elhep/CMOS_Camera/HL_SIM/results/thermal/sensor_brd.PNG

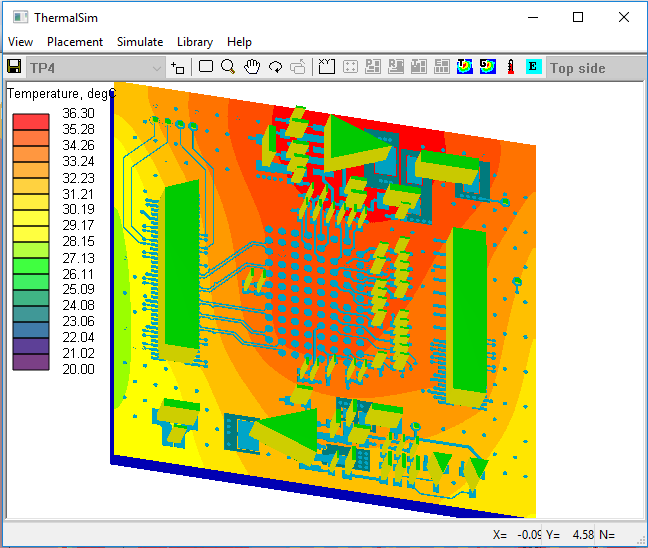
HL_SIM/results/thermal/sensor_brd.PNG
