elhep/CMOS_Camera/Spektrop2_Processor_Board_V1/docs/capacitors_gtp_placement.PNG

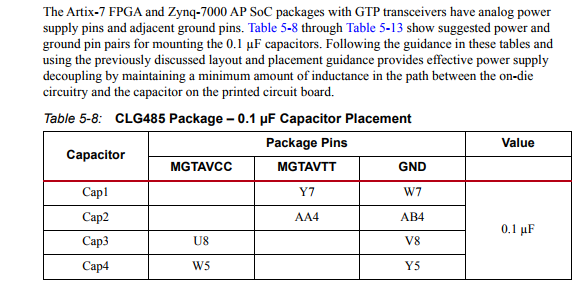
Spektrop2_Processor_Board_V1/docs/capacitors_gtp_placement.PNG
