elhep/CMOS_Camera/thesis/src/thesis.tex

\documentclass[a4paper,11pt,twoside]{report}
\usepackage[left=3cm,right=2cm,top=2.5cm,bottom=2.5cm]{geometry}
\include{thesis.preamble}

%Additional packages
\usepackage{pdfpages}
\usepackage{lipsum}
\usepackage{fontspec}
\setmainfont[Ligatures=TeX]{Arial}
\usepackage{acronym}
\usepackage[nonumberlist,nopostdot,toc]{glossaries}
%\usepackage{glossaries}
%\renewcommand{\glossarypreamble}{\scriptsize}
%\newcommand{\dictentry}[2]{%
%    \newglossaryentry{#1}{name=#1,description={#2}}%
%    \glslink{#1}{}%
%    \glsgroupskip
%}
\makeglossaries
\usepackage[toc,page]{appendix}

\begin{document}

%\title{\LARGE {\bf Compact embedded camera design and evaluation of high speed interfaces for hyper-spectral imaging applications}\\
% \vspace*{6mm}
%}

\author{Piotr Zdunek}
\submitdate{Warsaw, 2018}

%\normallinespacing
\linespread{1.15}
\pagenumbering{arabic}
\setlength{\parskip}{2ex plus 0.5ex minus 0.2ex}
\setlength{\parindent}{0.5cm}
%\maketitle

%TODO list of figures and tables needs to go at the end
%TODO put the numbers of pages on the sides  
%TODO change the font to times new roman
%\preface

\input{titlepage/titlepage}
\cleardoublepage
\input{abstract/abstract} %summary
\cleardoublepage
\includepdf[pages=-]{./titlepage/osw.pdf}
\pagestyle{empty}
\cleardoublepage
\tableofcontents
\newpage

\newglossaryentry{formula}
{
        name=formula,
        description={A mathematical expression}
}
 
\newacronym{gcd}{GCD}{Greatest Common Divisor}

%\body
\input{introduction/introduction}
%Here the whole genesis and the requirements of the projects are stated and defined. 
%After reading this chapter, the reader must understand what is going to be designed. 
%\input{genesis/genesis}
\input{concept/concept}
%How are we going to design it and what do we want to test
%\input{requirements/requirements}
\input{realisation/realisation}
%The development of the camera. 
\input{evaluation/evaluation}
%The tests of high speed interfaces.
\input{summary/summary}
%What is the outcome?
\gls{formula}

\addcontentsline{toc}{chapter}{Bibliography}
\bibliographystyle{unsrt}
\bibliography{bibliography/bibliography}

%glossary
\printglossary
%table of pictures 
\listoffigures
%list of appendices
\begin{appendices}
\chapter{Electrical characteristics}
The contents...
\chapter{Test }
The contents...
\end{appendices}
% appendices come here

\end{document}
