elhep/CMOS_Camera/thesis/src/abstract/abstract.tex

\begin{abstract}

Text of the Abstract.
%\lipsum[3-56]

Keywords: Camera, High-speed, Hyper-Spectral, Zynq, SDI, CoaXPress, PCIe, Aurora

\end{abstract}
