elhep/CMOS_Camera/Vivado/Spektrop2_CMV4000_V3/Spektrop2_CMV4000_V2.runs/design_1_v_vid_in_axi4s_0_0_synth_1/.vivado.begin.rst

<?xml version="1.0"?>
<ProcessHandle Version="1" Minor="0">
    <Process Command="vivado.bat" Owner="ZdunekPC" Host="DESKTOP-C5LKN8N" Pid="11436">
    </Process>
</ProcessHandle>
