elhep/CMOS_Camera/Vivado/Spektrop2_CMV4000_V3/Spektrop2_CMV4000_V2.ip_user_files/sim_scripts/sensor_readout/activehdl/file_info.txt

xpm_cdc.sv,systemverilog,xil_defaultlib,E:/Xilinx/Vivado/2017.4/data/ip/xpm/xpm_cdc/hdl/xpm_cdc.sv,incdir="../../../../Spektrop2_CMV4000_V2.srcs/sources_1/bd/sensor_readout/ipshared/0ab1/hdl"incdir="../../../../Spektrop2_CMV4000_V2.srcs/sources_1/bd/sensor_readout/ipshared/0ab1/hdl"
xpm_fifo.sv,systemverilog,xil_defaultlib,E:/Xilinx/Vivado/2017.4/data/ip/xpm/xpm_fifo/hdl/xpm_fifo.sv,incdir="../../../../Spektrop2_CMV4000_V2.srcs/sources_1/bd/sensor_readout/ipshared/0ab1/hdl"incdir="../../../../Spektrop2_CMV4000_V2.srcs/sources_1/bd/sensor_readout/ipshared/0ab1/hdl"
xpm_memory.sv,systemverilog,xil_defaultlib,E:/Xilinx/Vivado/2017.4/data/ip/xpm/xpm_memory/hdl/xpm_memory.sv,incdir="../../../../Spektrop2_CMV4000_V2.srcs/sources_1/bd/sensor_readout/ipshared/0ab1/hdl"incdir="../../../../Spektrop2_CMV4000_V2.srcs/sources_1/bd/sensor_readout/ipshared/0ab1/hdl"
xpm_VCOMP.vhd,vhdl,xpm,E:/Xilinx/Vivado/2017.4/data/ip/xpm/xpm_VCOMP.vhd,incdir="../../../../Spektrop2_CMV4000_V2.srcs/sources_1/bd/sensor_readout/ipshared/0ab1/hdl"incdir="../../../../Spektrop2_CMV4000_V2.srcs/sources_1/bd/sensor_readout/ipshared/0ab1/hdl"
v_vid_in_axi4s_v4_0_vl_rfs.v,verilog,v_vid_in_axi4s_v4_0_7,../../../../Spektrop2_CMV4000_V2.srcs/sources_1/bd/sensor_readout/ipshared/f931/hdl/v_vid_in_axi4s_v4_0_vl_rfs.v,incdir="../../../../Spektrop2_CMV4000_V2.srcs/sources_1/bd/sensor_readout/ipshared/0ab1/hdl"incdir="../../../../Spektrop2_CMV4000_V2.srcs/sources_1/bd/sensor_readout/ipshared/0ab1/hdl"
sensor_readout_v_vid_in_axi4s_0_0.v,verilog,xil_defaultlib,../../../bd/sensor_readout/ip/sensor_readout_v_vid_in_axi4s_0_0/sim/sensor_readout_v_vid_in_axi4s_0_0.v,incdir="../../../../Spektrop2_CMV4000_V2.srcs/sources_1/bd/sensor_readout/ipshared/0ab1/hdl"incdir="../../../../Spektrop2_CMV4000_V2.srcs/sources_1/bd/sensor_readout/ipshared/0ab1/hdl"
sensor_readout_v_vid_in_axi4s_0_1.v,verilog,xil_defaultlib,../../../bd/sensor_readout/ip/sensor_readout_v_vid_in_axi4s_0_1/sim/sensor_readout_v_vid_in_axi4s_0_1.v,incdir="../../../../Spektrop2_CMV4000_V2.srcs/sources_1/bd/sensor_readout/ipshared/0ab1/hdl"incdir="../../../../Spektrop2_CMV4000_V2.srcs/sources_1/bd/sensor_readout/ipshared/0ab1/hdl"
axis_infrastructure_v1_1_vl_rfs.v,verilog,axis_infrastructure_v1_1_0,../../../../Spektrop2_CMV4000_V2.srcs/sources_1/bd/sensor_readout/ipshared/0ab1/hdl/axis_infrastructure_v1_1_vl_rfs.v,incdir="../../../../Spektrop2_CMV4000_V2.srcs/sources_1/bd/sensor_readout/ipshared/0ab1/hdl"incdir="../../../../Spektrop2_CMV4000_V2.srcs/sources_1/bd/sensor_readout/ipshared/0ab1/hdl"
axis_combiner_v1_1_vl_rfs.v,verilog,axis_combiner_v1_1_14,../../../../Spektrop2_CMV4000_V2.srcs/sources_1/bd/sensor_readout/ipshared/cf24/hdl/axis_combiner_v1_1_vl_rfs.v,incdir="../../../../Spektrop2_CMV4000_V2.srcs/sources_1/bd/sensor_readout/ipshared/0ab1/hdl"incdir="../../../../Spektrop2_CMV4000_V2.srcs/sources_1/bd/sensor_readout/ipshared/0ab1/hdl"
sensor_readout_axis_combiner_0_0.v,verilog,xil_defaultlib,../../../bd/sensor_readout/ip/sensor_readout_axis_combiner_0_0/sim/sensor_readout_axis_combiner_0_0.v,incdir="../../../../Spektrop2_CMV4000_V2.srcs/sources_1/bd/sensor_readout/ipshared/0ab1/hdl"incdir="../../../../Spektrop2_CMV4000_V2.srcs/sources_1/bd/sensor_readout/ipshared/0ab1/hdl"
axis_register_slice_v1_1_vl_rfs.v,verilog,axis_register_slice_v1_1_15,../../../../Spektrop2_CMV4000_V2.srcs/sources_1/bd/sensor_readout/ipshared/cd45/hdl/axis_register_slice_v1_1_vl_rfs.v,incdir="../../../../Spektrop2_CMV4000_V2.srcs/sources_1/bd/sensor_readout/ipshared/0ab1/hdl"incdir="../../../../Spektrop2_CMV4000_V2.srcs/sources_1/bd/sensor_readout/ipshared/0ab1/hdl"
axis_dwidth_converter_v1_1_vl_rfs.v,verilog,axis_dwidth_converter_v1_1_14,../../../../Spektrop2_CMV4000_V2.srcs/sources_1/bd/sensor_readout/ipshared/1019/hdl/axis_dwidth_converter_v1_1_vl_rfs.v,incdir="../../../../Spektrop2_CMV4000_V2.srcs/sources_1/bd/sensor_readout/ipshared/0ab1/hdl"incdir="../../../../Spektrop2_CMV4000_V2.srcs/sources_1/bd/sensor_readout/ipshared/0ab1/hdl"
sensor_readout_axis_dwidth_converter_0_0.v,verilog,xil_defaultlib,../../../bd/sensor_readout/ip/sensor_readout_axis_dwidth_converter_0_0/sim/sensor_readout_axis_dwidth_converter_0_0.v,incdir="../../../../Spektrop2_CMV4000_V2.srcs/sources_1/bd/sensor_readout/ipshared/0ab1/hdl"incdir="../../../../Spektrop2_CMV4000_V2.srcs/sources_1/bd/sensor_readout/ipshared/0ab1/hdl"
sensor_readout.vhd,vhdl,xil_defaultlib,../../../bd/sensor_readout/sim/sensor_readout.vhd,incdir="../../../../Spektrop2_CMV4000_V2.srcs/sources_1/bd/sensor_readout/ipshared/0ab1/hdl"incdir="../../../../Spektrop2_CMV4000_V2.srcs/sources_1/bd/sensor_readout/ipshared/0ab1/hdl"
glbl.v,Verilog,xil_defaultlib,glbl.v
