elhep/CMOS_Camera/thesis/src/thesis.pdf

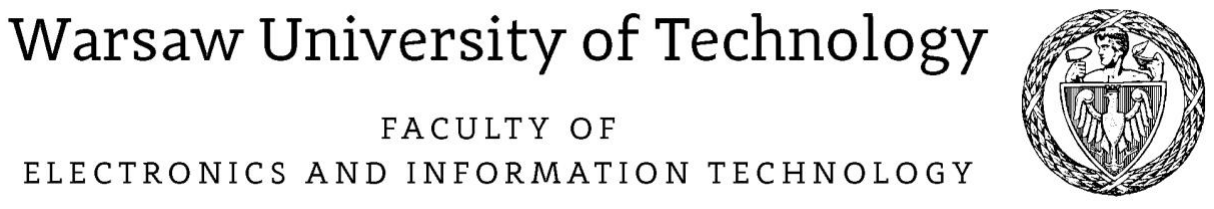
[picture p3: figure]

Institute of Electronic Systems

in the field of study Electronics and specialisation Microsystems and electronic systems

## Compact embedded camera and evaluation of high speed interfaces for hyper-spectral imaging applications

# Piotr Zdunek

student record book number 229417

Dr inż. Grzegorz Kasprowicz

Warsaw, 2018

Abstract

Text of the Abstract.

Keywords: Camera, High-speed, Hyper-Spectral, Zynq, SDI, CoaXPress, PCIe, Aurora

załącznik nr 10 do zarządzenia nr 46 /2016 Rektora PW

## Politechnika Warszawska

Warsaw University of Technology

### miejscowość i data

place and date

## Piotr Zdunek

### imię i nazwisko studenta

name and surname of the student

229417

### numer albumu

student record book number

## Elektronika

### kierunek studiów

field of study

## OŚWIADCZENIE

### DECLARATION

Świadomy/-a odpowiedzialności karnej za składanie fałszywych zeznań oświadczam,

## że niniejsza praca dyplomowa została napisana przeze mnie samodzielnie, pod opieką

kierującego pracą dyplomową.
Under the penalty of perjury, I hereby certify that I wrote my diploma thesis on my own, under the guidance of the thesis supervisor.

## Jednocześnie oświadczam, że:

### I also declare that:

## - niniejsza praca dyplomowa nie narusza praw autorskich w rozumieniu ustawy z dnia

4 lutego 1994 roku o prawie autorskim i prawach pokrewnych (Dz.U. z 2006 r. Nr 90, poz. 631 z późn. zm.) oraz dóbr osobistych chronionych prawem cywilnym,
- this diploma thesis does not constitute infringement of copyright following the act of 4 February 1994 on copyright and related rights (Journal of Acts of 2006 no. 90, item 631 with further amendments) or personal rights protected under the civil law,

## - niniejsza praca dyplomowa nie zawiera danych i informacji, które uzyskałem/-am

w sposób niedozwolony,
- the diploma thesis does not contain data or information acquired in an illegal way,

## - niniejsza praca dyplomowa nie była wcześniej podstawą żadnej innej urzędowej

procedury związanej z nadawaniem dyplomów lub tytułów zawodowych,
- the diploma thesis has never been the basis of any other official proceedings leading to the award of diplomas or professional degrees,

## - wszystkie informacje umieszczone w niniejszej pracy, uzyskane ze źródeł pisanych i elektronicznych, zostały udokumentowane w wykazie literatury odpowiednimi

odnośnikami,
- all information included in the diploma thesis, derived from printed and electronic sources, has been documented with relevant references in the literature section,

## - znam regulacje prawne Politechniki Warszawskiej w sprawie zarządzania prawami autorskimi i prawami pokrewnymi, prawami własności przemysłowej oraz zasadami

komercjalizacji.

1 / 2 załącznik nr 10 do zarządzenia
Politechnika Warszawska | nr 46/2016 Rektora
PW
Warsaw University of Technology

### - I am aware of the regulations at Warsaw University of Technology on management of

copyright and related rights, industrial property rights and commercialisation.

## Oświadczam, że treść pracy dyplomowej w wersji drukowanej, treść pracy dyplomowej zawartej na nośniku elektronicznym (płycie kompaktowej) oraz treść pracy dyplomowej

w module APD systemu USOS są identyczne.
I certify that the content of the printed version of the diploma thesis, the content of the electronic version of the diploma thesis (on a CD) and the content of the diploma thesis in the Archive of Diploma Theses (APD module) of the USOS system are identical.

### czytelny podpis studenta

legible signature of the student

# Contents

1 Introduction | 9
2 Concept of design | 11
3 Camera design | 12

4 Evaluation of high speed interfaces for aerial hyper-spectral camera | 14
5 Summary | 15
Bibliography | 15
Glossary | 17
Appendices | 19
A Electrical characteristics | 20
B Test | 21

# Chapter 1

# Introduction

In this Master Thesis a design of an embedded camera and an evaluation of high speed interfaces is presented. The project is a part of a research project carried out by Center of space research in Warsaw. In this chapter a genesis of the project is presented as well as camera’s main requirements. Additionally a literature review is shown together with market review. At the end of the chapter a thesis statement is presented.

## 1.1 Project genesis

In this master thesis a design of a compact embedded camera as well as an evaluation of high speed interfaces for aerial hyper-spectral imaging application is presented. The project was completed at Photonics and Web Engineering Group at the Institute of Electronics Systems which has a significant contribution in scientific camera development. [1]. Having a scientific cooperation with Institute of Space Research, there was a need to develop hardware, firmware and evaluate the use of different high-speed interfaces for novel hyperspectral camera.

Specifically, a camera is needed inside of hyperspectral imaging camera for high speed data sensor acquisition, filtering and transmission. Additionally the camera, needs to support different sensor types which have different parameters in order to evaluate their usefulness in the hyper-spectral application. On top of that, the system is planned to be used in aerial vehicles (such as planes or drones) it needs to exhibit optimal SWAP factor and have interfaces who are highly reliable in this conditions.

### 1.1.1 Motivation

## 1.2 Requirements

### 1.2.1 Literature review

### 1.2.2 Market review

## 1.3 Thesis statement

# Chapter 2

# Concept of design

In this chapter a concept of the design of the camera is presented. First of all, main camera requirements are shown and juxtaposed with possible solutions. Afterwards the specification of the design is described in detail.

## 2.1 Main requirements

- Framerate at 100 fps at 2048 x 2048 resolution
- High speed interface
- Processing capability
- Possible IMU integration

## 2.2 Specification

- Framerate at 180 fps at 2048 x 2048 resolution for CMV4000 and 100 fps for CIS1910F
- 6.25 Gbps interfaces: SDI, CoaXPress, Aurora, PCie
- FPGA fabric for processing ability
- RS485 for communication with IMU and master controller

# Chapter 3

# Camera design

In this chapter a design of the camera is presented . First of all, an electrical design is shown of the processor board as well as of the sensor board. Next, the hardware design is presented together with SI/PI simulation. At the end of the chapter, measurements of physical characteristics of the boards are presented.

## 3.1 Processor board

### 3.1.1 Architecture

### 3.1.2 Zynq 7Z015 - Main processing unit

### 3.1.3 High speed interfaces

SDI

CoaXPress

PCIe/Aurora

### 3.1.4 Sensor connection

CMV4000

CIS1910F

### 3.1.5 Control - RS485

### 3.1.6 PCB Layout

### 3.1.7 Power Supply

### 3.1.8 SI/PI simulations

## 3.2 Sensor board

### 3.2.1 CIS1910F

### 3.2.2 CMV4000

## 3.3 Software

## 3.4 Digital system design

# Chapter 4

# Evaluation of high speed interfaces for aerial hyper-spectral camera

In this chapter an evaluation of high speed interfaces for aerial hyper-spectral application is presented. Firstly, the hypothesis of the evaluation is stated, then two high speed interfaces are used for hypothesis testing. At the end the results of the study are presented.

# Chapter 5

# Summary

In this chapter the summary of the master thesis is presented. Firstly the thesis objectives are contrasted with the final results. Then the main aspects of the work are shown with the description of possible future work. At the end the final summary is shown.

## 5.1 Thesis objectives and results

## 5.2 Future work

## 5.3 Final summary

formula

# Bibliography

[1] Krzysztof Pozniak Ryszard Romaniuk Grzegorz Wrochna Maciej Kwiatkowski, Grzegorz Kasprowicz. Advanced camera image data acquisition system for pi-of-the-sky, 2008.

# Glossary

formula A mathematical expression

# List of Figures

# Appendices

# Appendix A

# Electrical characteristics

The contents...

# Appendix B

# Test

The contents...
