elhep/CMOS_Camera/thesis/doc/okładka EITI-mgr-16.pdf

WYDZIAŁ ELEKTRONIKI

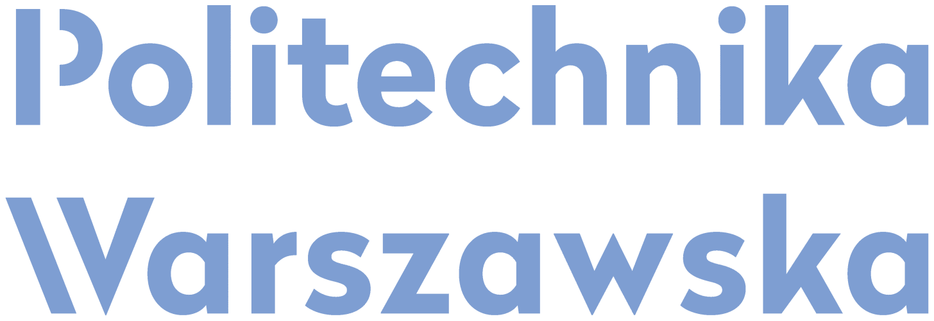
[picture p4: figure]
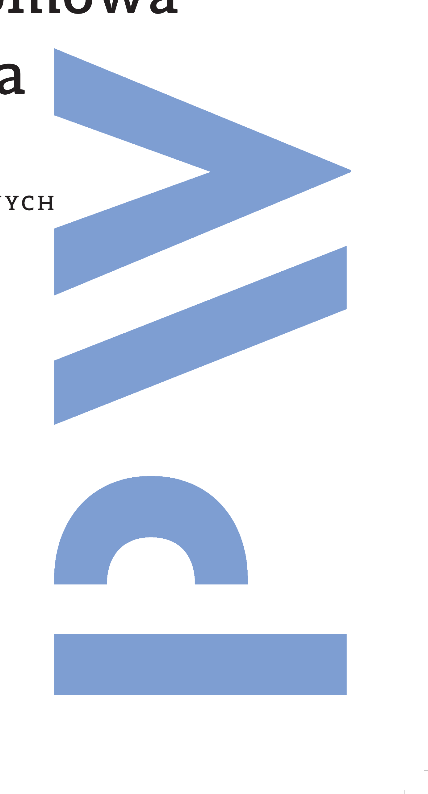
[picture p5: figure]

I TECHNIK INFORMACYJNYCH

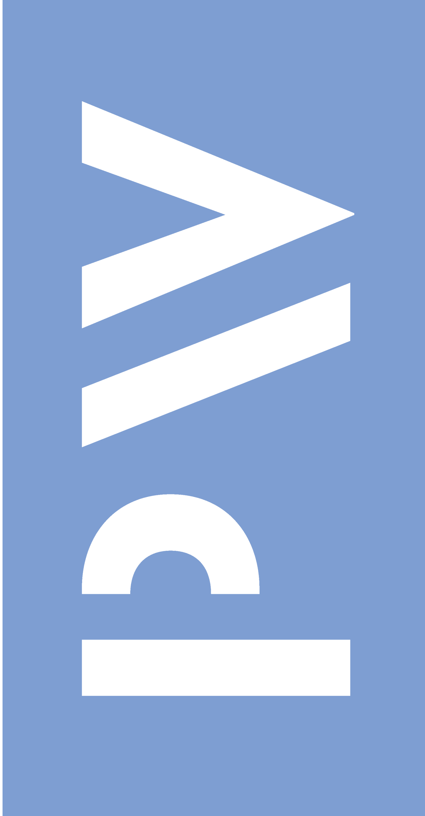
[picture p6: figure]

# Praca dyplomowa magisterska
