elhep/CMOS_Camera/thesis/doc/z_28_2016.pdf

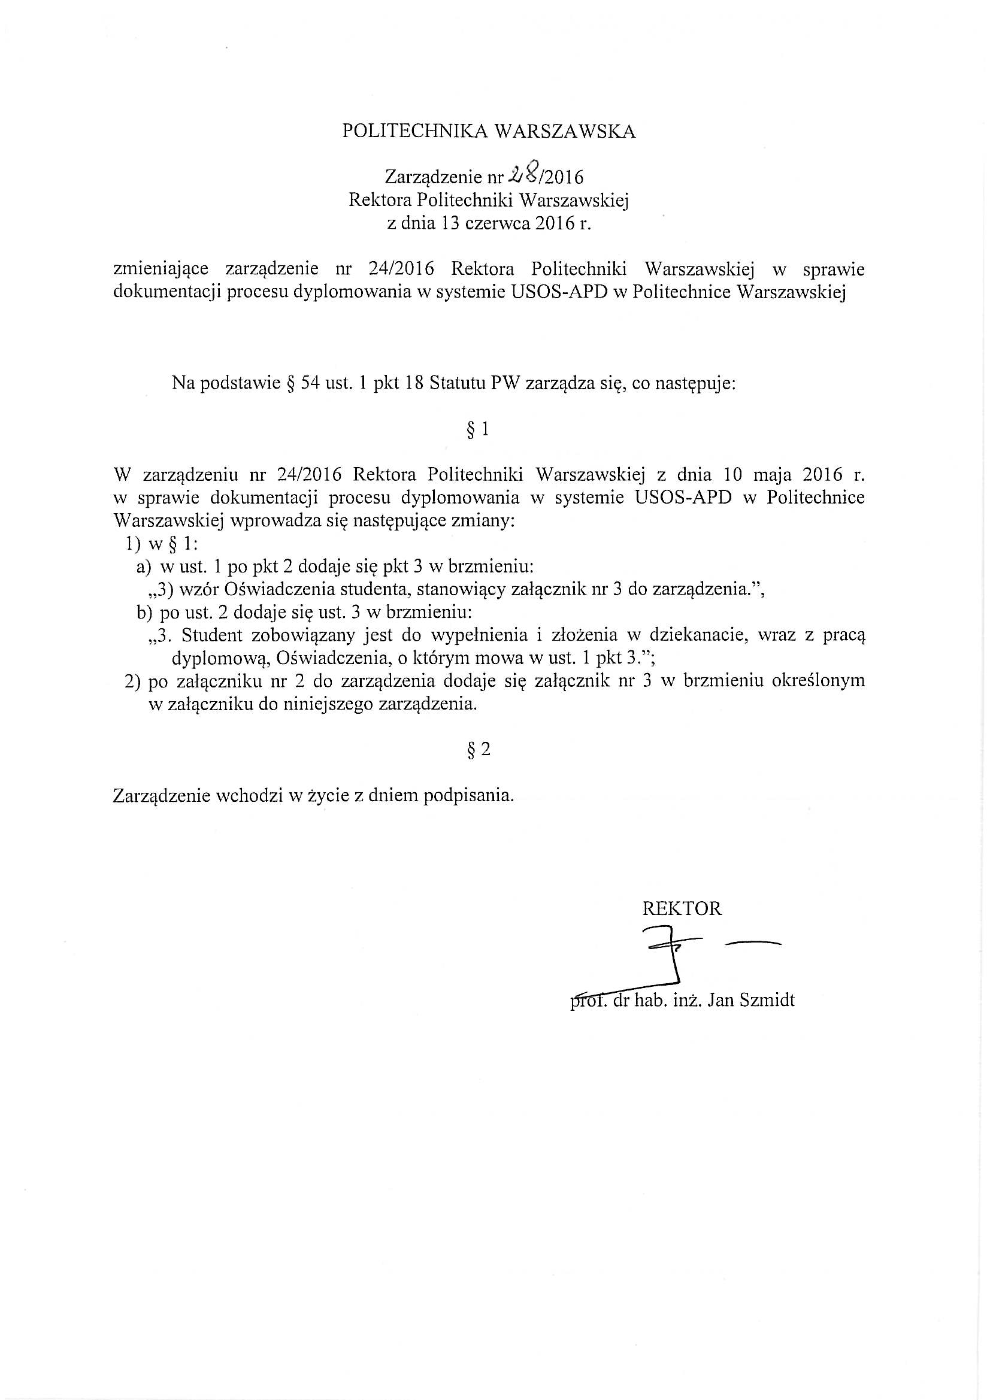
[picture p7: page 1]
