elhep/CMOS_Camera/Vivado/Spektrop2_CMV4000_V2/Spektrop2_CMV4000_V2.runs/impl_1/.init_design.begin.rst

<?xml version="1.0"?>
<ProcessHandle Version="1" Minor="0">
    <Process Command=".planAhead." Owner="ZdunekPC" Host="DESKTOP-C5LKN8N" Pid="5812">
    </Process>
</ProcessHandle>
