elhep/CMOS_Camera/Production/Version1/spektrop2_brandner_configuration.PNG

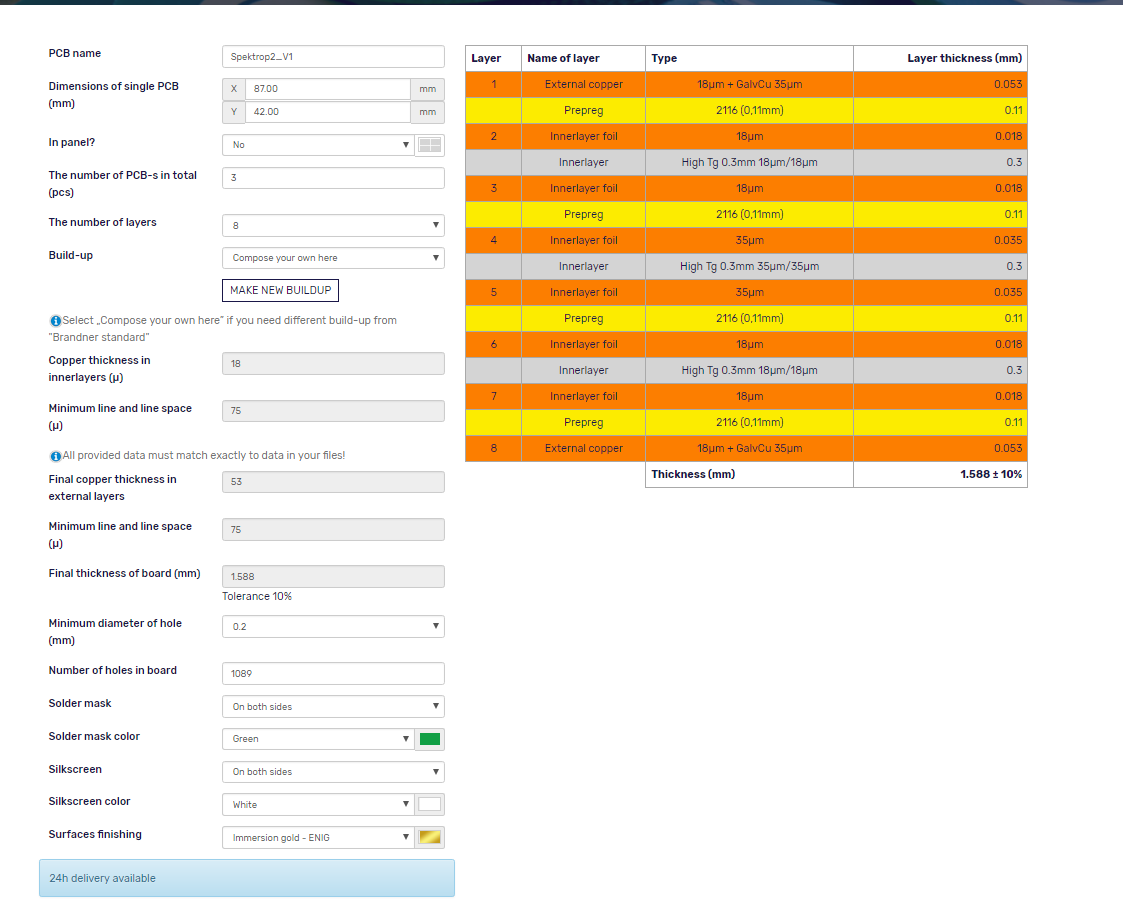
Production/Version1/spektrop2_brandner_configuration.PNG
