elhep/CMOS_Camera/Spektrop2_Processor_Board_V1/docs/50Ohm_internal.PNG

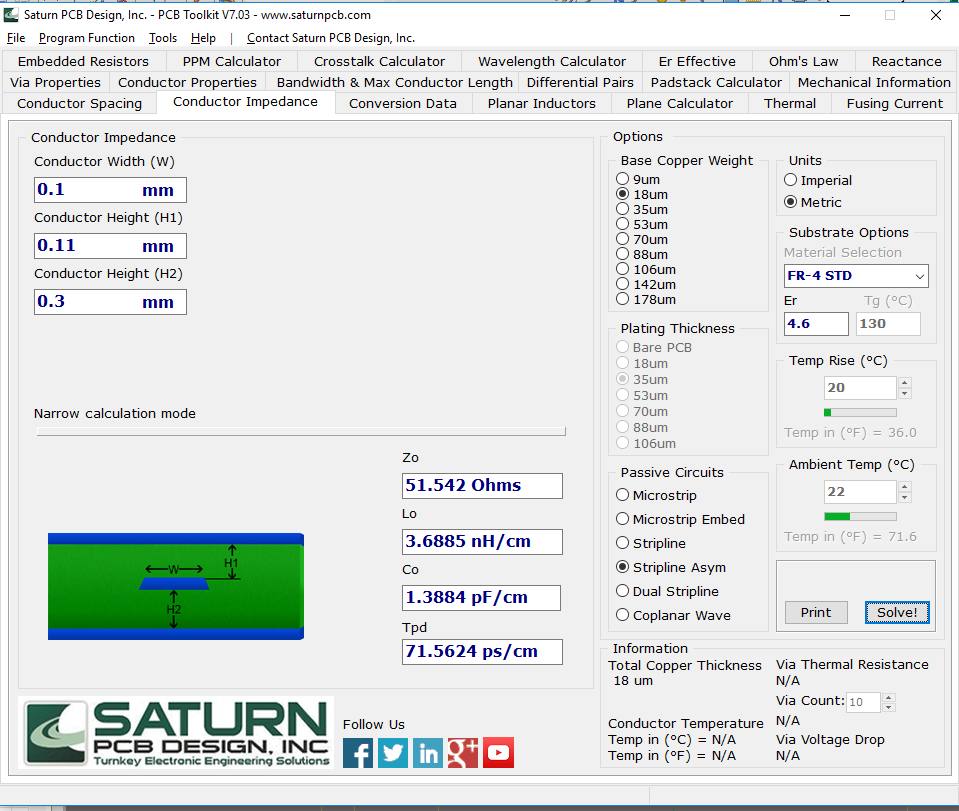
Spektrop2_Processor_Board_V1/docs/50Ohm_internal.PNG
