elhep/CMOS_Camera/Spektrop2_Processor_Board_V1/docs/75_ohm_coplanar_wave.PNG

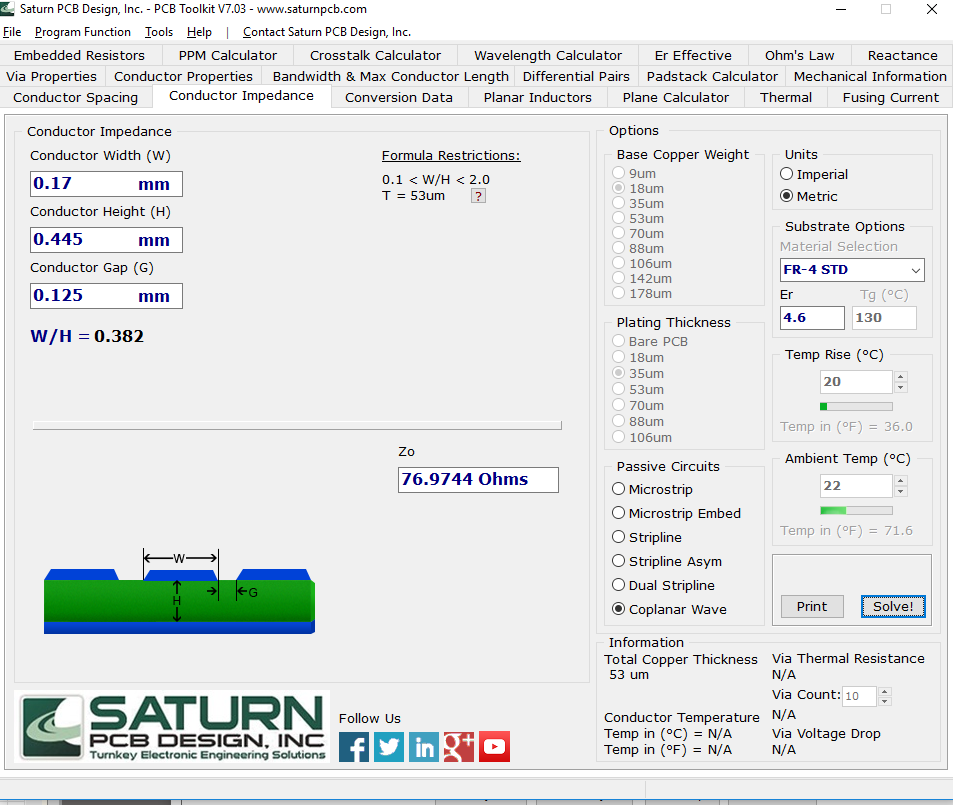
Spektrop2_Processor_Board_V1/docs/75_ohm_coplanar_wave.PNG
