elhep/CMOS_Camera/Spektrop2_Processor_Board_V1/docs/75_ohm_microstrip.PNG

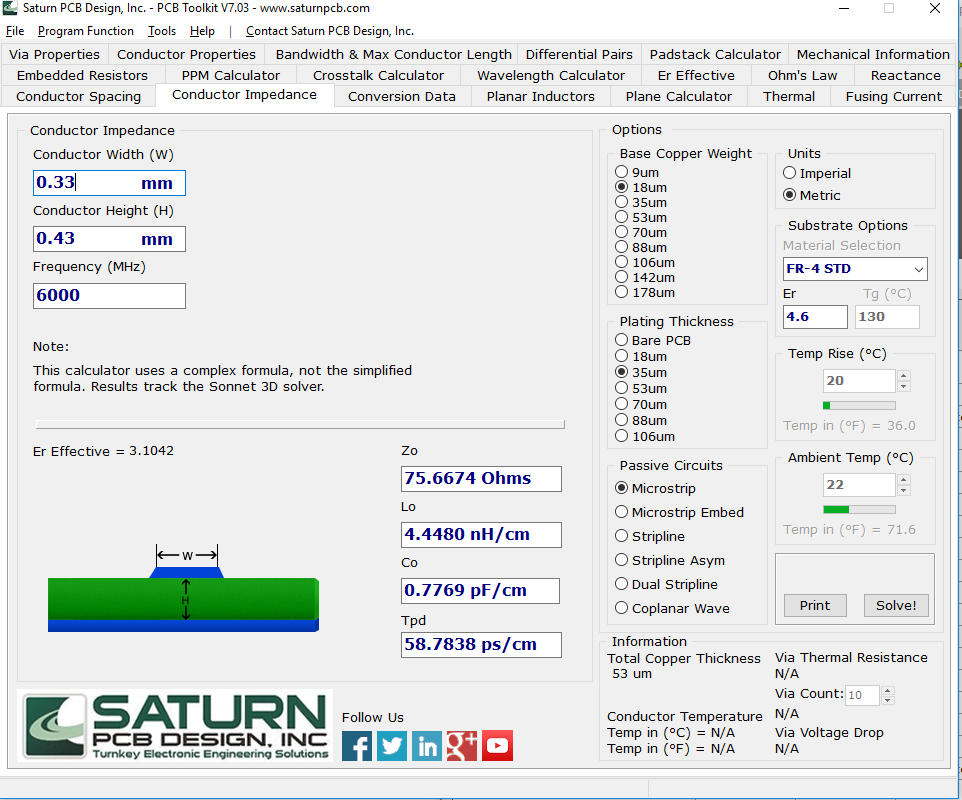
Spektrop2_Processor_Board_V1/docs/75_ohm_microstrip.PNG
