elhep/CMOS_Camera/Spektrop2_Processor_Board_V1/docs/block_diagram.PNG

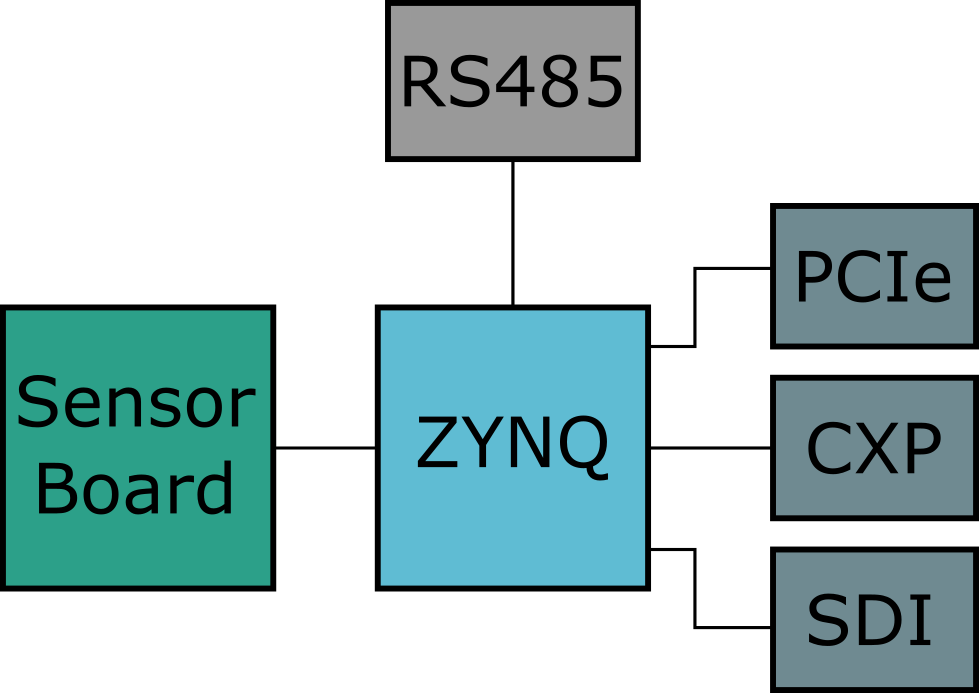
Spektrop2_Processor_Board_V1/docs/block_diagram.PNG
