elhep/CMOS_Camera/Spektrop2_Processor_Board_V1/docs/camera_3d_cis1910f.PNG

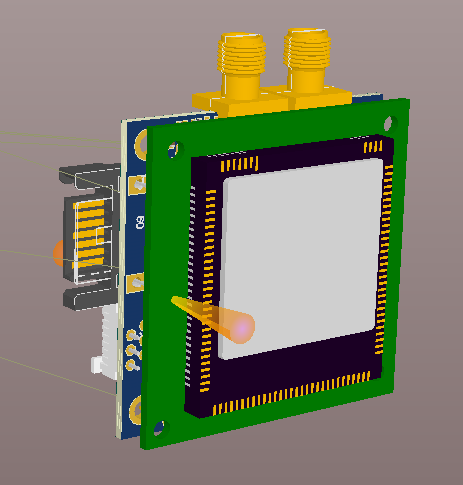
Spektrop2_Processor_Board_V1/docs/camera_3d_cis1910f.PNG
