elhep/CMOS_Camera/Spektrop2_Processor_Board_V1/docs/capacitors_gtp.PNG

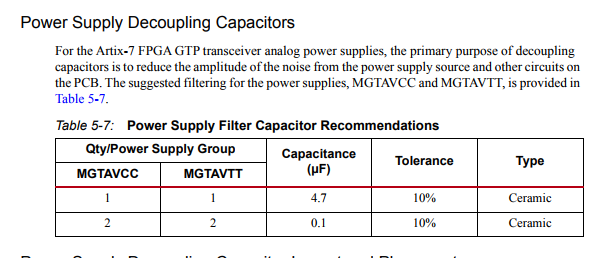
Spektrop2_Processor_Board_V1/docs/capacitors_gtp.PNG
