elhep/CMOS_Camera/Spektrop2_Processor_Board_V1/docs/capacitors_zynq.PNG

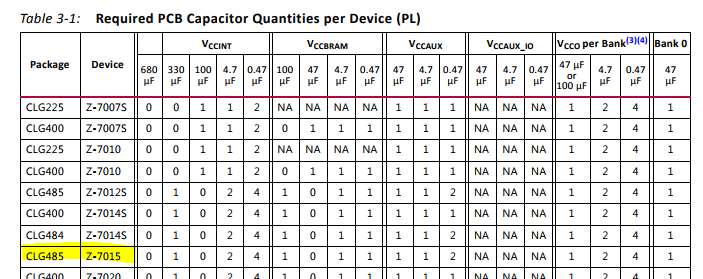
Spektrop2_Processor_Board_V1/docs/capacitors_zynq.PNG
