elhep/CMOS_Camera/Spektrop2_Processor_Board_V1/docs/cmv4000_optical_center.PNG

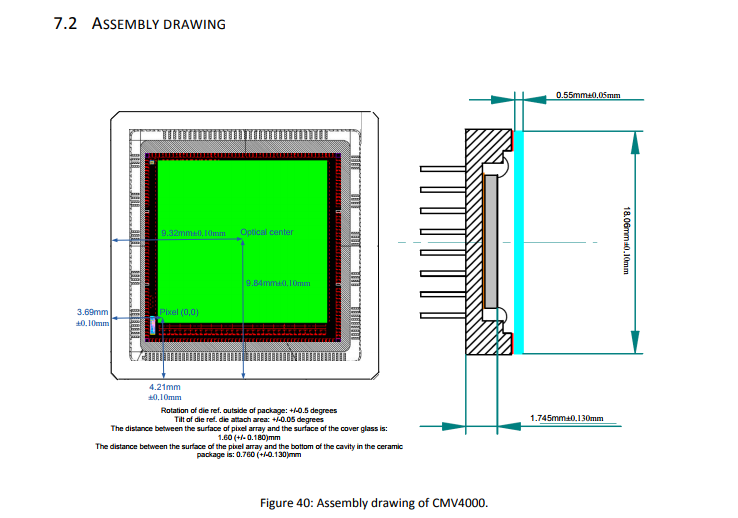
Spektrop2_Processor_Board_V1/docs/cmv4000_optical_center.PNG
