elhep/CMOS_Camera/Spektrop2_Processor_Board_V1/docs/coaxpress_layout_pz.PNG

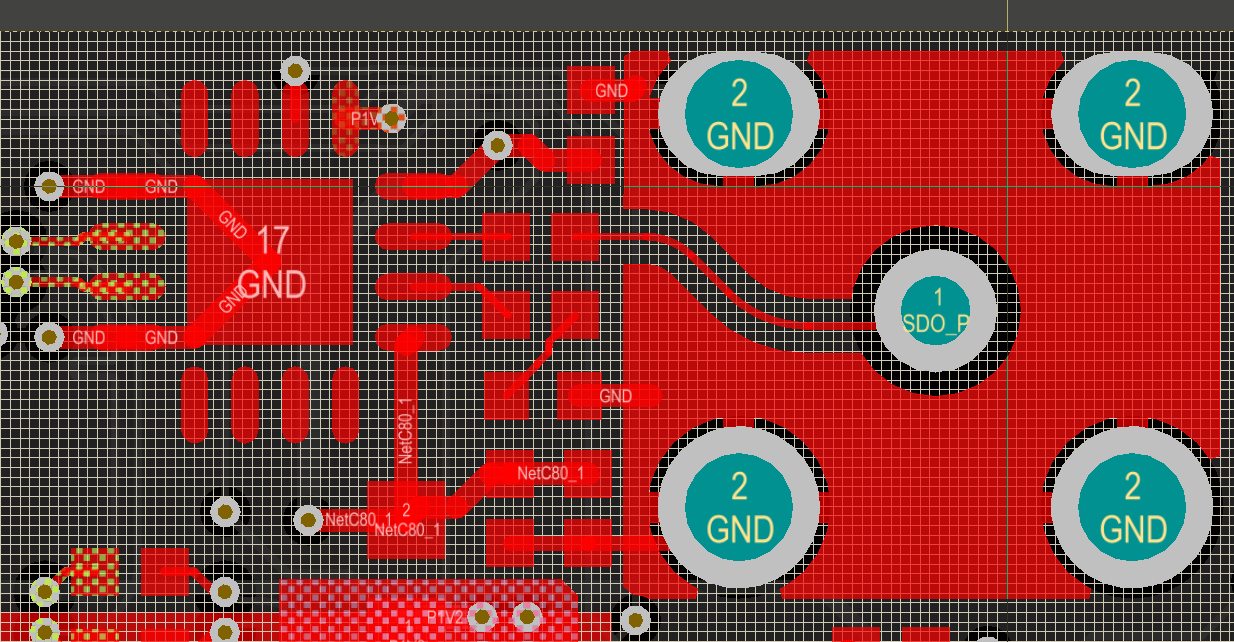
Spektrop2_Processor_Board_V1/docs/coaxpress_layout_pz.PNG
