elhep/CMOS_Camera/Spektrop2_Processor_Board_V1/docs/coaxpress_transmitter.PNG

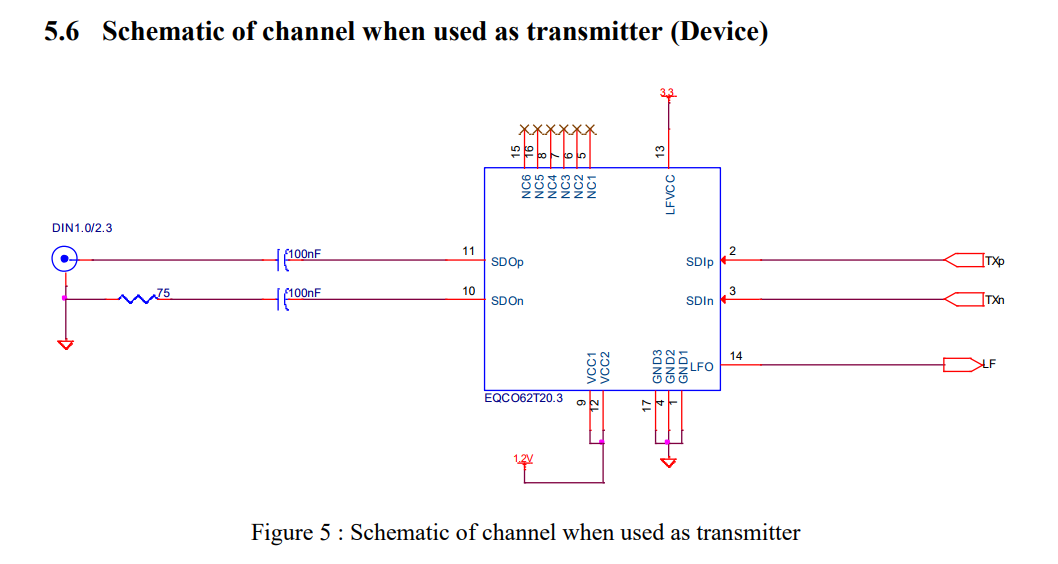
Spektrop2_Processor_Board_V1/docs/coaxpress_transmitter.PNG
