elhep/CMOS_Camera/Spektrop2_Processor_Board_V1/docs/dci_hstl_7series.PNG

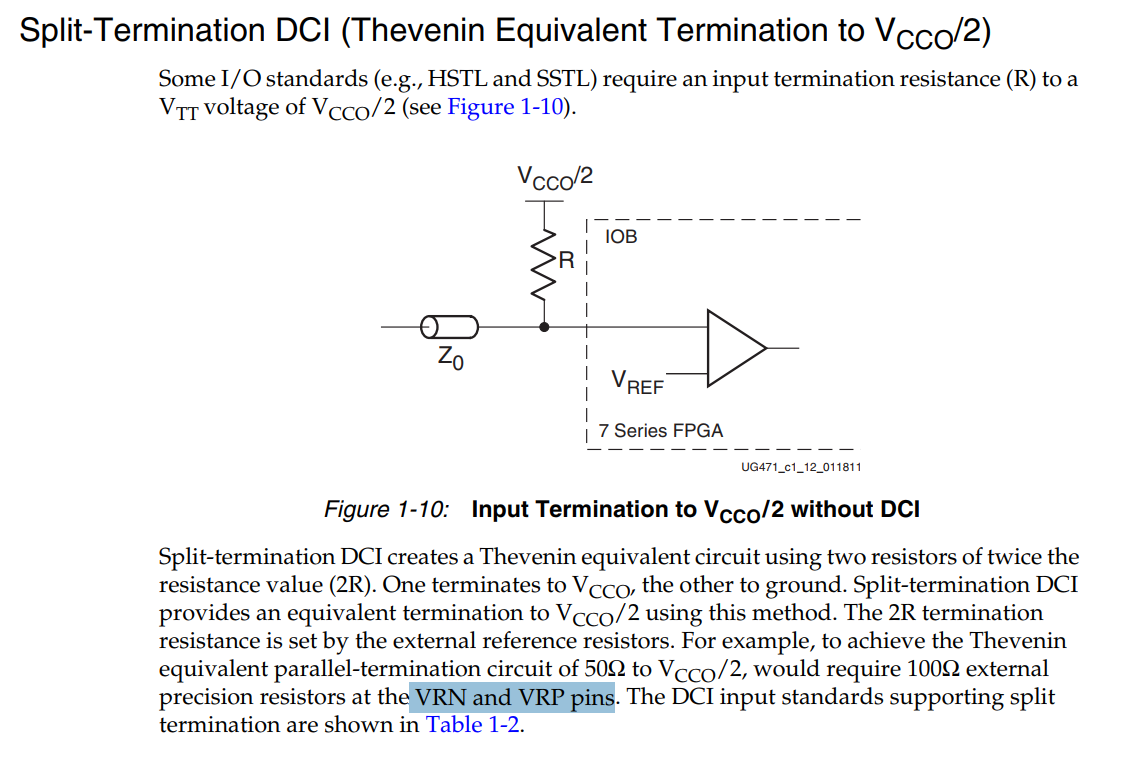
Spektrop2_Processor_Board_V1/docs/dci_hstl_7series.PNG
