elhep/CMOS_Camera/Spektrop2_Processor_Board_V1/docs/diff_inner_8layers.PNG

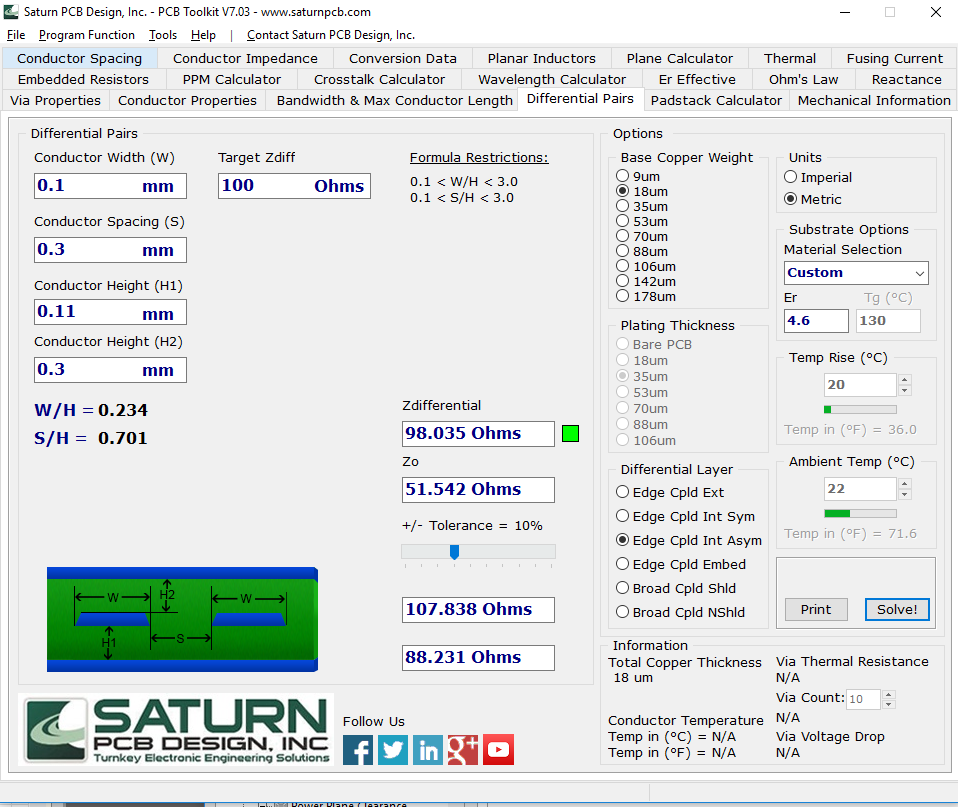
Spektrop2_Processor_Board_V1/docs/diff_inner_8layers.PNG
