elhep/CMOS_Camera/Spektrop2_Processor_Board_V1/docs/diff_pair_top_btm_8layers.PNG

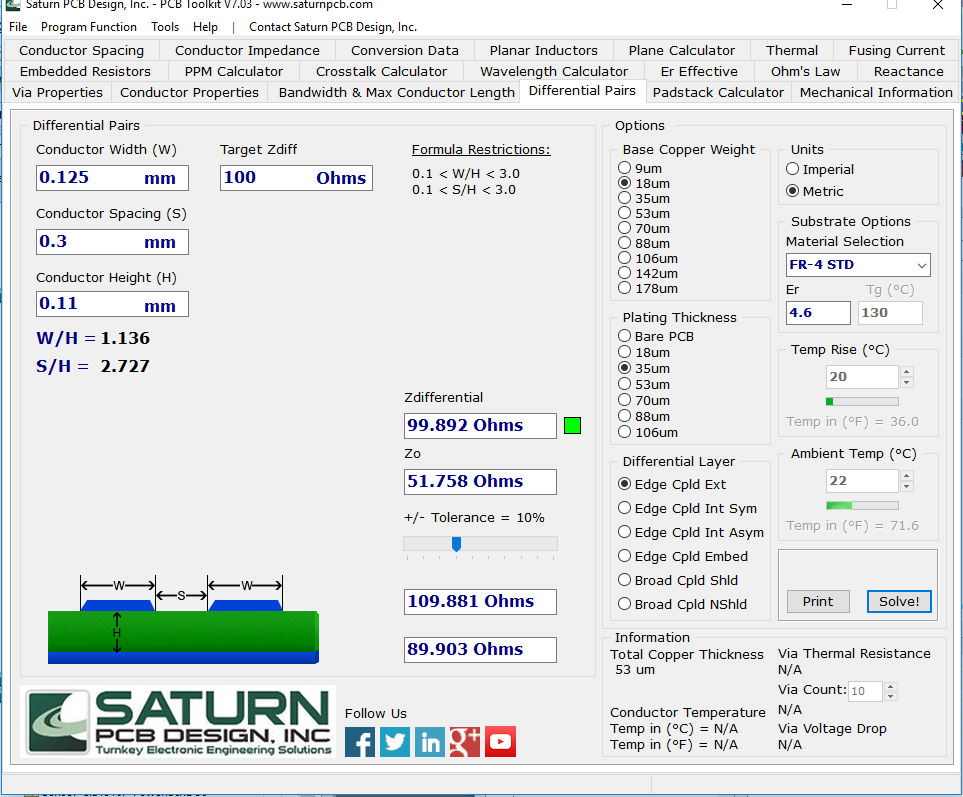
Spektrop2_Processor_Board_V1/docs/diff_pair_top_btm_8layers.PNG
