elhep/CMOS_Camera/Spektrop2_Processor_Board_V1/docs/erf5_connector_friction_lock.PNG

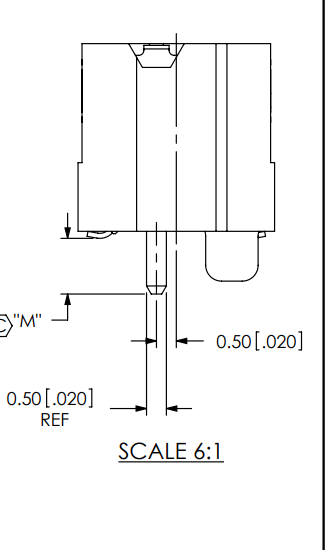
Spektrop2_Processor_Board_V1/docs/erf5_connector_friction_lock.PNG
