elhep/CMOS_Camera/Spektrop2_Processor_Board_V1/docs/GS6080.PNG

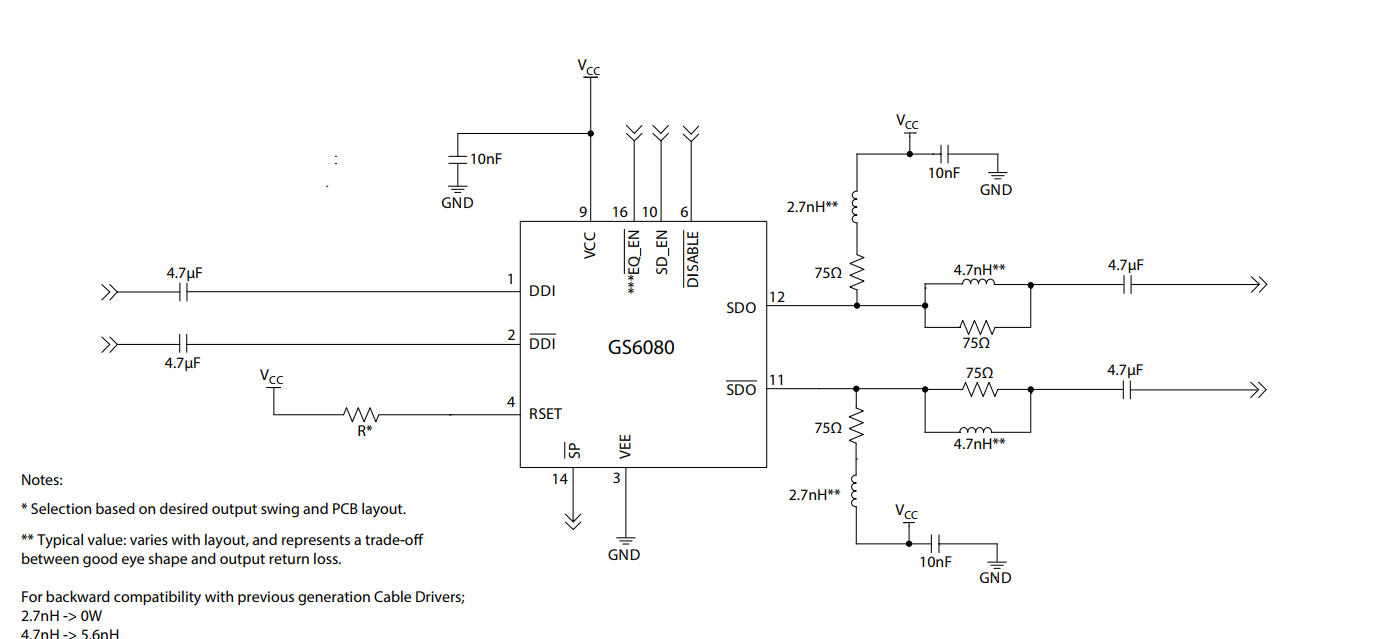
Spektrop2_Processor_Board_V1/docs/GS6080.PNG
