elhep/CMOS_Camera/Spektrop2_Processor_Board_V1/docs/HSTL_Typical_termination2.PNG

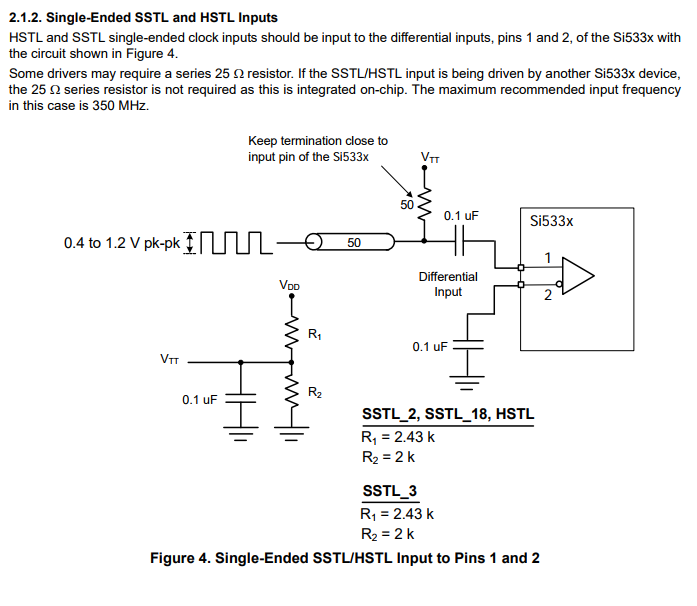
Spektrop2_Processor_Board_V1/docs/HSTL_Typical_termination2.PNG
