elhep/CMOS_Camera/Spektrop2_Processor_Board_V1/docs/LMZ21701_1V8.PNG

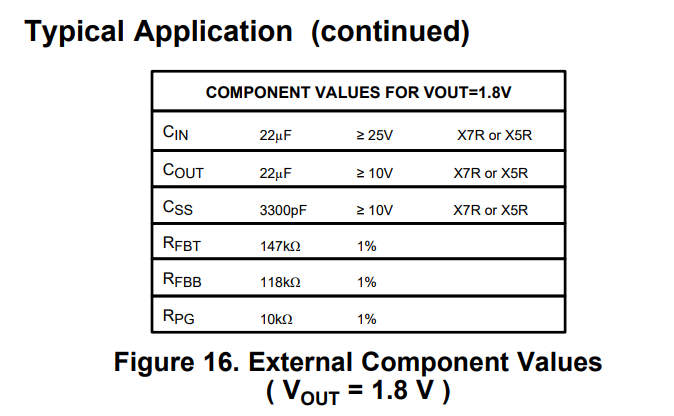
Spektrop2_Processor_Board_V1/docs/LMZ21701_1V8.PNG
