elhep/CMOS_Camera/Spektrop2_Processor_Board_V1/docs/LVPECLK_si5340.PNG

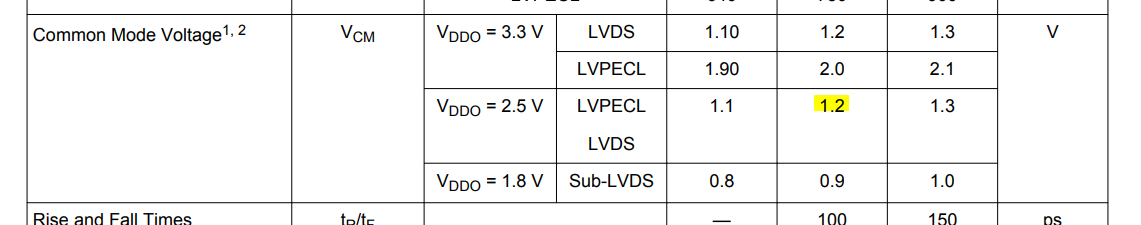
Spektrop2_Processor_Board_V1/docs/LVPECLK_si5340.PNG
