elhep/CMOS_Camera/Spektrop2_Processor_Board_V1/docs/mio_at_a_glance_zynq.PNG

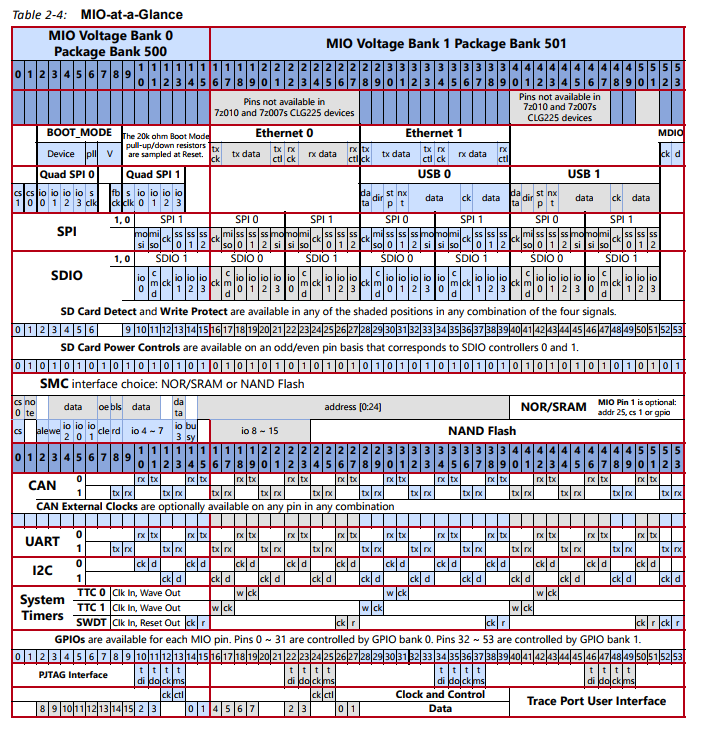
Spektrop2_Processor_Board_V1/docs/mio_at_a_glance_zynq.PNG
