elhep/CMOS_Camera/Spektrop2_Processor_Board_V1/docs/mio_boot_pins.PNG

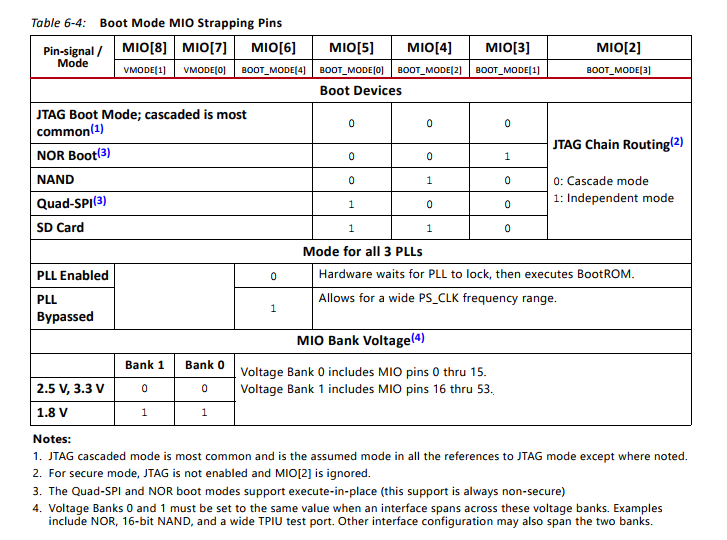
Spektrop2_Processor_Board_V1/docs/mio_boot_pins.PNG
