elhep/CMOS_Camera/Spektrop2_Processor_Board_V1/docs/power_consumption_estimation2.png

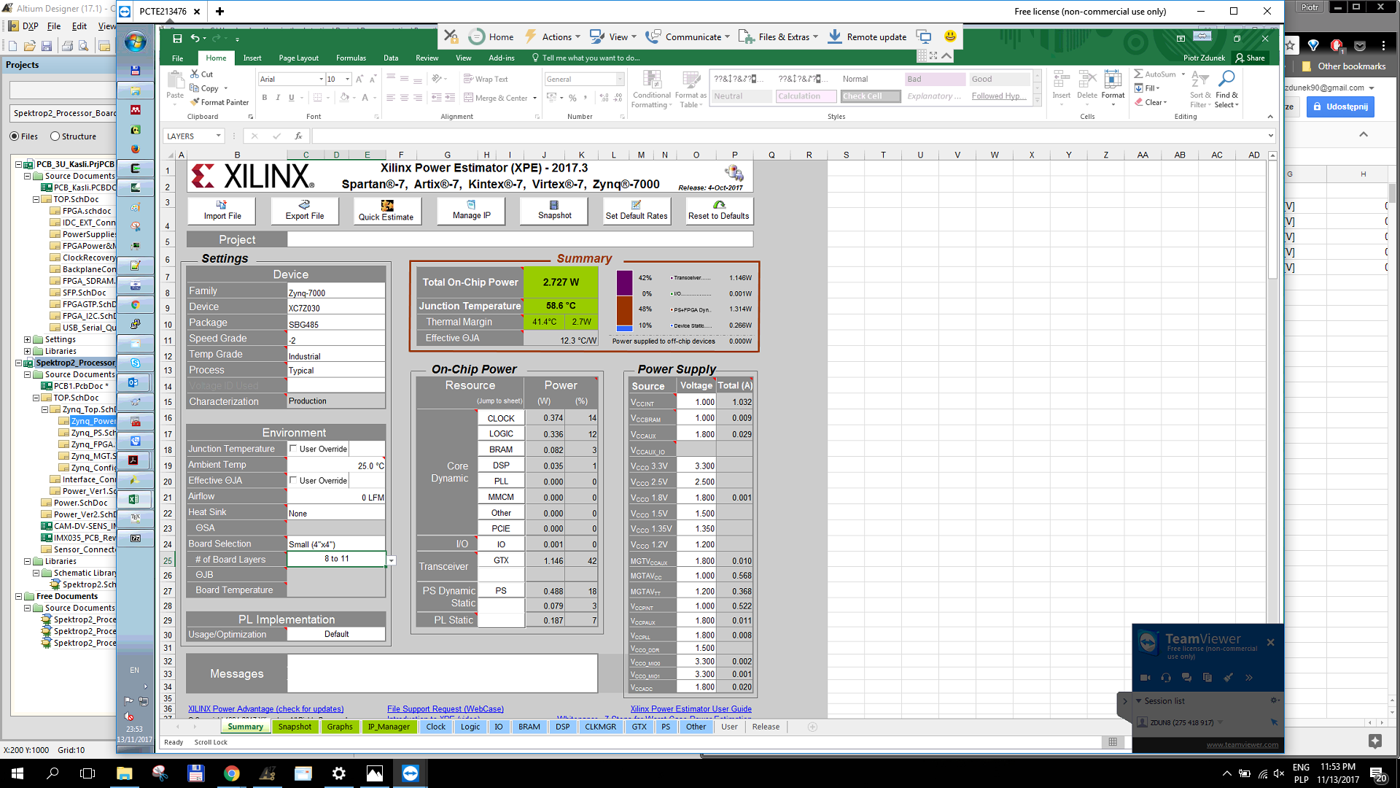
Spektrop2_Processor_Board_V1/docs/power_consumption_estimation2.png
