elhep/CMOS_Camera/Spektrop2_Processor_Board_V1/docs/ps_bank_voltage_sel.PNG

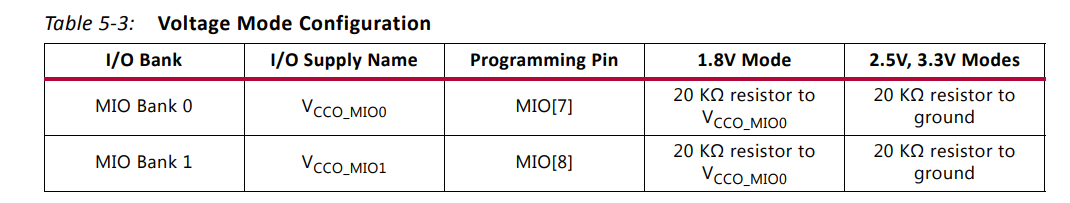
Spektrop2_Processor_Board_V1/docs/ps_bank_voltage_sel.PNG
