elhep/CMOS_Camera/Spektrop2_Processor_Board_V1/docs/pudc_b.PNG

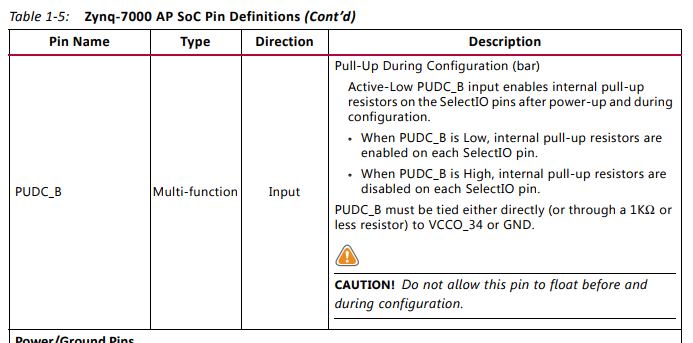
Spektrop2_Processor_Board_V1/docs/pudc_b.PNG
