elhep/CMOS_Camera/Spektrop2_Processor_Board_V1/docs/rs485_configuration.PNG

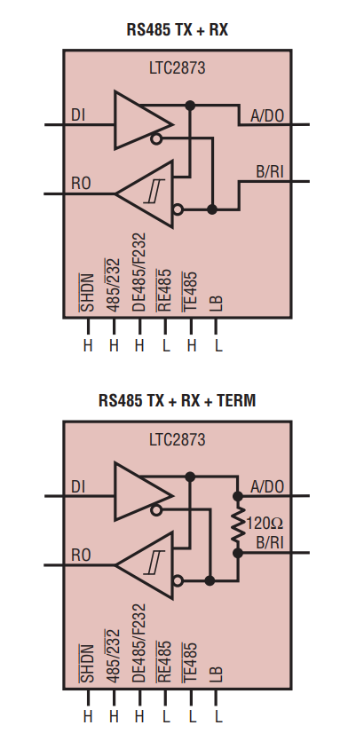
Spektrop2_Processor_Board_V1/docs/rs485_configuration.PNG
