elhep/CMOS_Camera/Spektrop2_Processor_Board_V1/docs/SATA.PNG

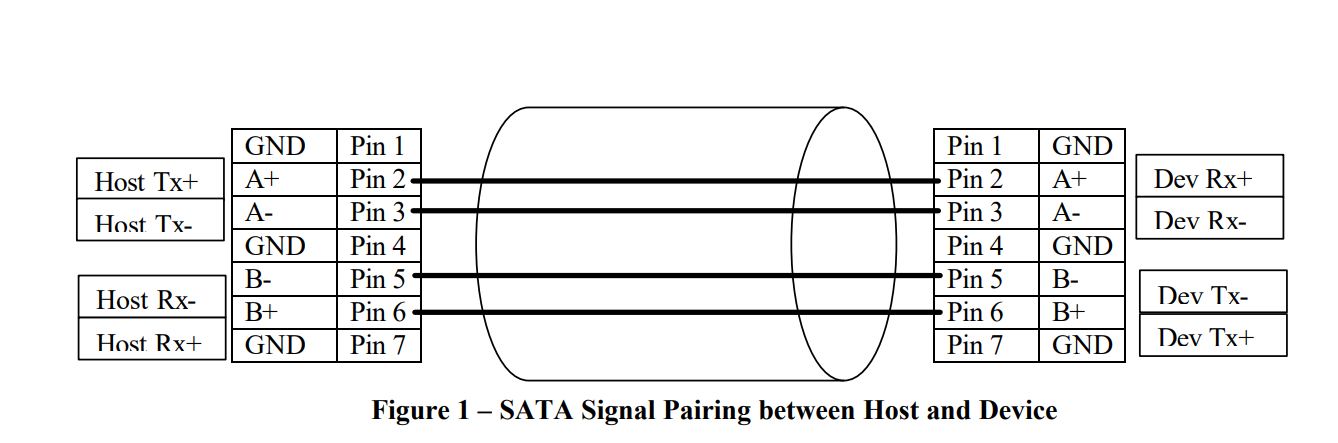
Spektrop2_Processor_Board_V1/docs/SATA.PNG
