elhep/CMOS_Camera/Spektrop2_Processor_Board_V1/docs/threshold_voltage_table.PNG

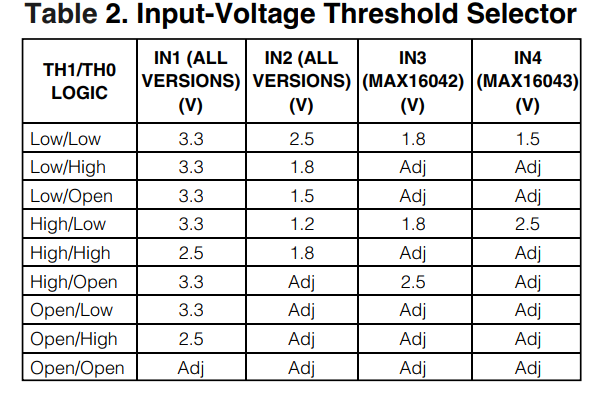
Spektrop2_Processor_Board_V1/docs/threshold_voltage_table.PNG
