elhep/CMOS_Camera/Spektrop2_Processor_Board_V1/docs/vrn_vrp.PNG

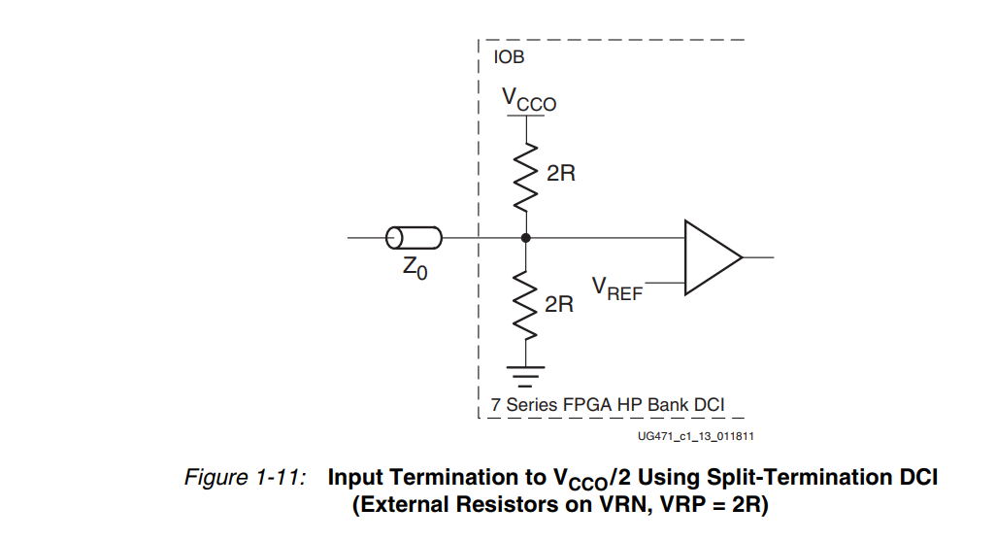
Spektrop2_Processor_Board_V1/docs/vrn_vrp.PNG
