elhep/CMOS_Camera/thesis/atlassian/power_supply_consideration/power_supply_consideration.PNG

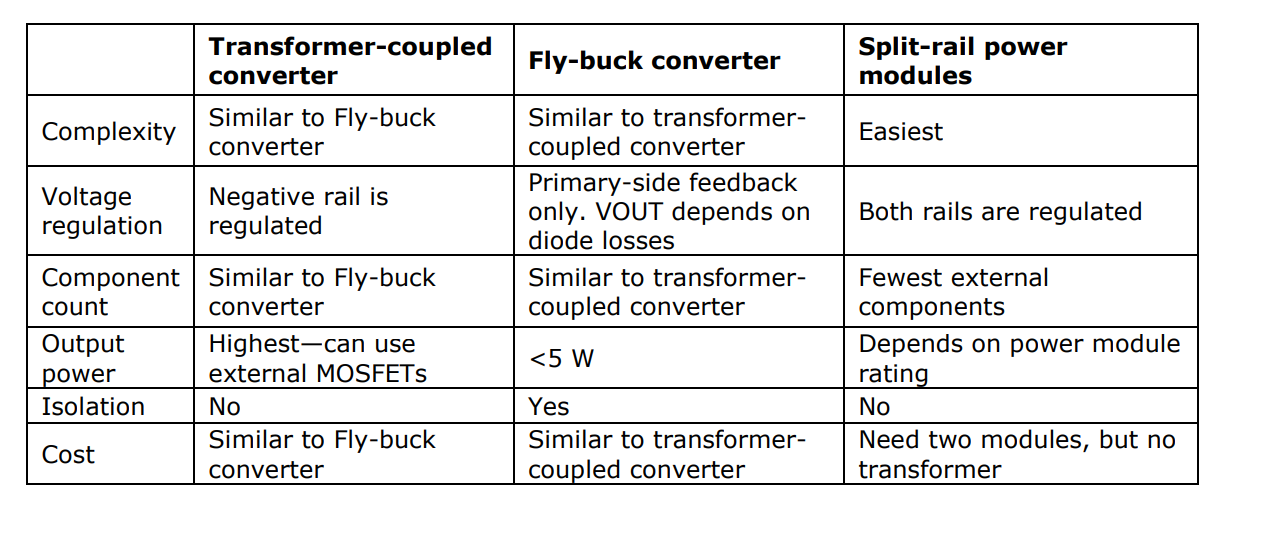
thesis/atlassian/power_supply_consideration/power_supply_consideration.PNG
