elhep/CMOS_Camera/thesis/atlassian/power_supply_consideration/screenshot-1.png

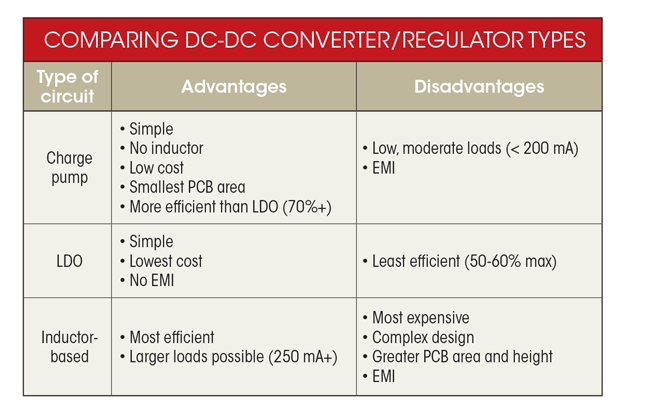
thesis/atlassian/power_supply_consideration/screenshot-1.png
