elhep/CMOS_Camera/HL_SIM/Spektrop2_Sensor_Board_CMV4000_V1/Spektrop2_Sensor_Board_CMV4000_V1.step

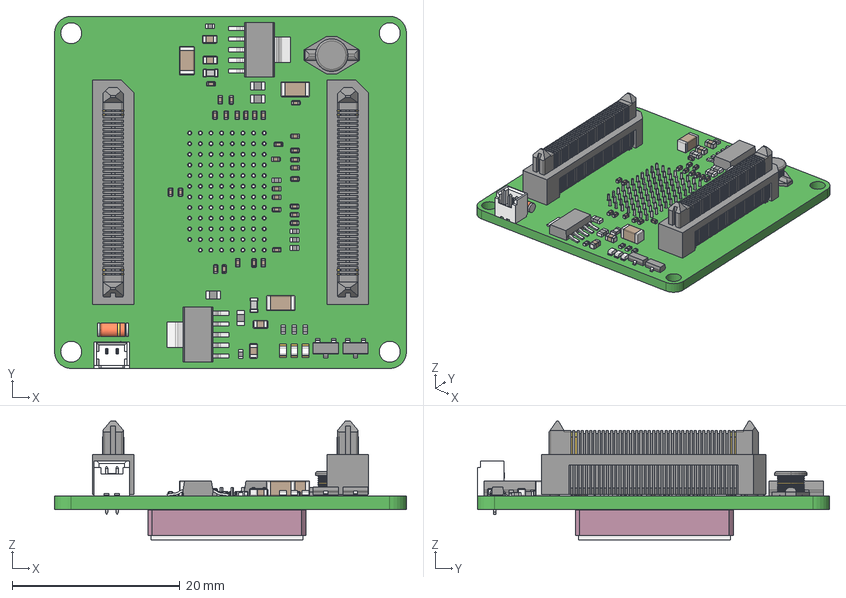
[picture p43: CAD file, 2018-01-24]
HL_SIM/Spektrop2_Sensor_Board_CMV4000_V1/Spektrop2_Sensor_Board_CMV4000_V1.step
42.0 x 42.0 x 14.2 mm
Board
RESC1005X40N x 9
SOT127P700X180-6N x 2
CAPC1005X55N x 31
CAPC3216X180N x 3
RESC1608X55N x 4
CAPC1608X87N x 4
INDC1608X65N x 2
IND_BOURNS_SDR6603
CMOSIS_CMV4000
SAMTEC_ERM5-040-05.0-L-DV-K x 2
DIOMELF3515N
MOLEX_53047-0210
LED_KINGBRIGHT_KPH-1608CGCK_Part2 x 3
LED_KINGBRIGHT_KPH-1608CGCK_Part1 x 3
SOT95P230X110-3N x 2
