elhep/CMOS_Camera/(list of files, cad)

Other CAD files:
Spektrop2_Sensor_Board_CMV4000_V1/PCB-Layout/Spektrop2_Sensor_Board_CMV4000_V1.step
