elhep/CMOS_Camera/Vivado/Spektrop2_CMV4000_V3/Spektrop2_CMV4000_V2.sim/sim_1/behav/xsim/xsim.dir/datapath_tb_behav/webtalk/usage_statistics_ext_xsim.html

### XSIM Usage Report

software_version_and_target_device
beta | FALSE | build_version | 2086221
date_generated | Sun Mar 11 20:16:17 2018 | os_platform | WIN64
product_version | XSIM v2017.4 (64-bit) | project_id | ba49ceaa5f864bb3962316ebdce2af8a
project_iteration | 56 | random_id | 12bcfd75-e07b-4676-abf6-736c9fd330ab
registration_id | 12bcfd75-e07b-4676-abf6-736c9fd330ab | route_design | FALSE
target_device | not_applicable | target_family | not_applicable
target_package | not_applicable | target_speed | not_applicable
tool_flow | xsim_vivado

user_environment
cpu_name | Intel(R) Core(TM) i5-5300U CPU @ 2.30GHz | cpu_speed | 2295 MHz
os_name | Microsoft Windows 8 or later , 64-bit | os_release | major release (build 9200)
system_ram | 8.000 GB | total_processors | 1

vivado_usage

xsim

command_line_options
command=xelab | debug=typical | dpi_used=false | file_counter=26
gendll=false | hwcosim=false | sdfmodeling=false | systemverilog=true

vhdl2008=false

usage
compiler_memory=115672_KB | compiler_time=2.78_sec | simulation_image_code=280 KB | simulation_image_data=55 KB
total_instances=118 | total_nets=0 | total_processes=967 | xilinx_hdl_libraries_used=secureip unimacro_ver unisims_ver
