elhep/CMOS_Camera/HL_SIM/results/pi/p1v0.pdf

## DC DROP CURRENT DENSITY

Thursday, January 11, 2018 18:01:10
Design file:
"C:\Users\ZdunekPC\Documents\Spektrop2\HL_SIM\Spektrop2_Processor_Board_V1\Spektrop2_Processor_Board_V1_3.pjh" Designer: Piotr Zdunek
HyperLynx BoardSim v9.4.2

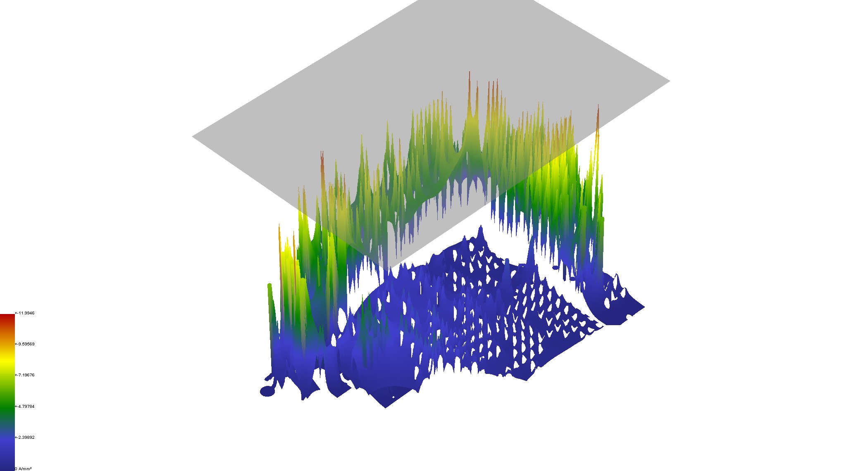
[picture p44: figure]

Max Current Density: 12.0 A/mm², Current Density for layer "TOP": 9.0 A/mm²
