elhep/CMOS_Camera/HL_SIM/results/pi/p1v0_dc_drop.pdf

## DC DROP VOLTAGE

Thursday, January 11, 2018 18:01:28
Design file:
"C:\Users\ZdunekPC\Documents\Spektrop2\HL_SIM\Spektrop2_Processor_Board_V1\Spektrop2_Processor_Board_V1_3.pjh" Designer: Piotr Zdunek
HyperLynx BoardSim v9.4.2

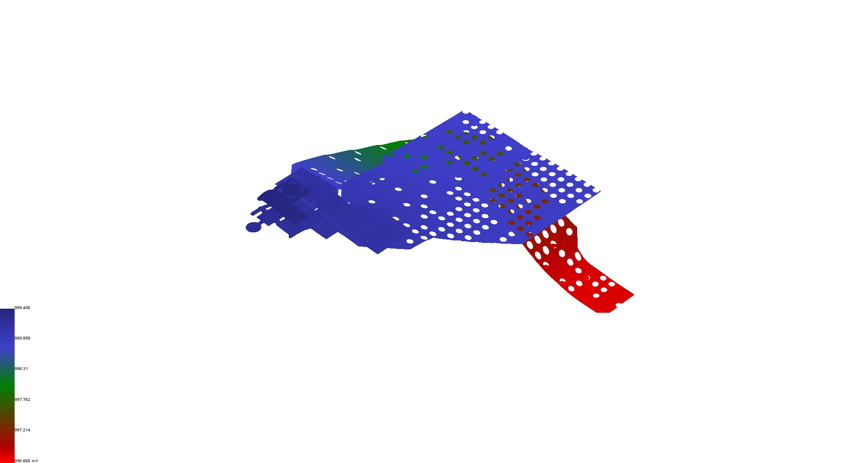
[picture p45: figure]

Max Voltage Drop: 3.3 mV, Voltage Drop for layer "TOP": 2.6 mV
