elhep/CMOS_Camera/HL_SIM/results/pi/p1v2.pdf

## DC DROP CURRENT DENSITY

Thursday, December 28, 2017 03:06:54
Design file:
"C:\Users\ZdunekPC\Documents\Spektrop2\Spektrop2_Processor_Board_V1\PCB-Layout\Spektrop2_Processor_Board_V1_test30.pjh" Designer: Piotr Zdunek
HyperLynx BoardSim v9.4.2
Comment: P1V2

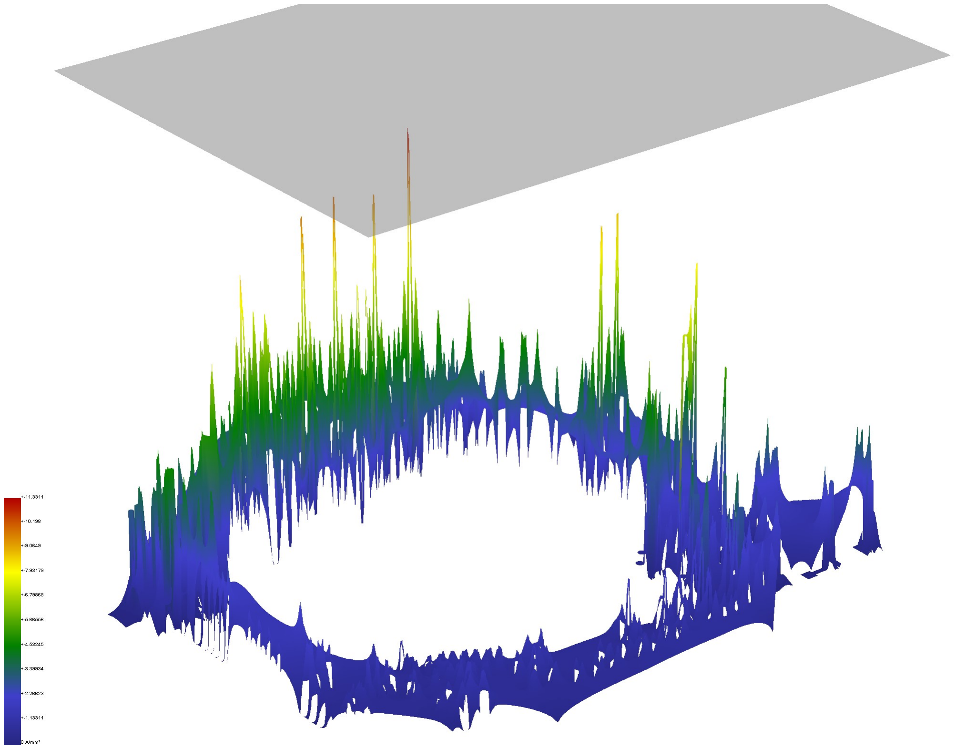
[picture p46: figure]

Max Current Density: 11.3 A/mm², Current Density for layer "TOP": 7.9 A/mm²
