elhep/CMOS_Camera/HL_SIM/results/pi/p1v2_current_density.pdf

## DC DROP CURRENT DENSITY

Thursday, January 11, 2018 22:24:50
Design file:
"C:\Users\ZdunekPC\Documents\Spektrop2\HL_SIM\Spektrop2_Processor_Board_V1\Spektrop2_Processor_Board_V1_8.pjh" Designer: Piotr Zdunek
HyperLynx BoardSim v9.4.2

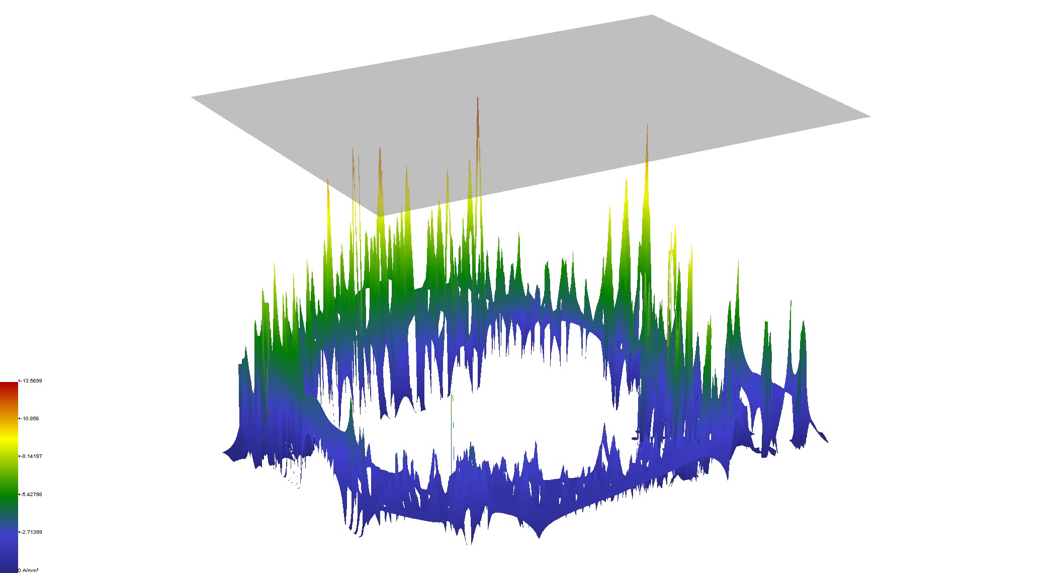
[picture p47: figure]

Max Current Density: 13.6 A/mm², Current Density for layer "TOP": 9.9 A/mm²
