elhep/CMOS_Camera/HL_SIM/results/pi/p1v2_dc_drop.pdf

## DC DROP VOLTAGE

Thursday, January 11, 2018 22:25:11
Design file:
"C:\Users\ZdunekPC\Documents\Spektrop2\HL_SIM\Spektrop2_Processor_Board_V1\Spektrop2_Processor_Board_V1_8.pjh" Designer: Piotr Zdunek
HyperLynx BoardSim v9.4.2

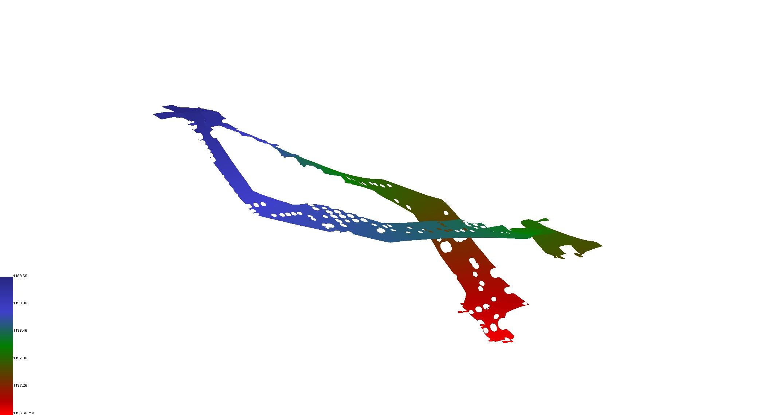
[picture p48: figure]

Max Voltage Drop: 3.3 mV, Voltage Drop for layer "TOP": 2.9 mV
