elhep/CMOS_Camera/HL_SIM/results/pi/p1v8_current_density.pdf

## DC DROP CURRENT DENSITY

Thursday, January 11, 2018 22:30:17
Design file:
"C:\Users\ZdunekPC\Documents\Spektrop2\HL_SIM\Spektrop2_Processor_Board_V1\Spektrop2_Processor_Board_V1_8.pjh" Designer: Piotr Zdunek
HyperLynx BoardSim v9.4.2

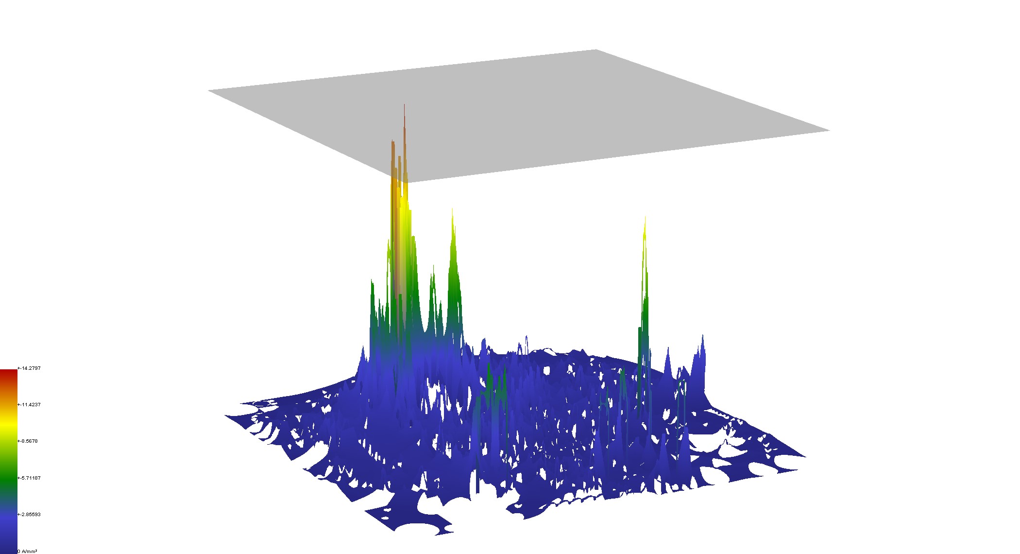
[picture p49: figure]

Max Current Density: 14.3 A/mm², Current Density for layer "TOP": 12.6 A/mm²
