elhep/CMOS_Camera/HL_SIM/results/pi/p1v8_dc_drop.pdf

## DC DROP VOLTAGE

Thursday, January 11, 2018 22:29:55
Design file:
"C:\Users\ZdunekPC\Documents\Spektrop2\HL_SIM\Spektrop2_Processor_Board_V1\Spektrop2_Processor_Board_V1_8.pjh" Designer: Piotr Zdunek
HyperLynx BoardSim v9.4.2

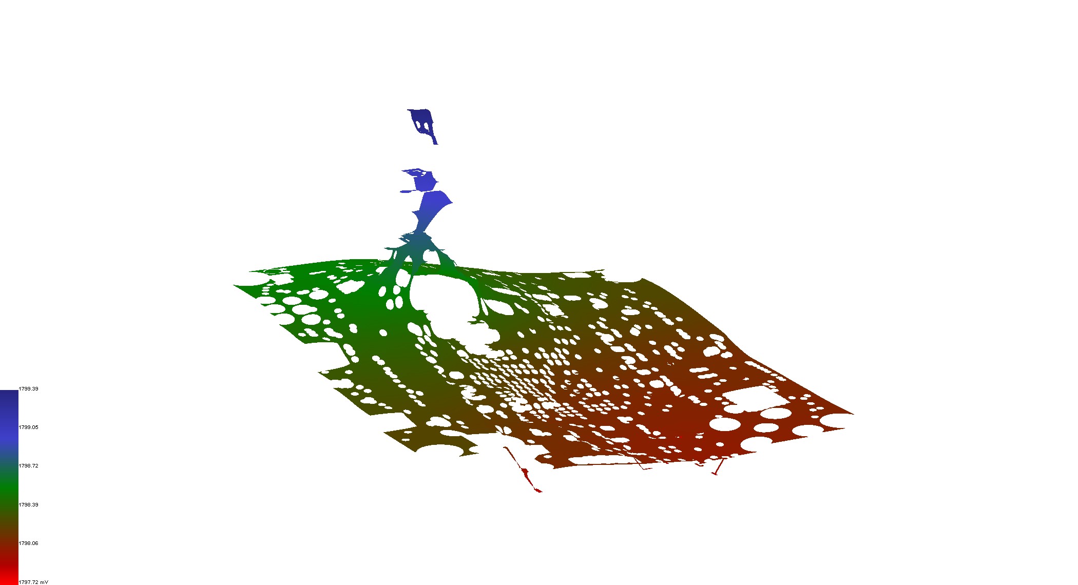
[picture p50: figure]

Max Voltage Drop: 2.3 mV, Voltage Drop for layer "TOP": 1.3 mV
