elhep/CMOS_Camera/HL_SIM/results/pi/p2v5_current_density.pdf

## DC DROP CURRENT DENSITY

Thursday, January 11, 2018 20:45:57
Design file:
"C:\Users\ZdunekPC\Documents\Spektrop2\HL_SIM\Spektrop2_Processor_Board_V1\Spektrop2_Processor_Board_V1_6.pjh" Designer: Piotr Zdunek
HyperLynx BoardSim v9.4.2

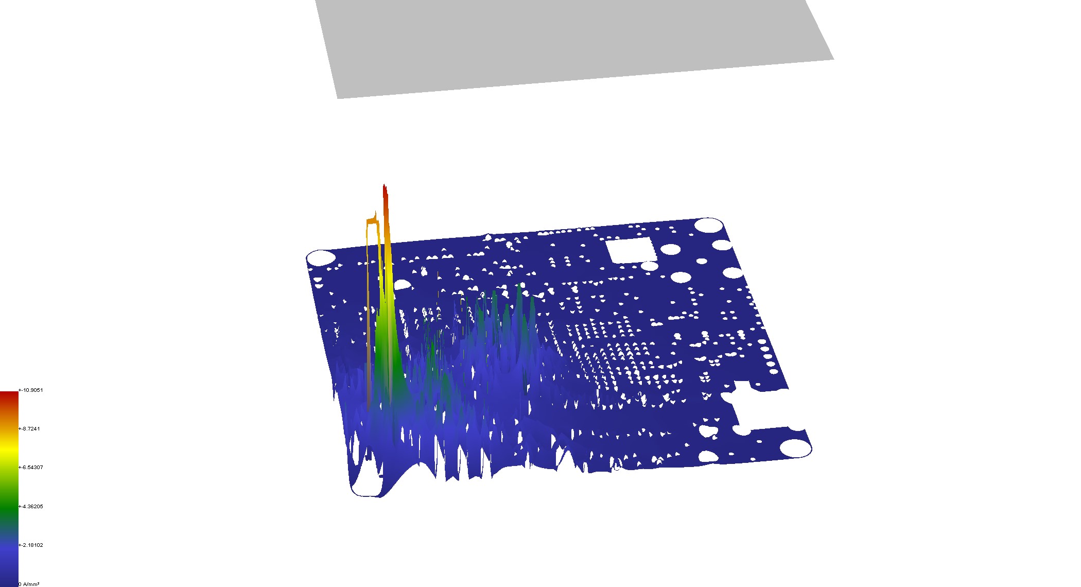
[picture p51: figure]

Max Current Density: 10.9 A/mm², Current Density for layer "TOP": 3.8 A/mm²
