elhep/CMOS_Camera/HL_SIM/results/pi/p2v5_dc_drop.pdf

## DC DROP VOLTAGE

Thursday, January 11, 2018 20:46:16
Design file:
"C:\Users\ZdunekPC\Documents\Spektrop2\HL_SIM\Spektrop2_Processor_Board_V1\Spektrop2_Processor_Board_V1_6.pjh" Designer: Piotr Zdunek
HyperLynx BoardSim v9.4.2

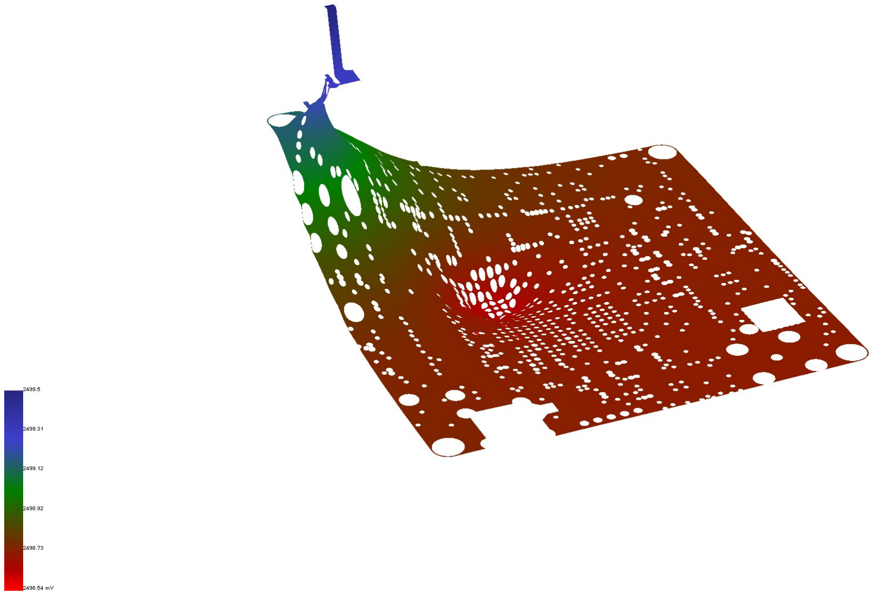
[picture p52: figure]

Max Voltage Drop: 1.5 mV, Voltage Drop for layer "TOP": 0.1 mV
