elhep/CMOS_Camera/HL_SIM/results/pi/p3v3_current_density.pdf

## DC DROP CURRENT DENSITY

Friday, January 12, 2018 00:35:00
Design file:
"C:\Users\ZdunekPC\Documents\Spektrop2\HL_SIM\Spektrop2_Processor_Board_V1\Spektrop2_Processor_Board_V1_14.pjh" Designer: Piotr Zdunek
HyperLynx BoardSim v9.4.2

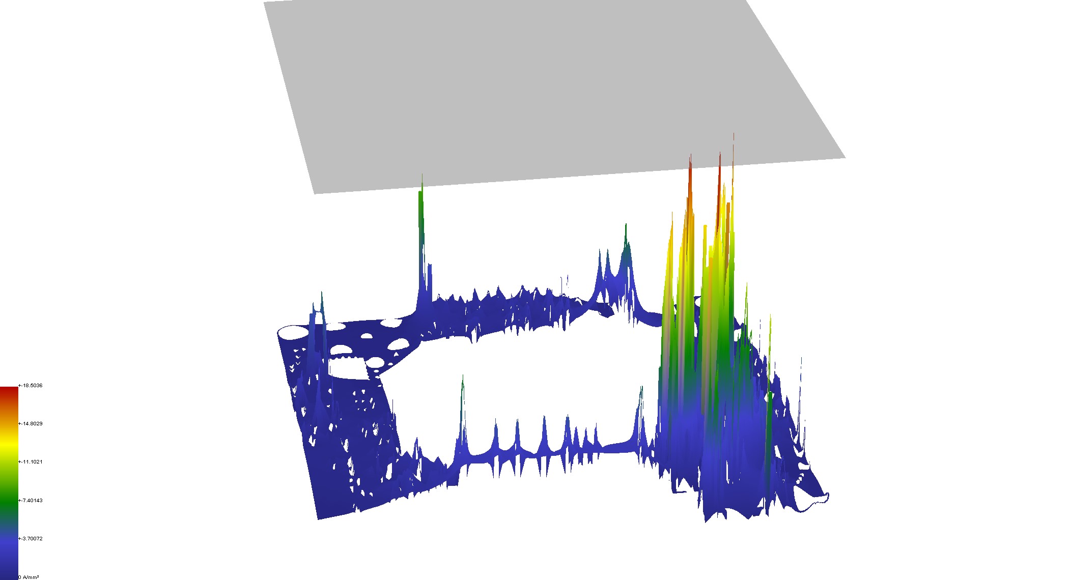
[picture p53: figure]

Max Current Density: 18.5 A/mm², Current Density for layer "TOP": 18.5 A/mm²
