elhep/CMOS_Camera/HL_SIM/results/pi/p3v3_dc_drop.pdf

## DC DROP VOLTAGE

Friday, January 12, 2018 00:35:15
Design file:
"C:\Users\ZdunekPC\Documents\Spektrop2\HL_SIM\Spektrop2_Processor_Board_V1\Spektrop2_Processor_Board_V1_14.pjh" Designer: Piotr Zdunek
HyperLynx BoardSim v9.4.2

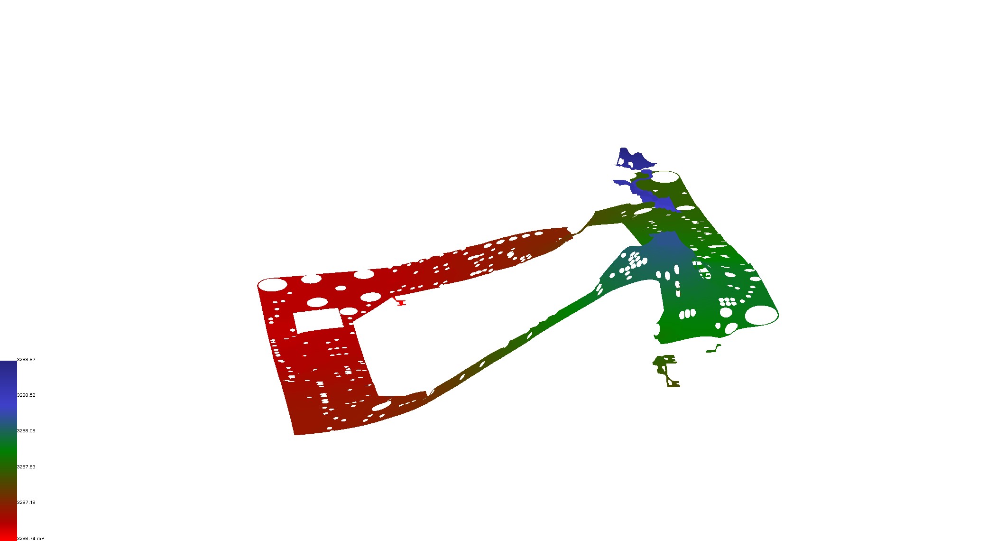
[picture p54: figure]

Max Voltage Drop: 3.3 mV, Voltage Drop for layer "TOP": 2.0 mV
