elhep/CMOS_Camera/HL_SIM/results/si/diff_pairs_eye_diagrams/clk_mgt0.PNG

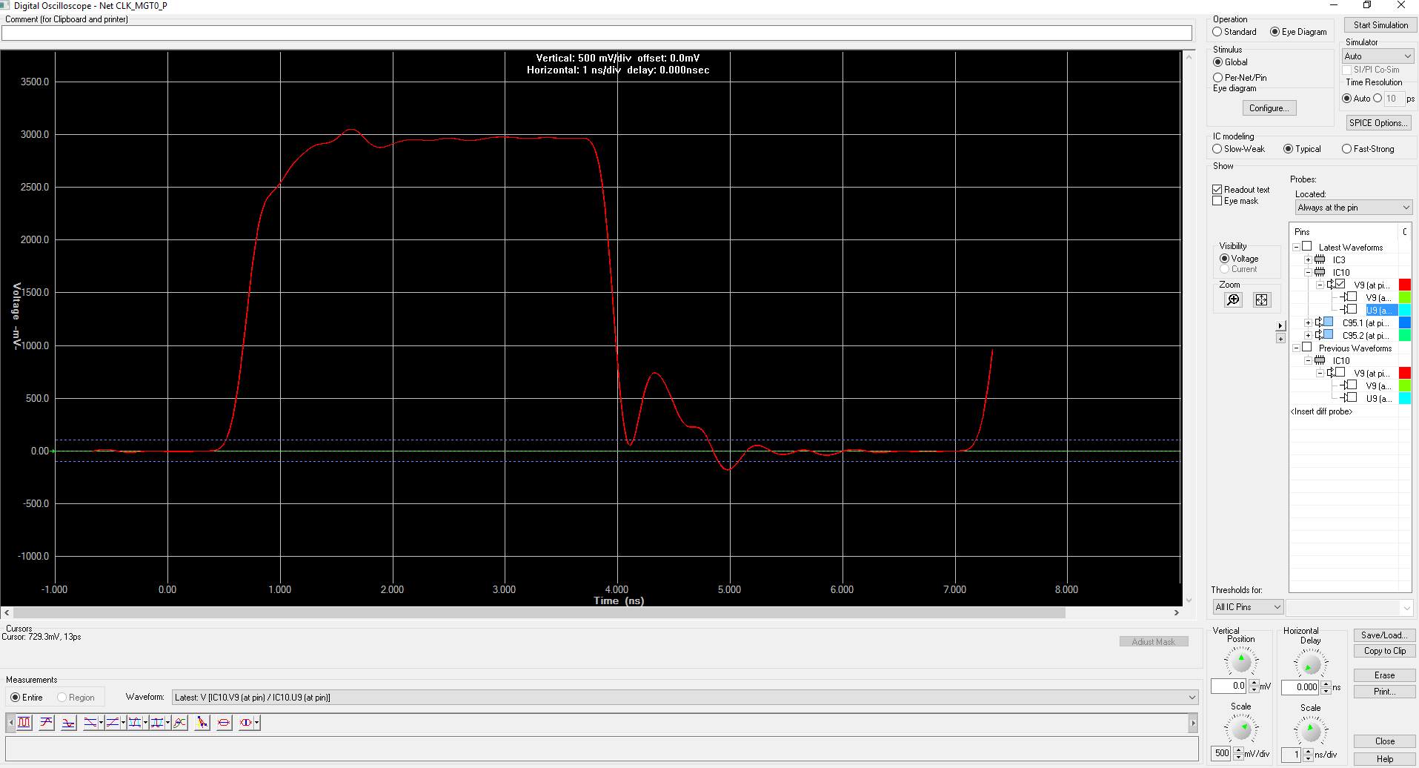
HL_SIM/results/si/diff_pairs_eye_diagrams/clk_mgt0.PNG
