elhep/CMOS_Camera/HL_SIM/results/si/diff_pairs_eye_diagrams/config.PNG

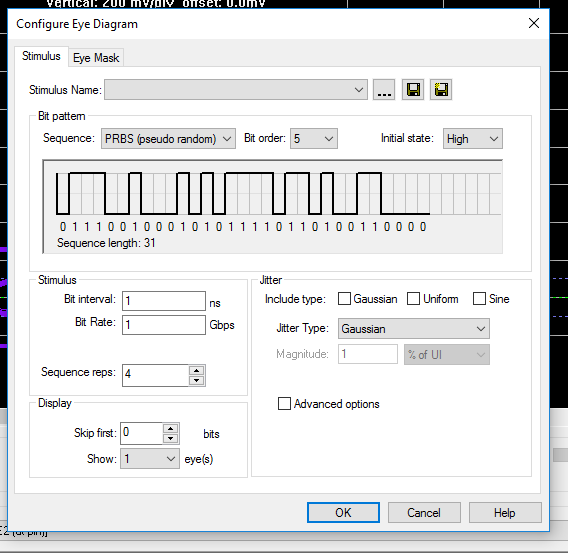
HL_SIM/results/si/diff_pairs_eye_diagrams/config.PNG
