elhep/CMOS_Camera/HL_SIM/results/si/diff_pairs_eye_diagrams/config_mgt_rx0.PNG

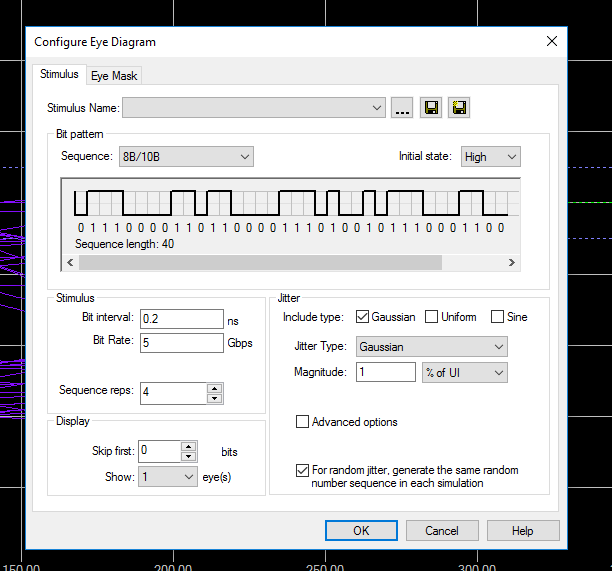
HL_SIM/results/si/diff_pairs_eye_diagrams/config_mgt_rx0.PNG
