elhep/CMOS_Camera/HL_SIM/results/si/diff_pairs_eye_diagrams/DIFF10_15_12_13_0_4_Gbps.PNG

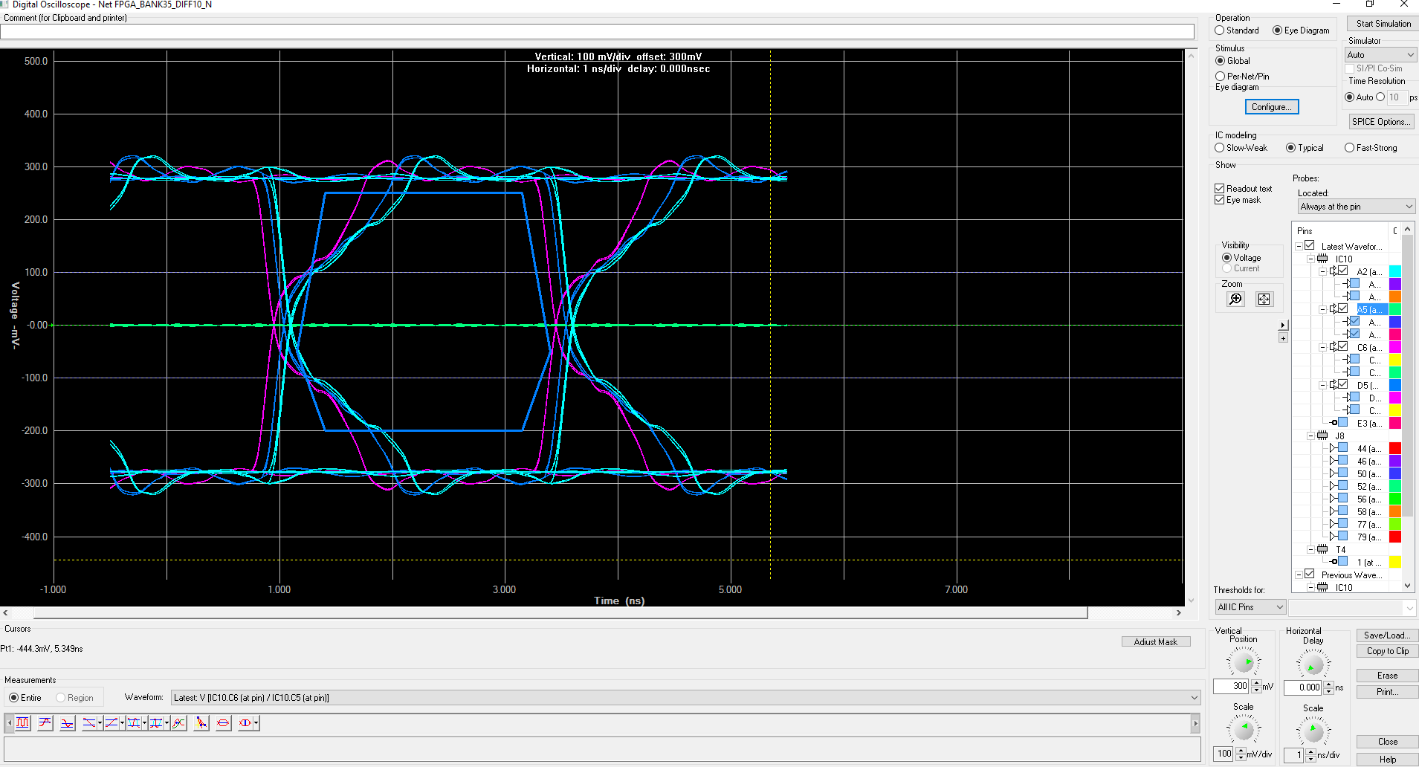
HL_SIM/results/si/diff_pairs_eye_diagrams/DIFF10_15_12_13_0_4_Gbps.PNG
