elhep/CMOS_Camera/HL_SIM/results/si/diff_pairs_eye_diagrams/eye_mask_mgt_tx2.PNG

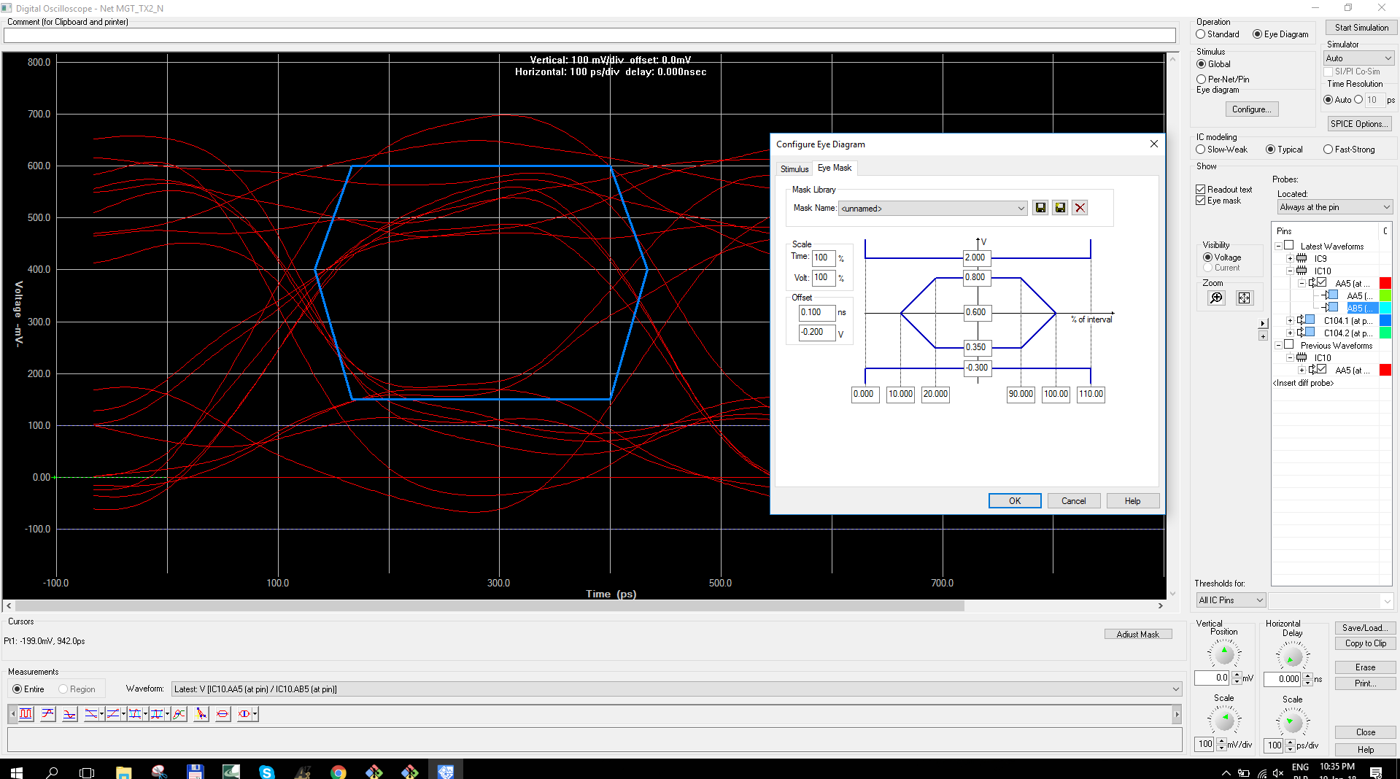
HL_SIM/results/si/diff_pairs_eye_diagrams/eye_mask_mgt_tx2.PNG
