elhep/CMOS_Camera/HL_SIM/results/si/diff_pairs_eye_diagrams/FPGA_DIFF5.PNG

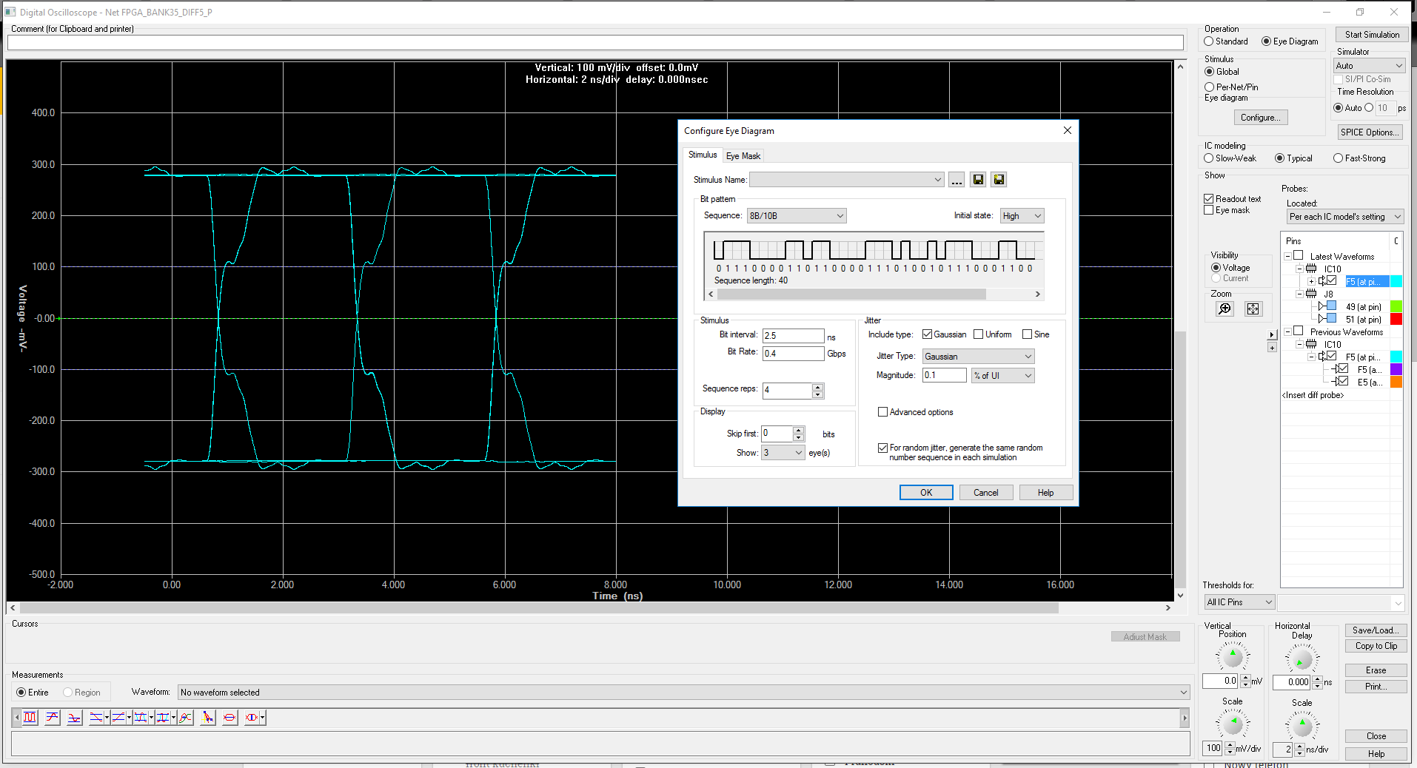
HL_SIM/results/si/diff_pairs_eye_diagrams/FPGA_DIFF5.PNG
