elhep/CMOS_Camera/HL_SIM/results/si/diff_pairs_eye_diagrams/MGT_TX0_5Gbps.PNG

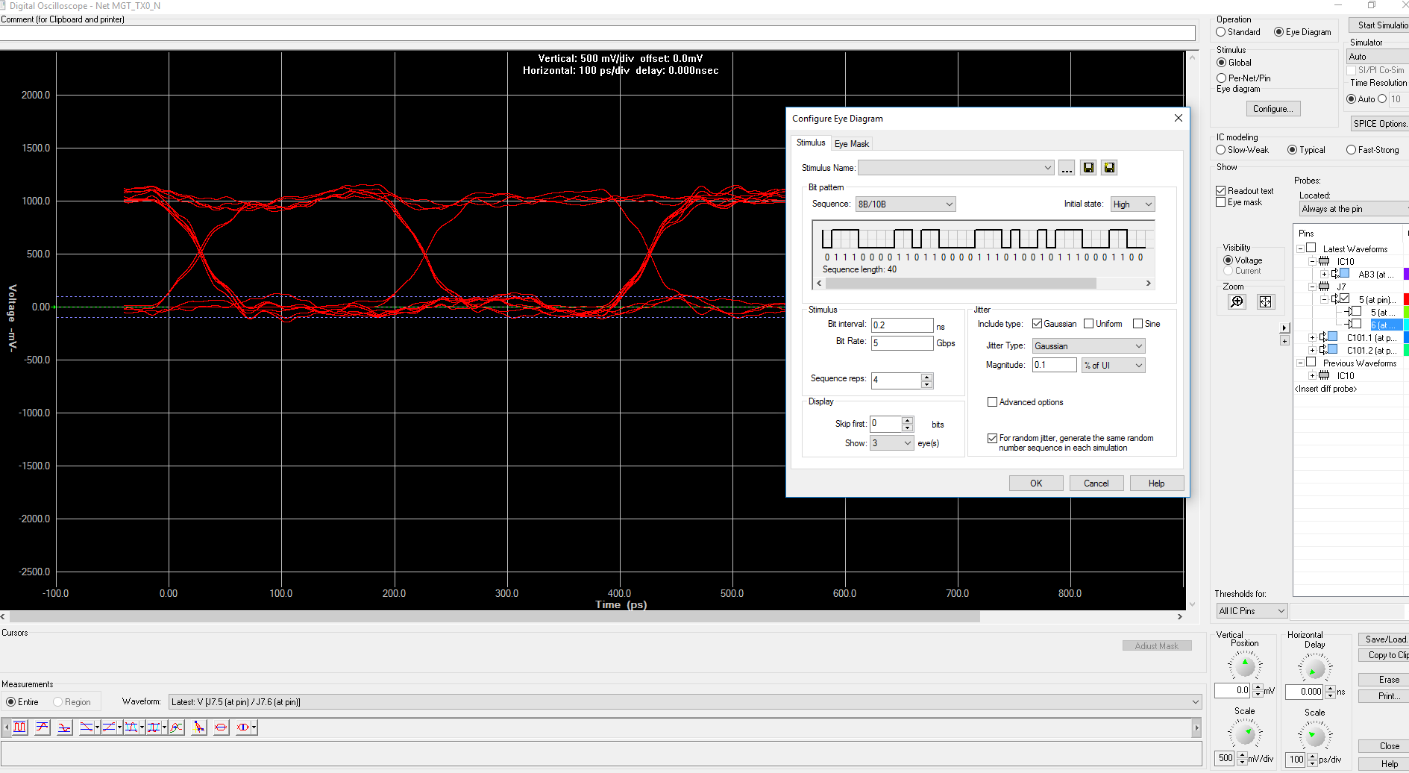
HL_SIM/results/si/diff_pairs_eye_diagrams/MGT_TX0_5Gbps.PNG
