elhep/CMOS_Camera/HL_SIM/results/si/diff_pairs_eye_diagrams/sim6_25gbps_mgt_tx2.PNG

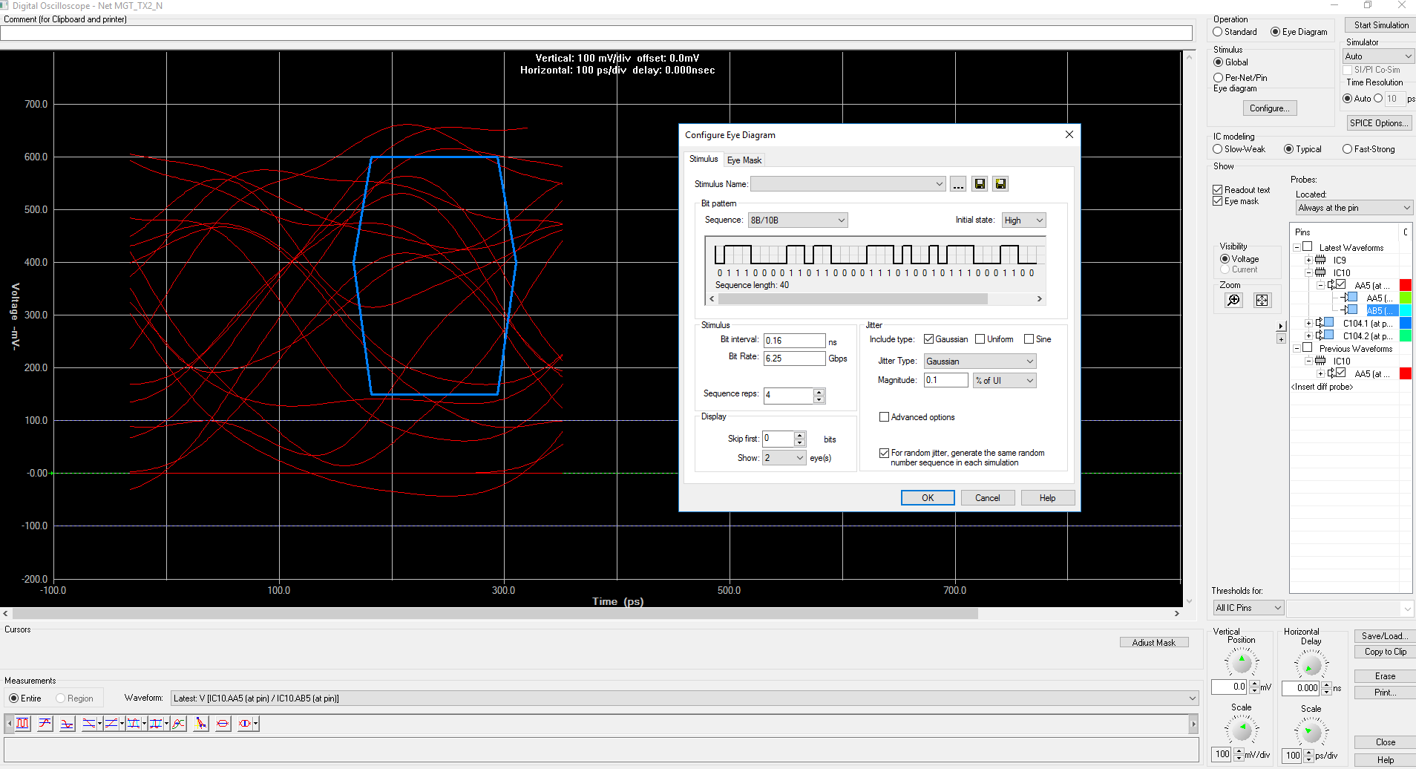
HL_SIM/results/si/diff_pairs_eye_diagrams/sim6_25gbps_mgt_tx2.PNG
