elhep/CMOS_Camera/HL_SIM/results/si/impedance_1.PNG

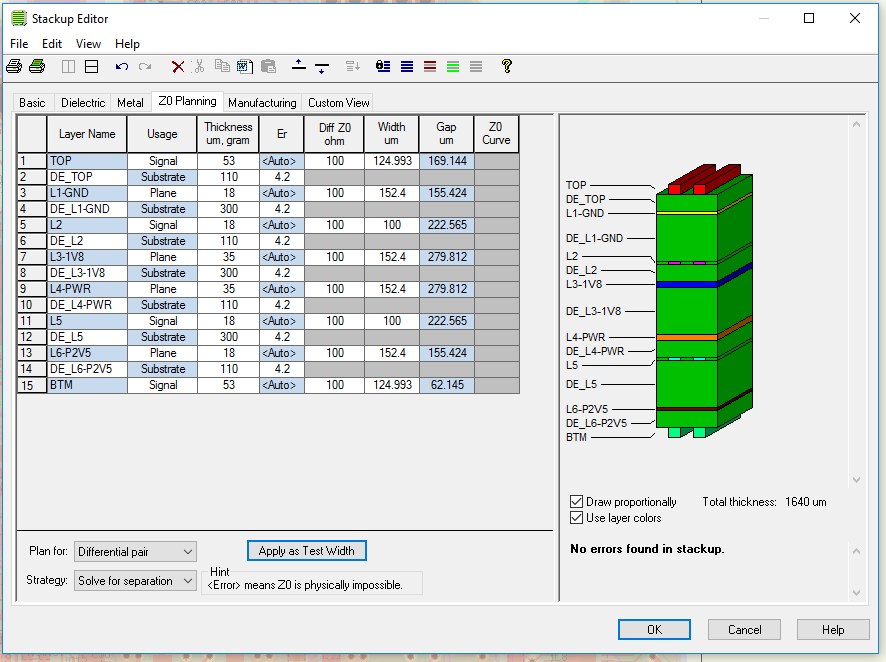
HL_SIM/results/si/impedance_1.PNG
