elhep/CMOS_Camera/HL_SIM/results/si/impedance_2.PNG

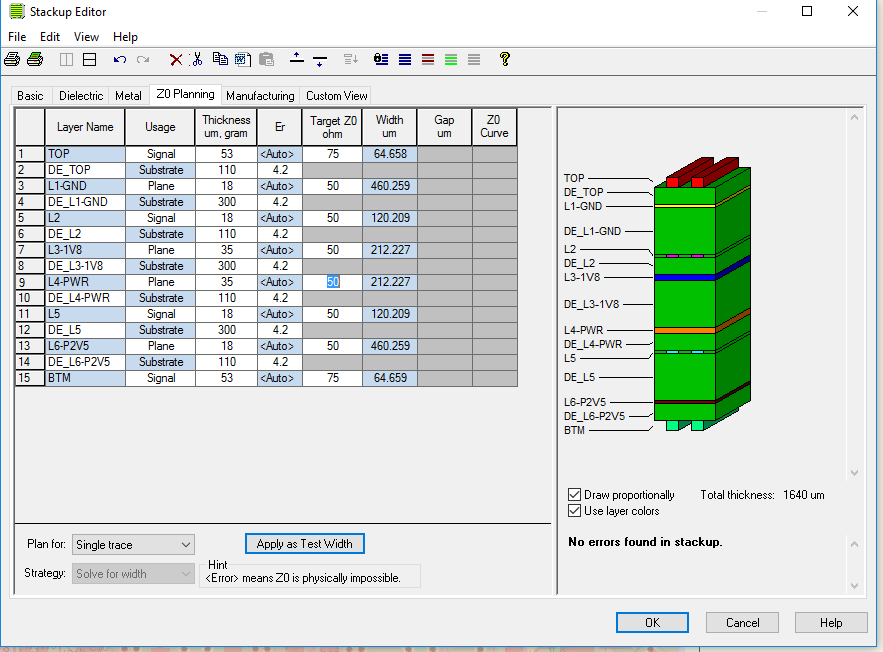
HL_SIM/results/si/impedance_2.PNG
