elhep/CMOS_Camera/HL_SIM/results/si/standard_time_domain_analysis/SPI_SCLK.PNG

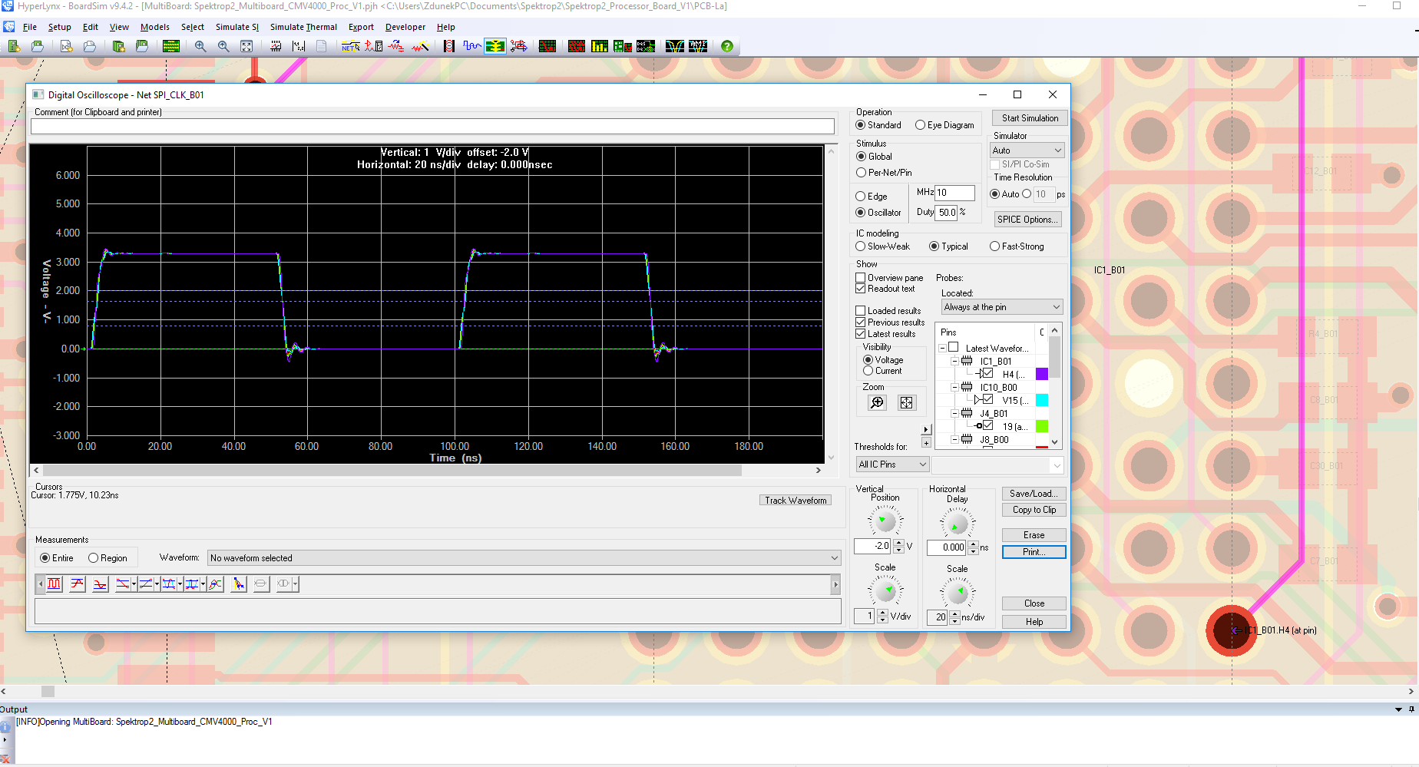
HL_SIM/results/si/standard_time_domain_analysis/SPI_SCLK.PNG
