elhep/CMOS_Camera/HL_SIM/results/thermal/proc_brd.PNG

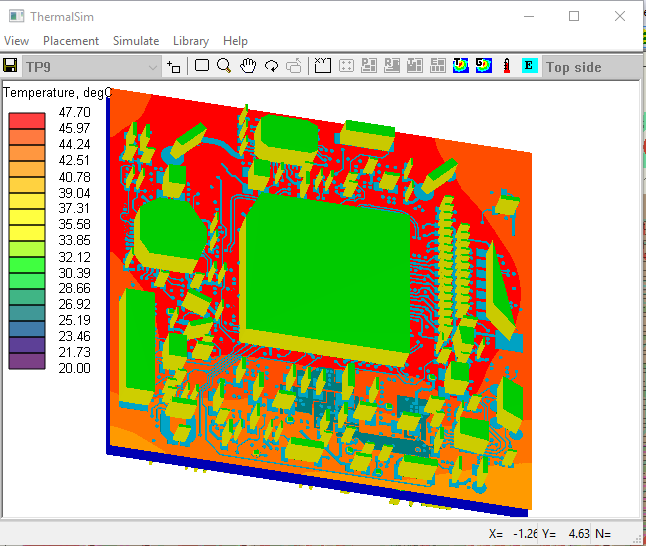
HL_SIM/results/thermal/proc_brd.PNG
