elhep/CMOS_Camera/HL_SIM/results/si/diff_pairs_eye_diagrams/FPGA_DIFF11_OUT13.pdf

## OSCILLOSCOPE

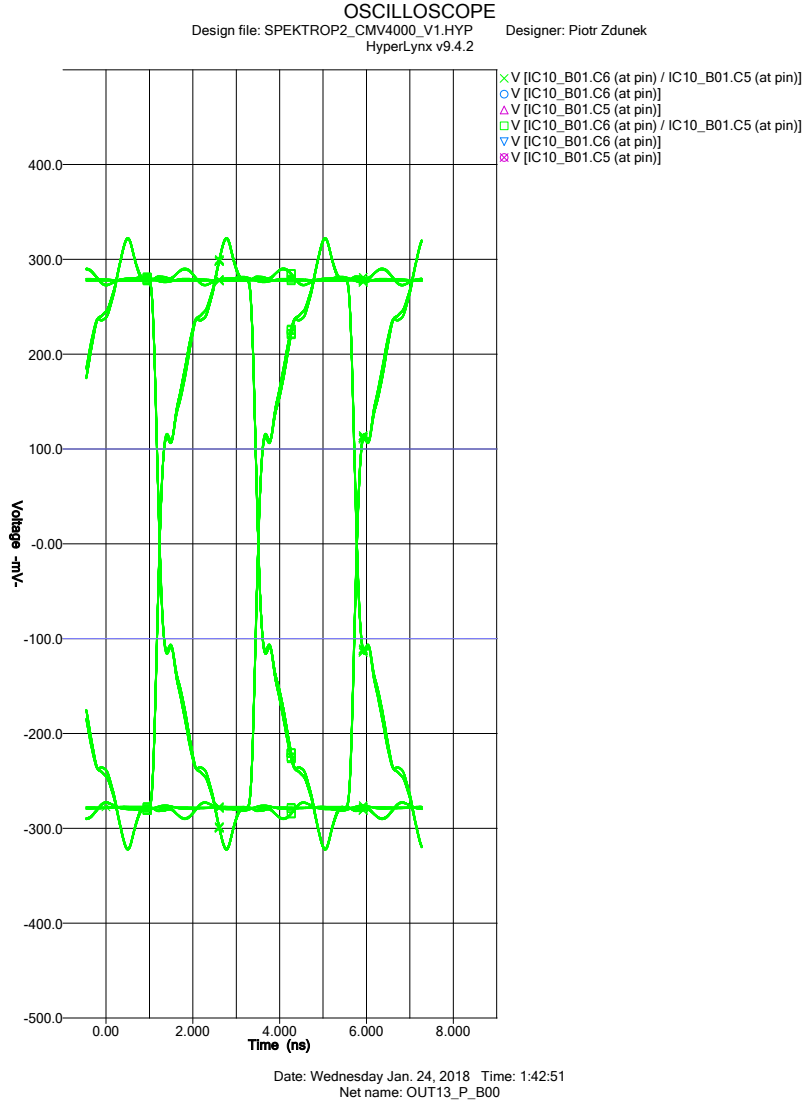
[picture p73: page 1]
Design file: SPEKTROP2_CMV4000_V1.HYP; Designer: Piotr Zdunek; HyperLynx v9.4.2; Net name: OUT13_P_B00

V [IC10_B01.C6 (at pin) / IC10_B01.C5 (at pin)]
V [IC10_B01.C6 (at pin)]
V [IC10_B01.C5 (at pin)]

Time (ns) Voltage -mV-

Date: Wednesday Jan. 24, 2018 Time: 1:42:51
