elhep/CMOS_Camera/HL_SIM/results/si/diff_pairs_eye_diagrams/FPGA_DIFF12_OUT6.pdf

## OSCILLOSCOPE

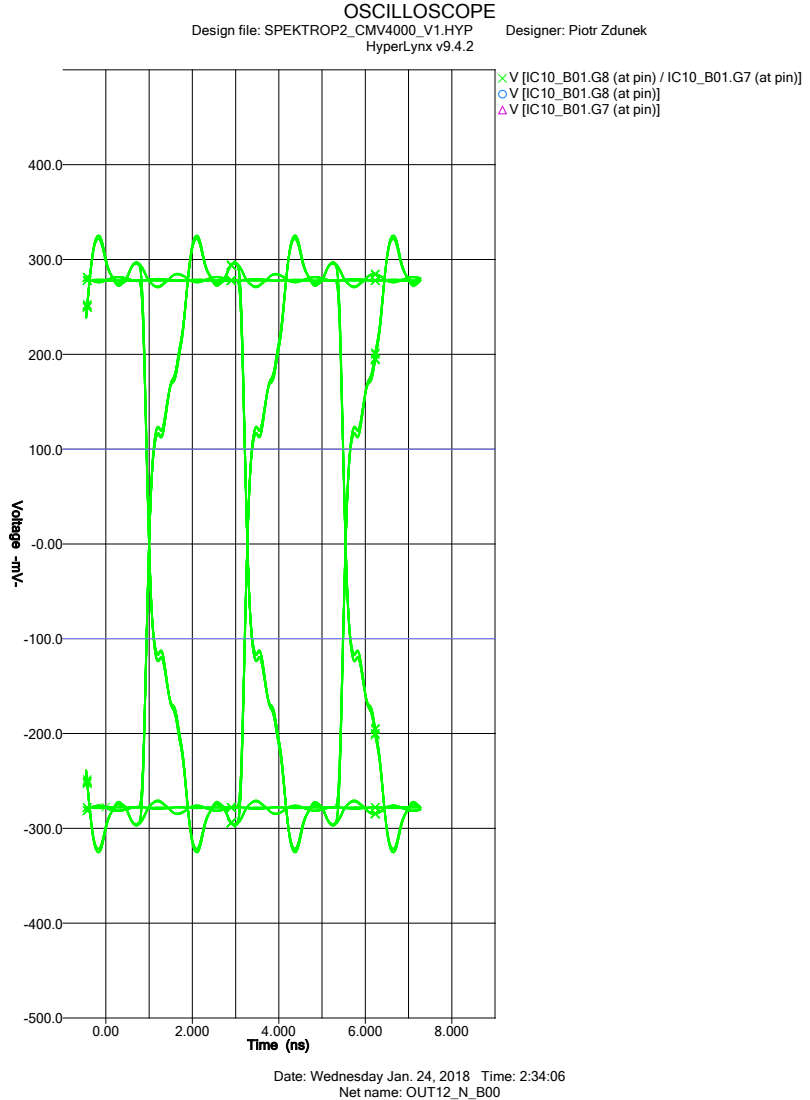
[picture p75: page 1]
Design file: SPEKTROP2_CMV4000_V1.HYP; Designer: Piotr Zdunek; HyperLynx v9.4.2; Net name: OUT12_N_B00

V [IC10_B01.G8 (at pin) / IC10_B01.G7 (at pin)]
V [IC10_B01.G8 (at pin)]
V [IC10_B01.G7 (at pin)]

Time (ns) Voltage -mV-

Date: Wednesday Jan. 24, 2018 Time: 2:34:06
