elhep/CMOS_Camera/HL_SIM/results/si/diff_pairs_eye_diagrams/FPGA_DIFF12_sensor_brd_0_44gbps.pdf

## OSCILLOSCOPE

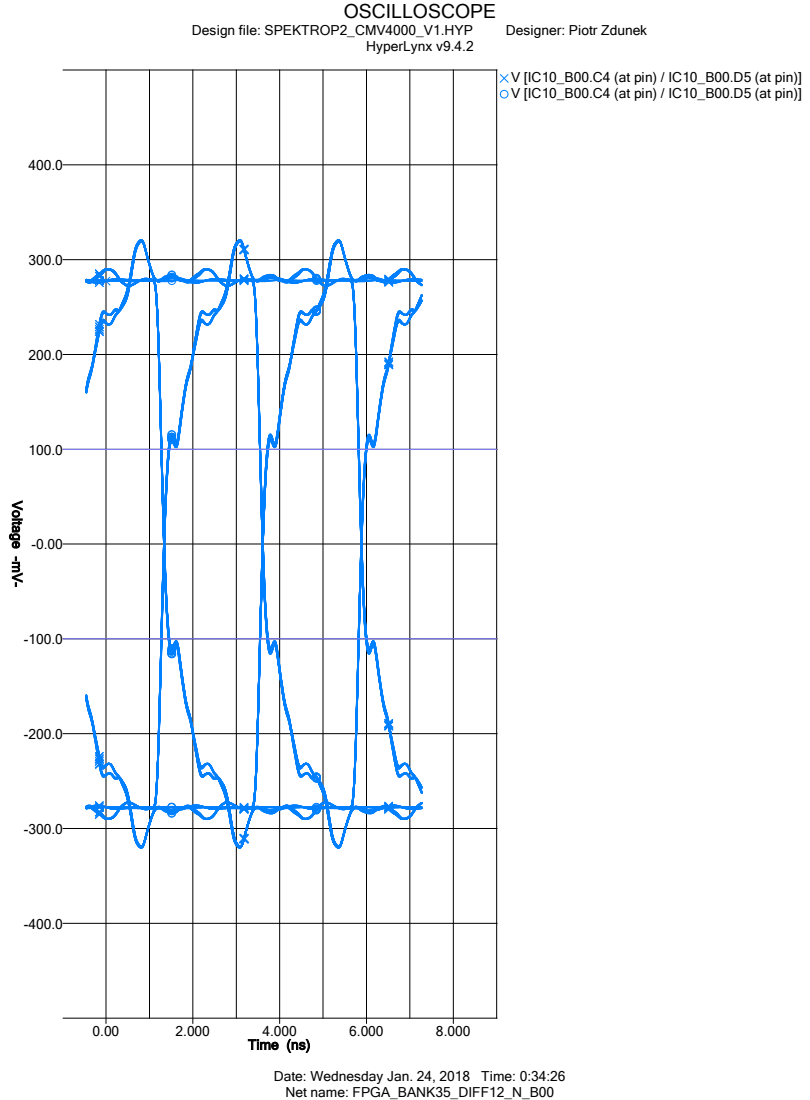
[picture p76: page 1]
Design file: SPEKTROP2_CMV4000_V1.HYP; Designer: Piotr Zdunek; HyperLynx v9.4.2

V [IC10_B00.C4 (at pin) / IC10_B00.D5 (at pin)]

Time (ns) Voltage -mV-

Date: Wednesday Jan. 24, 2018 Time: 0:34:26
Net name: FPGA_BANK35_DIFF12_N_B00
