elhep/CMOS_Camera/HL_SIM/results/si/diff_pairs_eye_diagrams/FPGA_DIFF13_LVDS_CLK_0_44gbps.pdf

## OSCILLOSCOPE

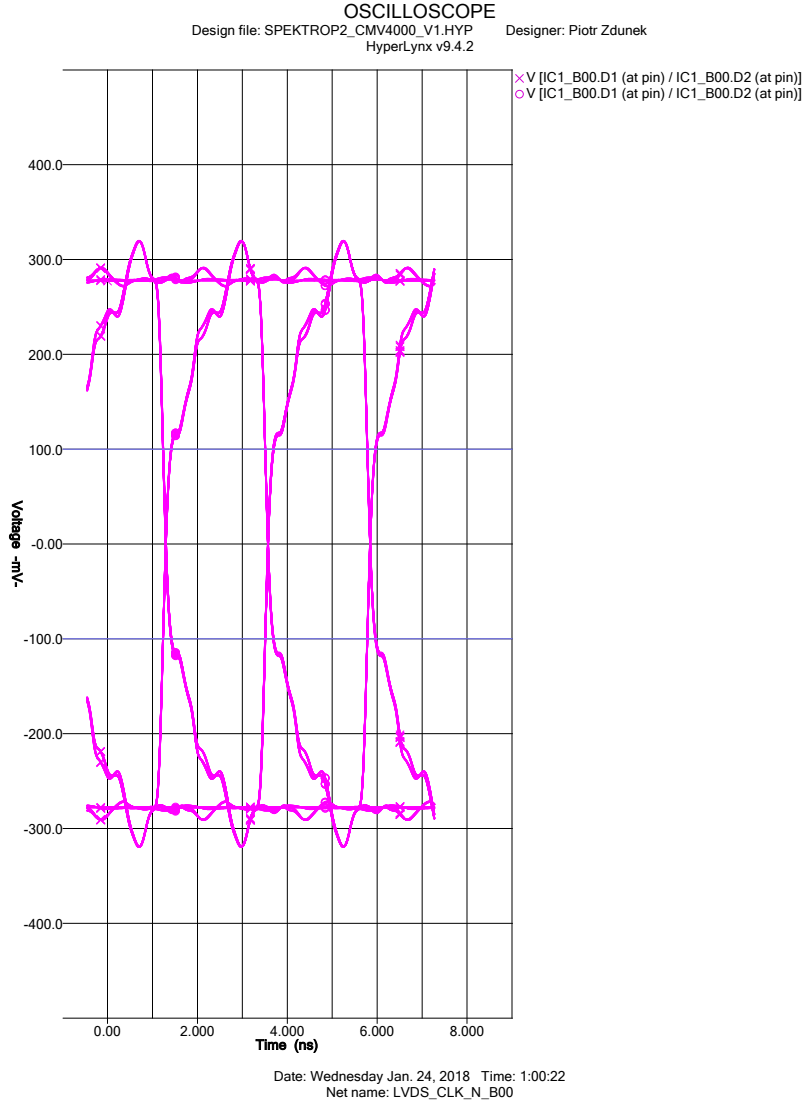
[picture p77: page 1]
Design file: SPEKTROP2_CMV4000_V1.HYP; Designer: Piotr Zdunek; HyperLynx v9.4.2; Net name: LVDS_CLK_N_B00

V [IC1_B00.D1 (at pin) / IC1_B00.D2 (at pin)]

Time (ns) Voltage -mV-

Date: Wednesday Jan. 24, 2018 Time: 1:00:22
