elhep/CMOS_Camera/HL_SIM/results/si/diff_pairs_eye_diagrams/FPGA_DIFF14_OUT1_0_44gbps.pdf

## OSCILLOSCOPE

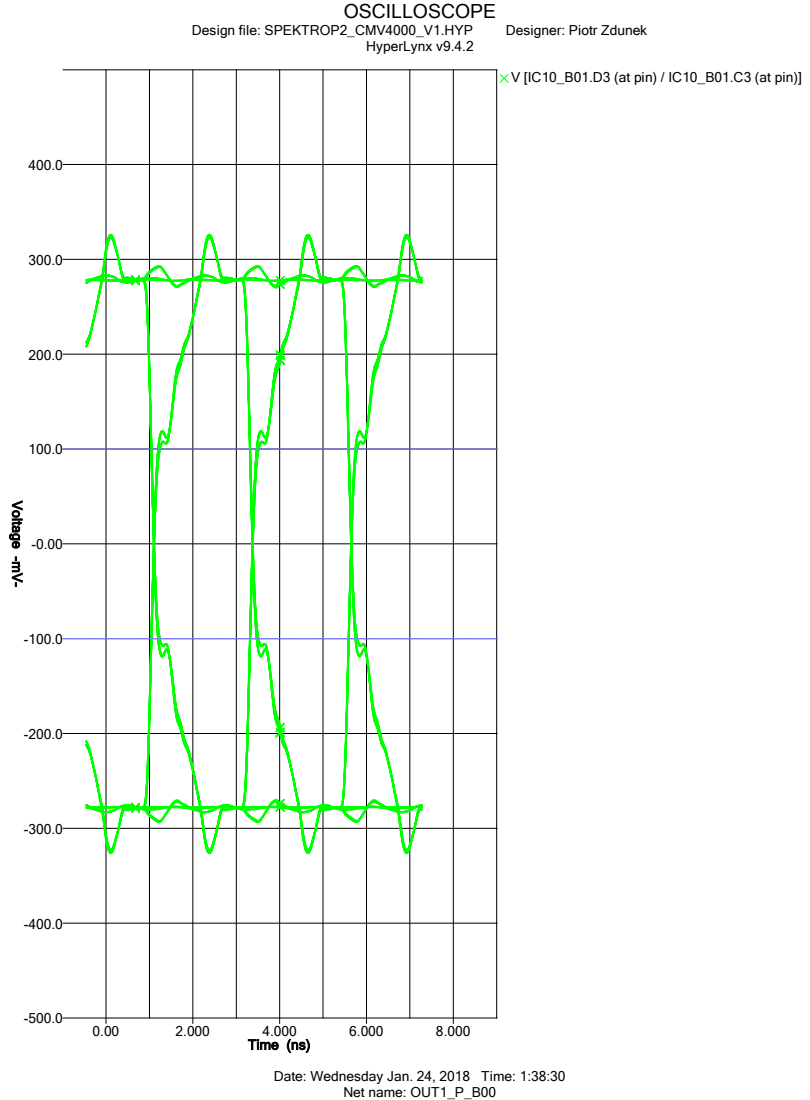
[picture p78: page 1]
Design file: SPEKTROP2_CMV4000_V1.HYP; Designer: Piotr Zdunek; HyperLynx v9.4.2; Net name: OUT1_P_B00

V [IC10_B01.D3 (at pin) / IC10_B01.C3 (at pin)]

Time (ns) Voltage -mV-

Date: Wednesday Jan. 24, 2018 Time: 1:38:30
