elhep/CMOS_Camera/HL_SIM/results/si/diff_pairs_eye_diagrams/FPGA_DIFF15_12_0_4Gbps.pdf

## OSCILLOSCOPE

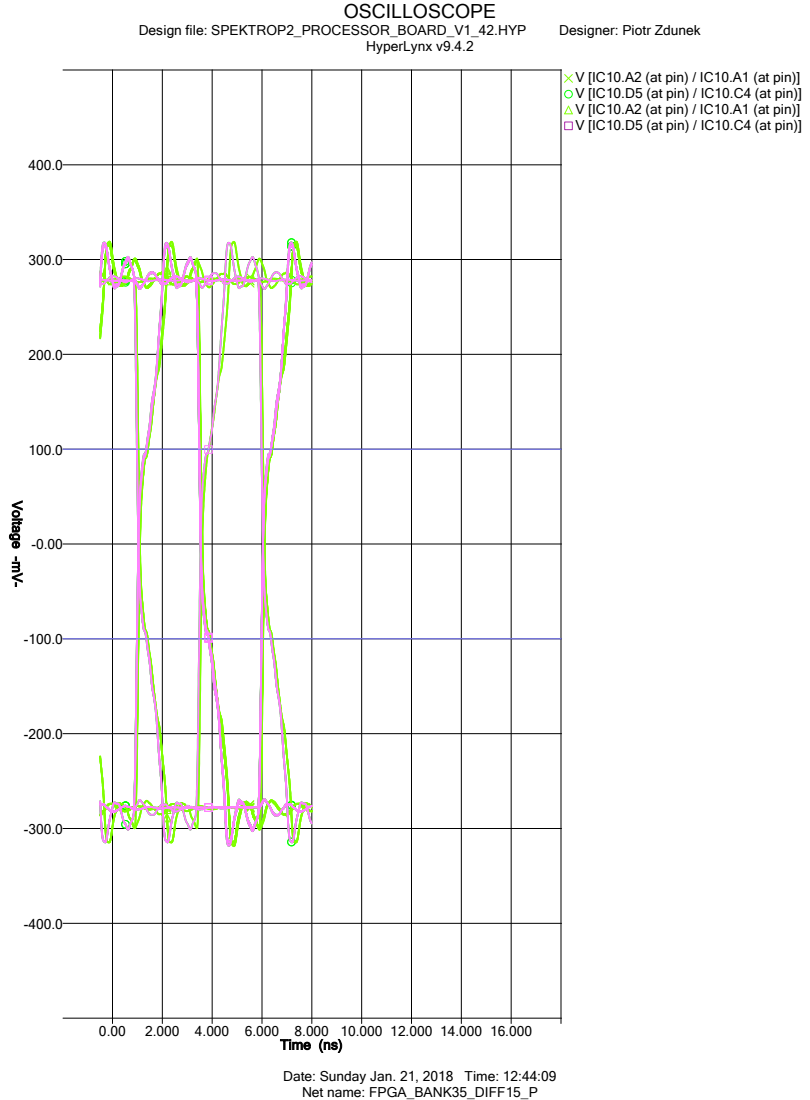
[picture p80: page 1]
Design file: SPEKTROP2_PROCESSOR_BOARD_V1_42.HYP; Designer: Piotr Zdunek; HyperLynx v9.4.2

V [IC10.A2 (at pin) / IC10.A1 (at pin)]
V [IC10.D5 (at pin) / IC10.C4 (at pin)]

Time (ns) Voltage -mV-

Date: Sunday Jan. 21, 2018 Time: 12:44:09
Net name: FPGA_BANK35_DIFF15_P
