elhep/CMOS_Camera/HL_SIM/results/si/diff_pairs_eye_diagrams/FPGA_DIFF15_OUT11_044gbps.pdf

## OSCILLOSCOPE

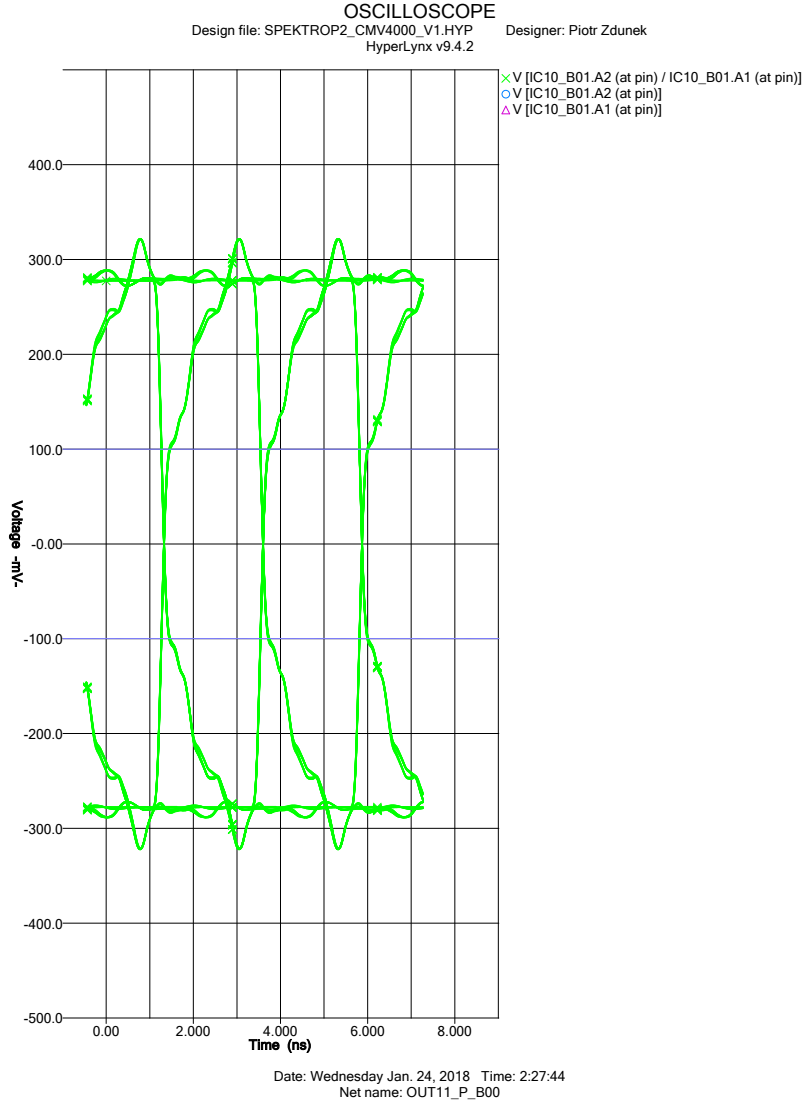
[picture p81: page 1]
Design file: SPEKTROP2_CMV4000_V1.HYP; Designer: Piotr Zdunek; HyperLynx v9.4.2; Net name: OUT11_P_B00

V [IC10_B01.A2 (at pin) / IC10_B01.A1 (at pin)]
V [IC10_B01.A2 (at pin)]
V [IC10_B01.A1 (at pin)]

Time (ns) Voltage -mV-

Date: Wednesday Jan. 24, 2018 Time: 2:27:44
