elhep/CMOS_Camera/HL_SIM/results/si/diff_pairs_eye_diagrams/FPGA_DIFF15_sensor_brd.pdf

## OSCILLOSCOPE

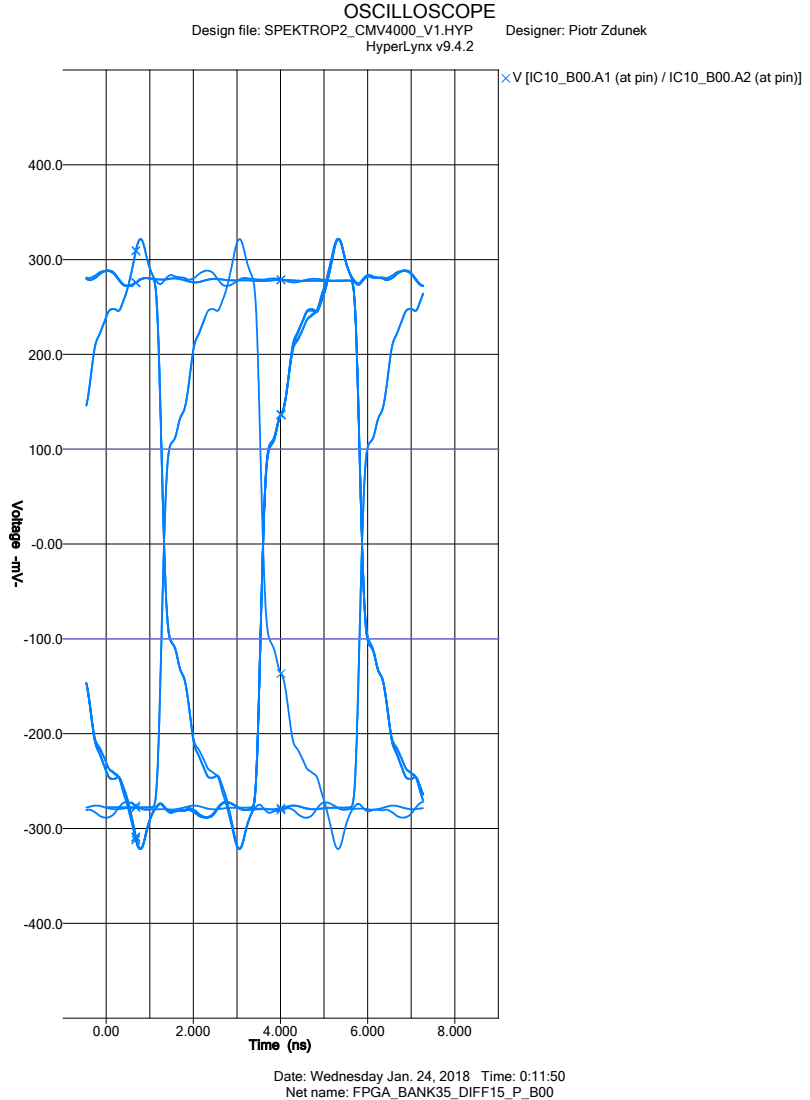
[picture p82: page 1]
Design file: SPEKTROP2_CMV4000_V1.HYP; Designer: Piotr Zdunek; HyperLynx v9.4.2

V [IC10_B00.A1 (at pin) / IC10_B00.A2 (at pin)]

Time (ns) Voltage -mV-

Date: Wednesday Jan. 24, 2018 Time: 0:11:50
Net name: FPGA_BANK35_DIFF15_P_B00
