elhep/CMOS_Camera/HL_SIM/results/si/diff_pairs_eye_diagrams/FPGA_DIFF17_OUT3_044gbps.pdf

## OSCILLOSCOPE

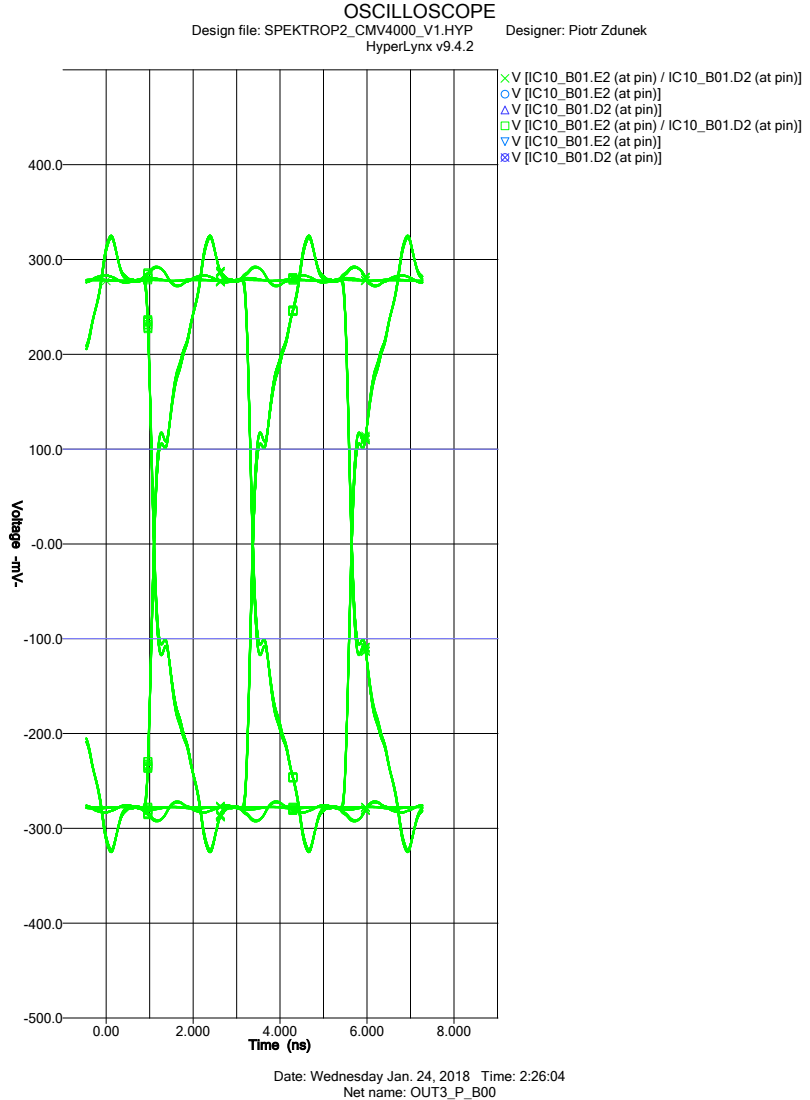
[picture p84: page 1]
Design file: SPEKTROP2_CMV4000_V1.HYP; Designer: Piotr Zdunek; HyperLynx v9.4.2; Net name: OUT3_P_B00

V [IC10_B01.E2 (at pin) / IC10_B01.D2 (at pin)]
V [IC10_B01.E2 (at pin)]
V [IC10_B01.D2 (at pin)]

Time (ns) Voltage -mV-

Date: Wednesday Jan. 24, 2018 Time: 2:26:04
