elhep/CMOS_Camera/HL_SIM/results/si/diff_pairs_eye_diagrams/FPGA_DIFF19_OUT14_0_44gbps.pdf

## OSCILLOSCOPE

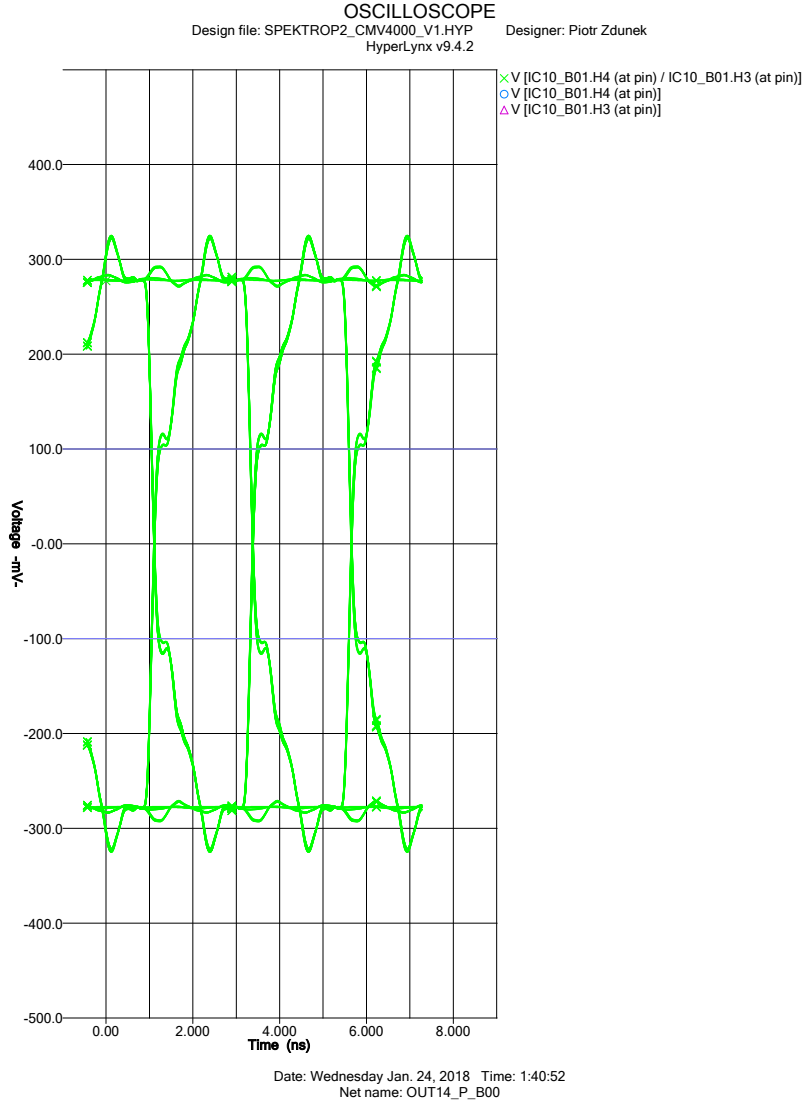
[picture p86: page 1]
Design file: SPEKTROP2_CMV4000_V1.HYP; Designer: Piotr Zdunek; HyperLynx v9.4.2; Net name: OUT14_P_B00

V [IC10_B01.H4 (at pin) / IC10_B01.H3 (at pin)]
V [IC10_B01.H4 (at pin)]
V [IC10_B01.H3 (at pin)]

Time (ns) Voltage -mV-

Date: Wednesday Jan. 24, 2018 Time: 1:40:52
