elhep/CMOS_Camera/HL_SIM/results/si/diff_pairs_eye_diagrams/FPGA_DIFF2_OUT7.pdf

## OSCILLOSCOPE

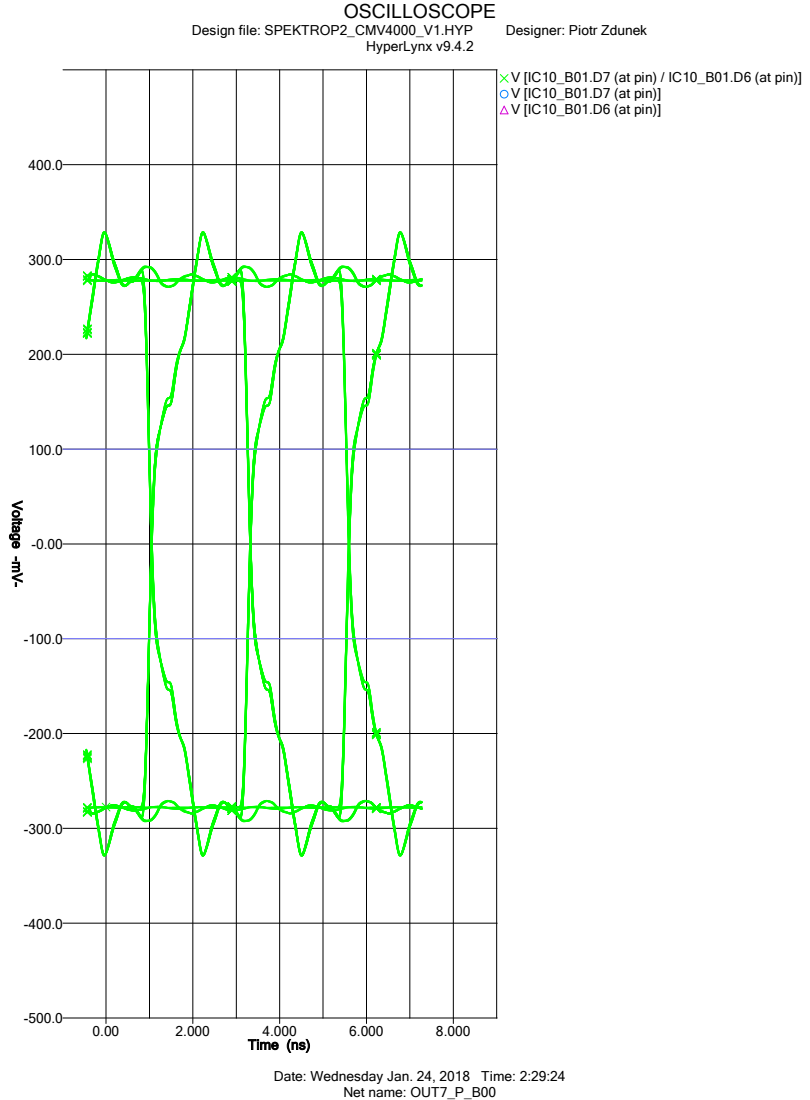
[picture p87: page 1]
Design file: SPEKTROP2_CMV4000_V1.HYP; Designer: Piotr Zdunek; HyperLynx v9.4.2; Net name: OUT7_P_B00

V [IC10_B01.D7 (at pin) / IC10_B01.D6 (at pin)]
V [IC10_B01.D7 (at pin)]
V [IC10_B01.D6 (at pin)]

Time (ns) Voltage -mV-

Date: Wednesday Jan. 24, 2018 Time: 2:29:24
