elhep/CMOS_Camera/HL_SIM/results/si/diff_pairs_eye_diagrams/FPGA_DIFF3_OUT2.pdf

## OSCILLOSCOPE

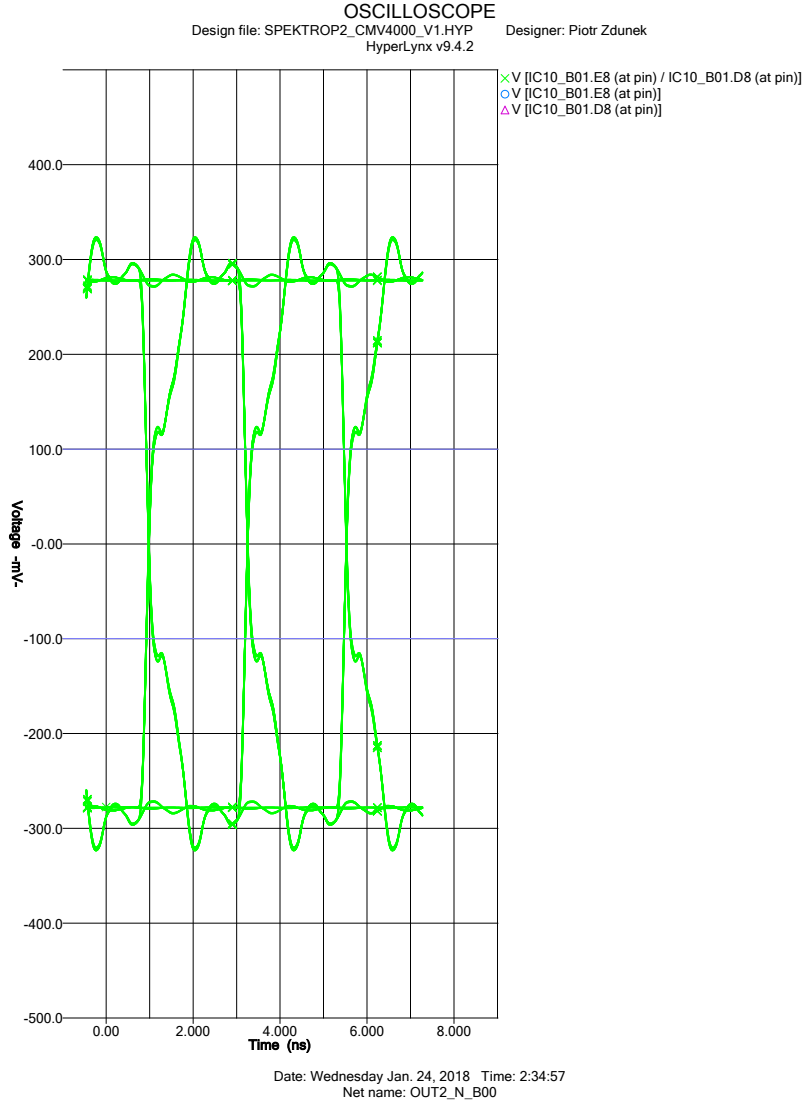
[picture p88: page 1]
Design file: SPEKTROP2_CMV4000_V1.HYP; Designer: Piotr Zdunek; HyperLynx v9.4.2; Net name: OUT2_N_B00

V [IC10_B01.E8 (at pin) / IC10_B01.D8 (at pin)]
V [IC10_B01.E8 (at pin)]
V [IC10_B01.D8 (at pin)]

Time (ns) Voltage -mV-

Date: Wednesday Jan. 24, 2018 Time: 2:34:57
