elhep/CMOS_Camera/HL_SIM/results/si/diff_pairs_eye_diagrams/FPGA_DIFF4_OUT15.pdf

## OSCILLOSCOPE

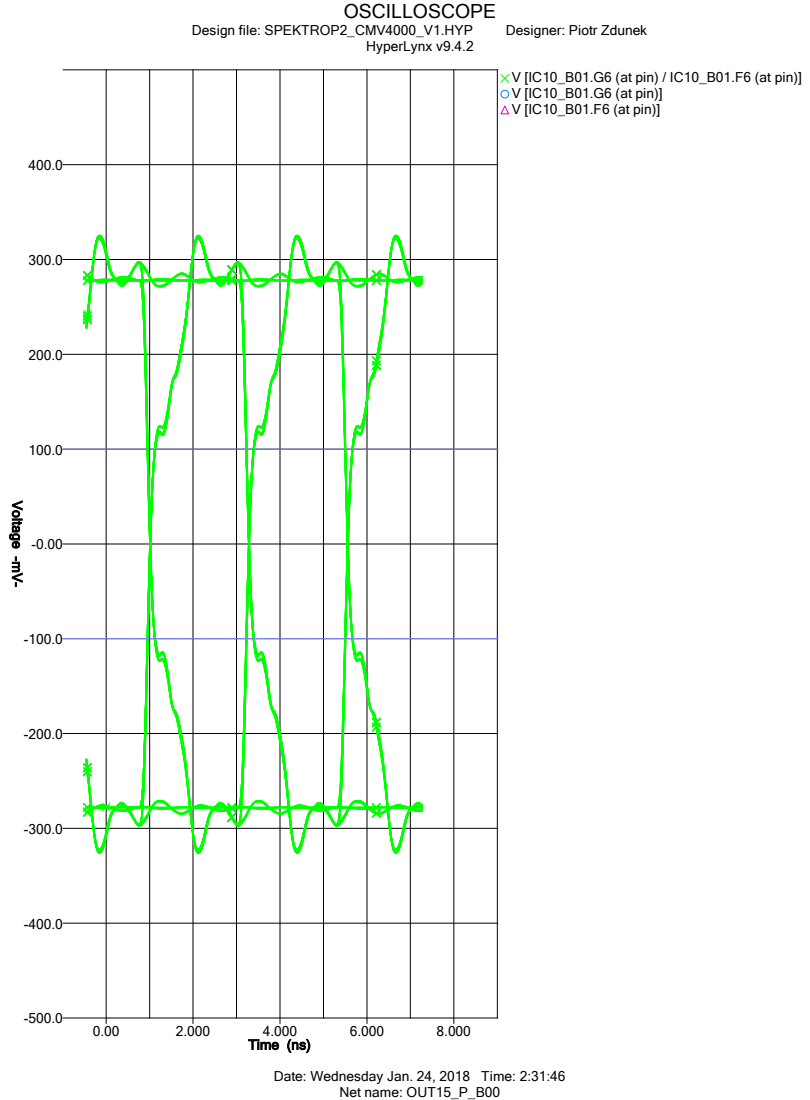
[picture p89: page 1]
Design file: SPEKTROP2_CMV4000_V1.HYP; Designer: Piotr Zdunek; HyperLynx v9.4.2; Net name: OUT15_P_B00

V [IC10_B01.G6 (at pin) / IC10_B01.F6 (at pin)]
V [IC10_B01.G6 (at pin)]
V [IC10_B01.F6 (at pin)]

Time (ns) Voltage -mV-

Date: Wednesday Jan. 24, 2018 Time: 2:31:46
