elhep/CMOS_Camera/HL_SIM/results/si/diff_pairs_eye_diagrams/FPGA_DIFF5.pdf

## OSCILLOSCOPE

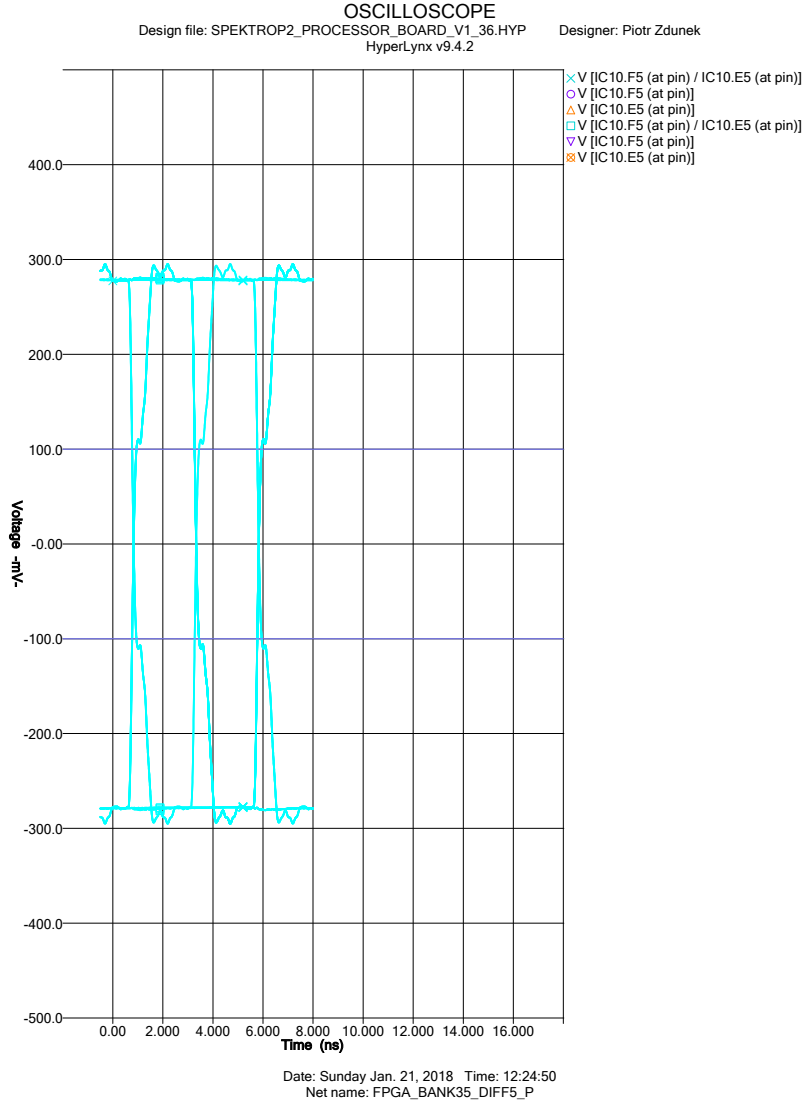
[picture p90: page 1]
Design file: SPEKTROP2_PROCESSOR_BOARD_V1_36.HYP; Designer: Piotr Zdunek; HyperLynx v9.4.2

V [IC10.F5 (at pin) / IC10.E5 (at pin)]
V [IC10.F5 (at pin)]
V [IC10.E5 (at pin)]

Time (ns) Voltage -mV-

Date: Sunday Jan. 21, 2018 Time: 12:24:50
Net name: FPGA_BANK35_DIFF5_P
