elhep/CMOS_Camera/HL_SIM/results/si/diff_pairs_eye_diagrams/FPGA_DIFF7_OUTCTR_044gbps.pdf

## OSCILLOSCOPE

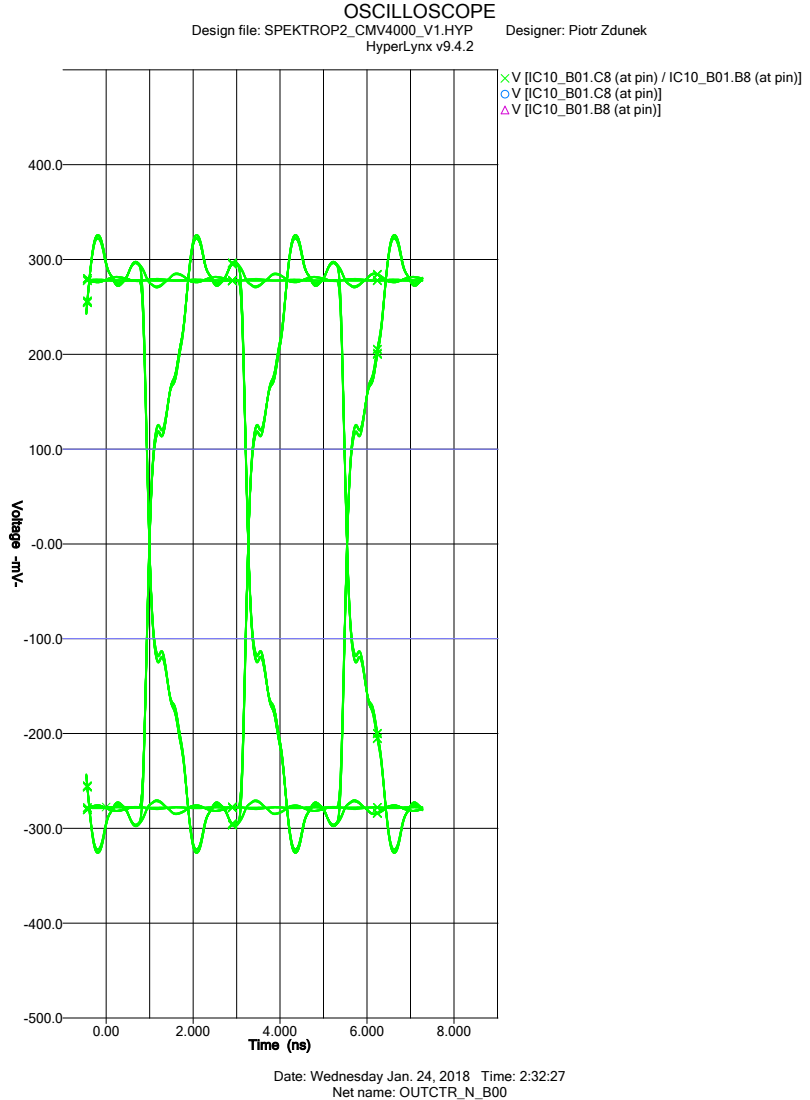
[picture p92: page 1]
Design file: SPEKTROP2_CMV4000_V1.HYP; Designer: Piotr Zdunek; HyperLynx v9.4.2; Net name: OUTCTR_N_B00

V [IC10_B01.C8 (at pin) / IC10_B01.B8 (at pin)]
V [IC10_B01.C8 (at pin)]
V [IC10_B01.B8 (at pin)]

Time (ns) Voltage -mV-

Date: Wednesday Jan. 24, 2018 Time: 2:32:27
