elhep/CMOS_Camera/HL_SIM/results/si/diff_pairs_eye_diagrams/FPGA_DIFF8_OUT10_044gbps.pdf

## OSCILLOSCOPE

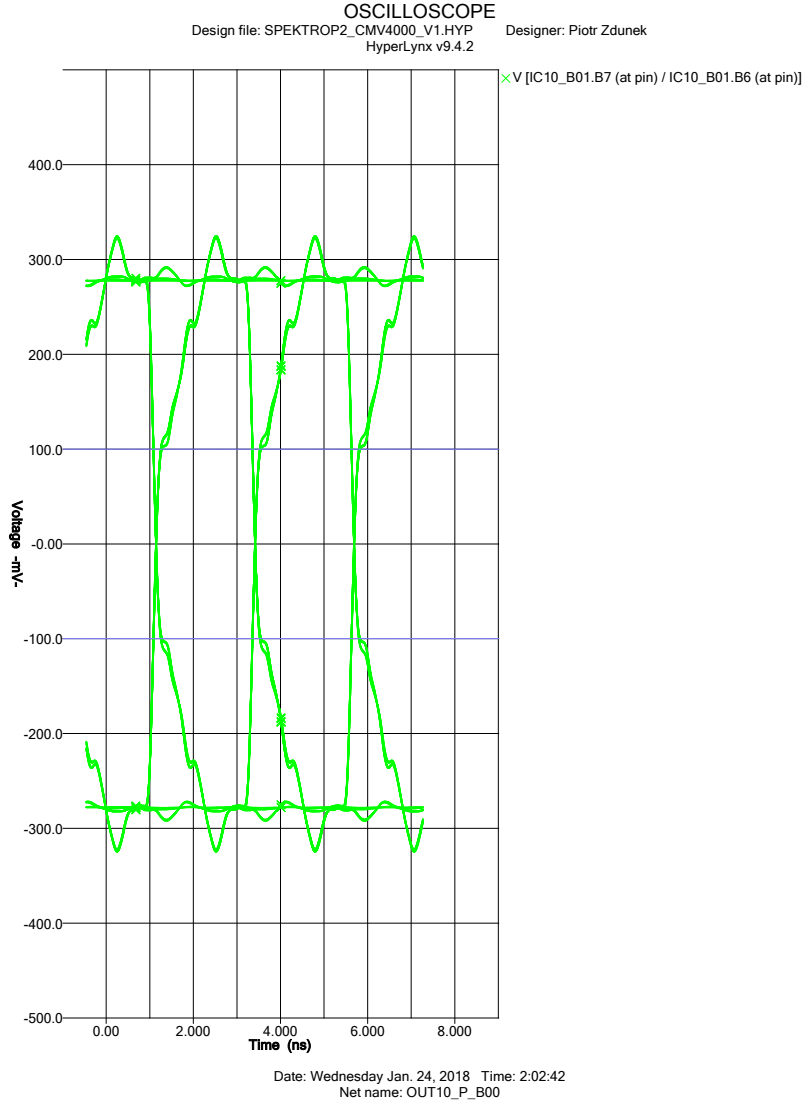
[picture p93: page 1]
Design file: SPEKTROP2_CMV4000_V1.HYP; Designer: Piotr Zdunek; HyperLynx v9.4.2; Net name: OUT10_P_B00

V [IC10_B01.B7 (at pin) / IC10_B01.B6 (at pin)]

Time (ns) Voltage -mV-

Date: Wednesday Jan. 24, 2018 Time: 2:02:42
