elhep/CMOS_Camera/HL_SIM/results/si/diff_pairs_eye_diagrams/CLK_MGT0_2.pdf

## OSCILLOSCOPE

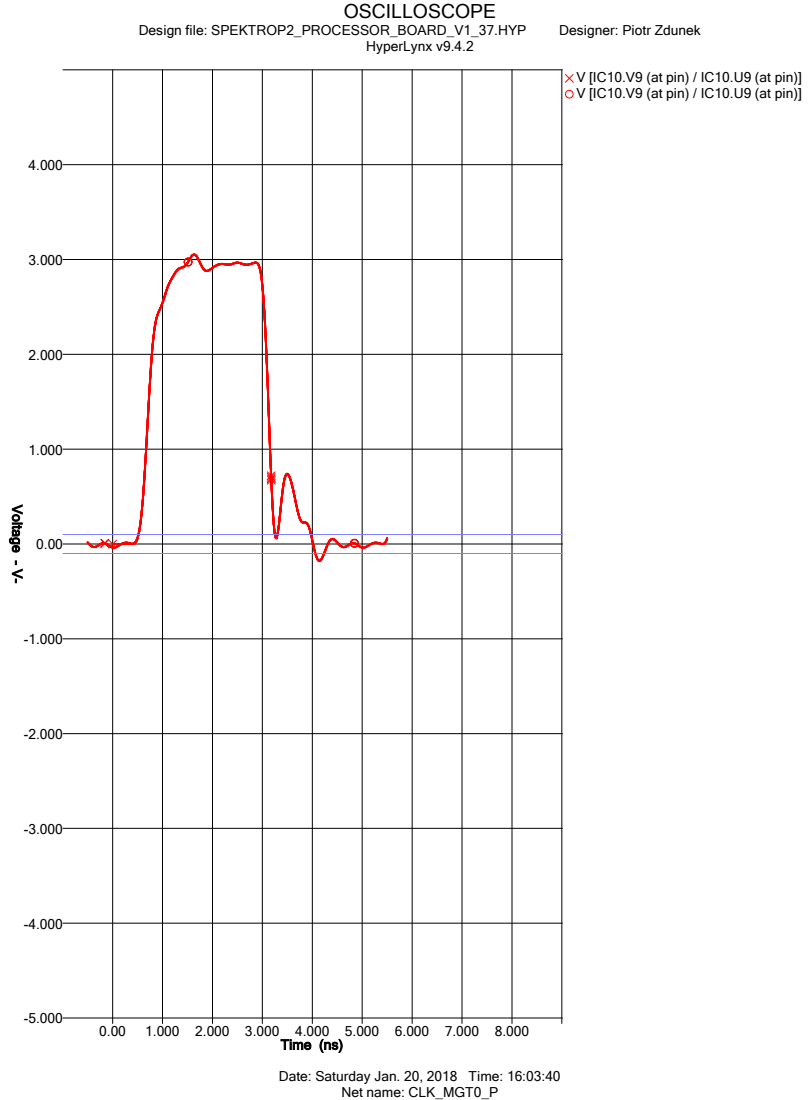
[picture p98: page 1]
Design file: SPEKTROP2_PROCESSOR_BOARD_V1_37.HYP; Designer: Piotr Zdunek; HyperLynx v9.4.2; Net name: CLK_MGT0_P

V [IC10.V9 (at pin) / IC10.U9 (at pin)]

Time (ns) Voltage - V-

Date: Saturday Jan. 20, 2018 Time: 16:03:40
