elhep/CMOS_Camera/HL_SIM/results/si/diff_pairs_eye_diagrams/MGT_RX0_ibis.pdf

## OSCILLOSCOPE

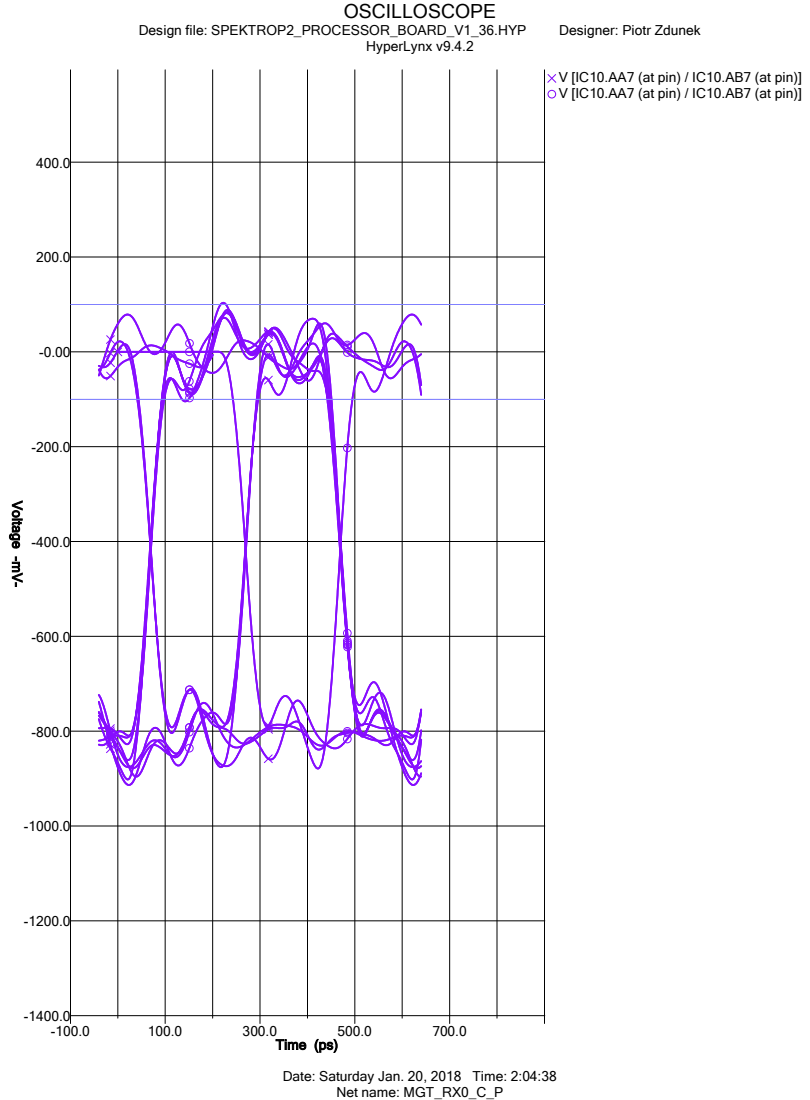
[picture p101: page 1]
Design file: SPEKTROP2_PROCESSOR_BOARD_V1_36.HYP; Designer: Piotr Zdunek; HyperLynx v9.4.2; Net name: MGT_RX0_C_P

V [IC10.AA7 (at pin) / IC10.AB7 (at pin)]

Time (ps) Voltage -mV-

Date: Saturday Jan. 20, 2018 Time: 2:04:38
