elhep/CMOS_Camera/HL_SIM/results/si/diff_pairs_eye_diagrams/MGT_TX0_5Gbps.pdf

## OSCILLOSCOPE

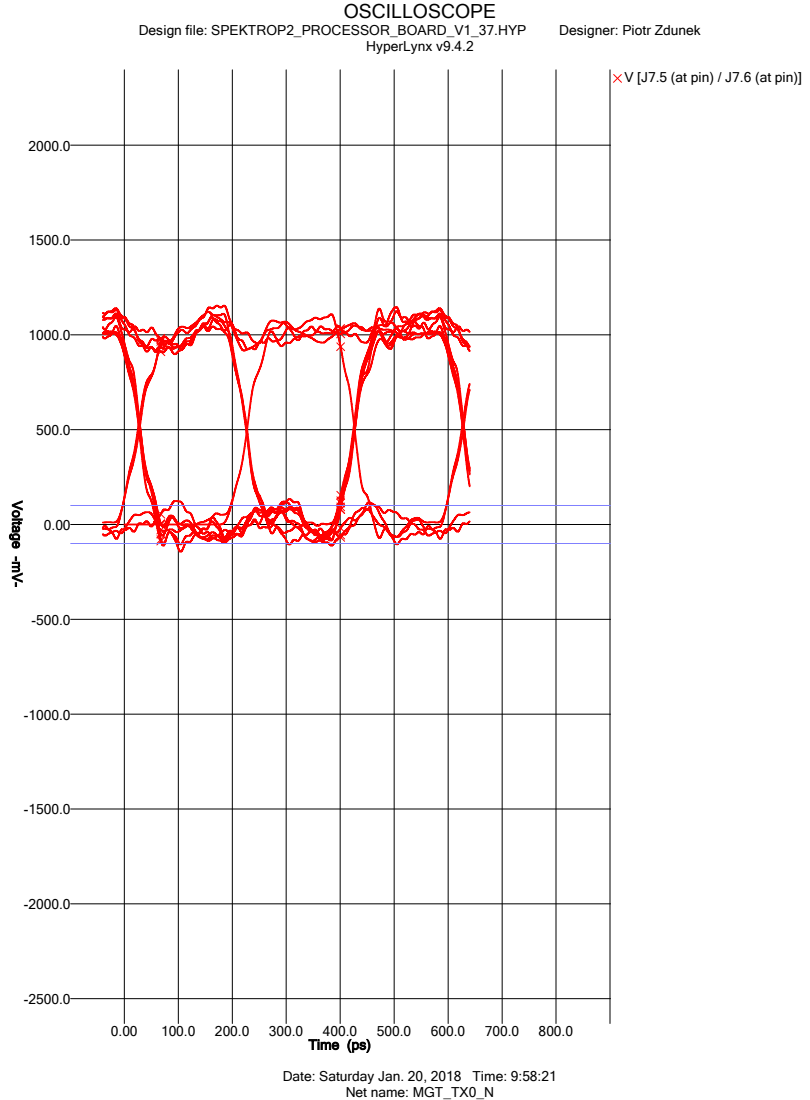
[picture p102: page 1]
Design file: SPEKTROP2_PROCESSOR_BOARD_V1_37.HYP; Designer: Piotr Zdunek; HyperLynx v9.4.2; Net name: MGT_TX0_N

V [J7.5 (at pin) / J7.6 (at pin)]

Time (ps) Voltage -mV-

Date: Saturday Jan. 20, 2018 Time: 9:58:21
