elhep/CMOS_Camera/HL_SIM/results/si/standard_time_domain_analysis/CLK_MGT0.pdf

## OSCILLOSCOPE

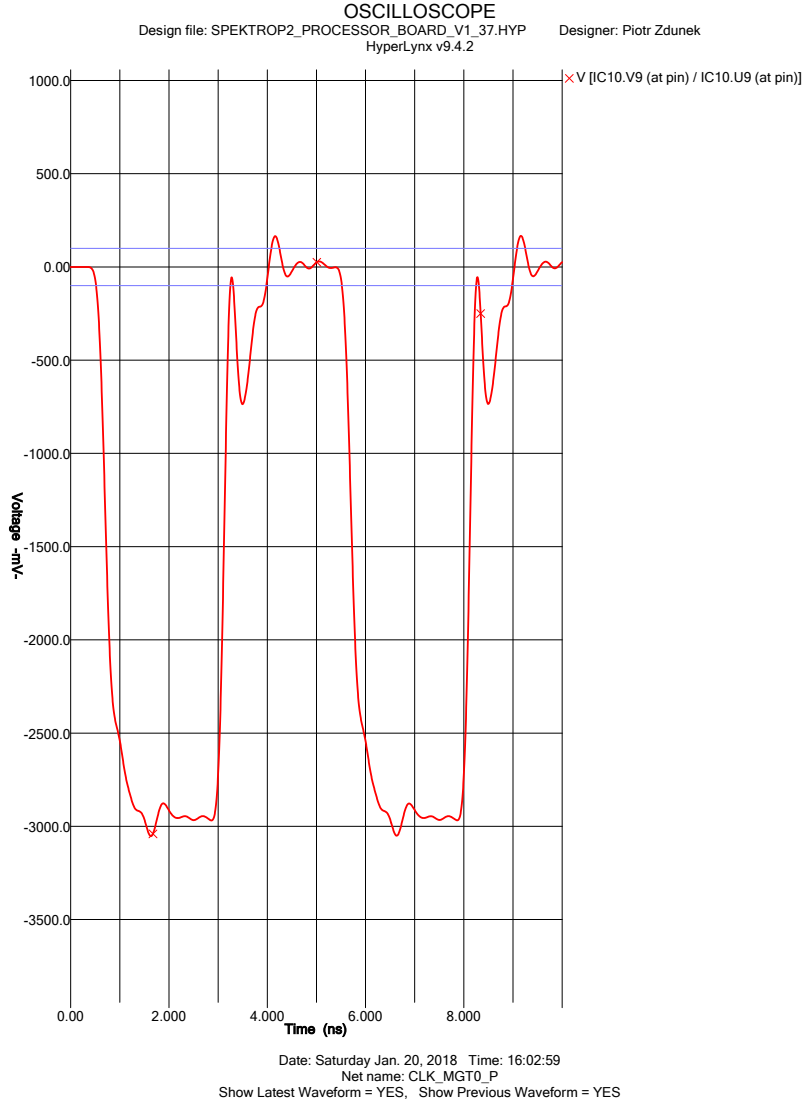
[picture p103: page 1]
Design file: SPEKTROP2_PROCESSOR_BOARD_V1_37.HYP; Designer: Piotr Zdunek; HyperLynx v9.4.2; Net name: CLK_MGT0_P

V [IC10.V9 (at pin) / IC10.U9 (at pin)]

Time (ns) Voltage -mV-

Date: Saturday Jan. 20, 2018 Time: 16:02:59

Show Latest Waveform = YES, Show Previous Waveform = YES
