elhep/CMOS_Camera/HL_SIM/results/si/standard_time_domain_analysis/CLK_MGT1.pdf

## OSCILLOSCOPE

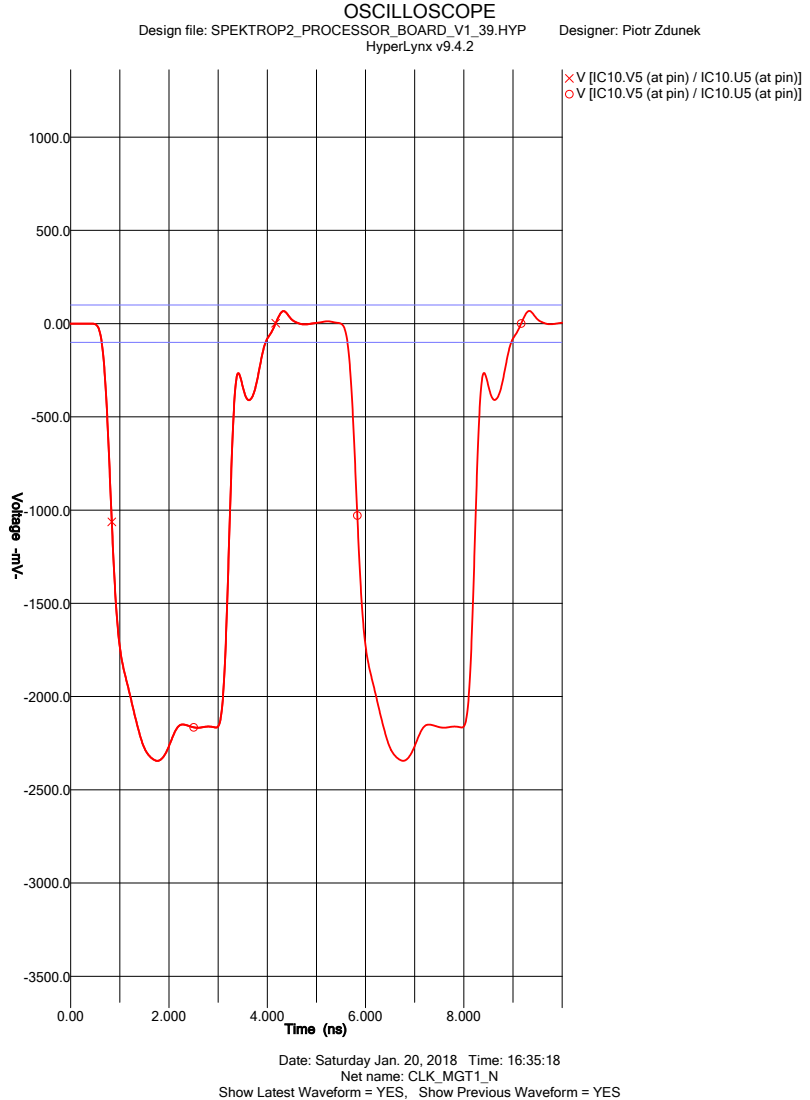
[picture p104: page 1]
Design file: SPEKTROP2_PROCESSOR_BOARD_V1_39.HYP; Designer: Piotr Zdunek; HyperLynx v9.4.2; Net name: CLK_MGT1_N

V [IC10.V5 (at pin) / IC10.U5 (at pin)]

Time (ns) Voltage -mV-

Date: Saturday Jan. 20, 2018 Time: 16:35:18

Show Latest Waveform = YES, Show Previous Waveform = YES
