elhep/CMOS_Camera/HL_SIM/results/si/standard_time_domain_analysis/HSTL_IN18_250MHz.pdf

## OSCILLOSCOPE

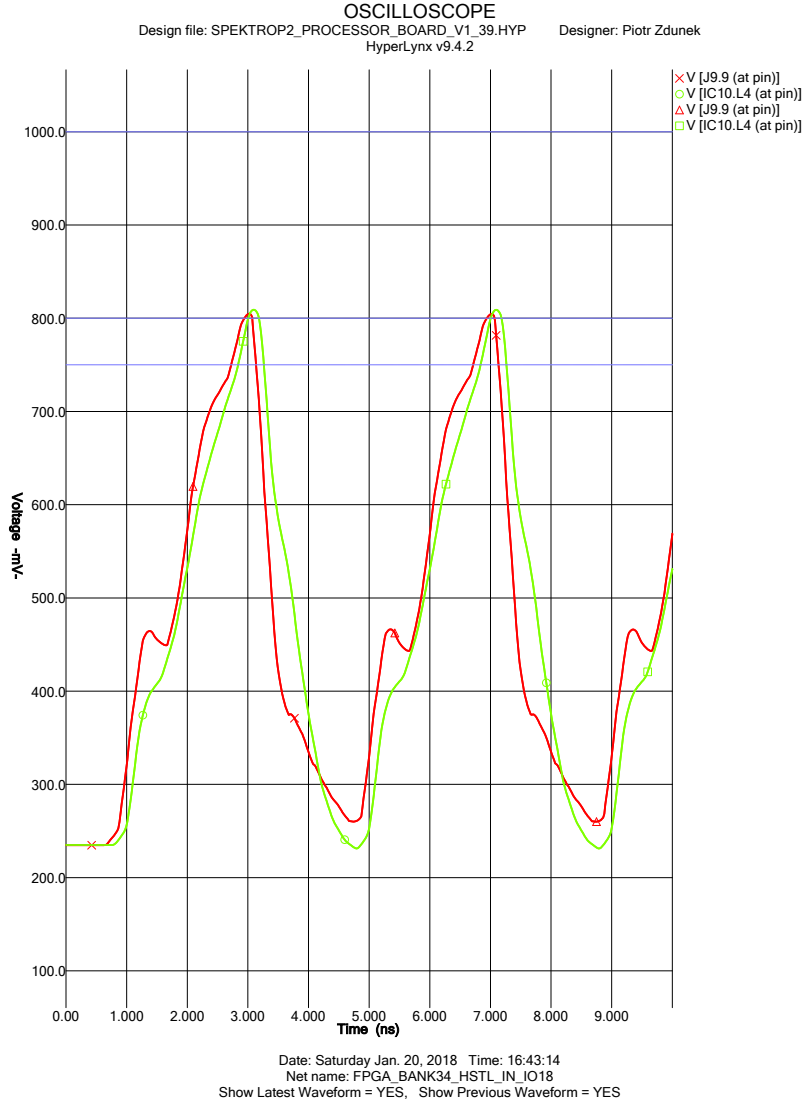
[picture p105: page 1]
Design file: SPEKTROP2_PROCESSOR_BOARD_V1_39.HYP; Designer: Piotr Zdunek; HyperLynx v9.4.2; V [J9.9 (at pin)] V [IC10.L4 (at pin)] V [J9.9 (at pin)] V [IC10.L4 (at pin)]

Time (ns) Voltage -mV-

Date: Saturday Jan. 20, 2018 Time: 16:43:14
Net name: FPGA_BANK34_HSTL_IN_IO18

Show Latest Waveform = YES, Show Previous Waveform = YES
