elhep/CMOS_Camera/HL_SIM/results/si/diff_pairs_eye_diagrams/FPGA_DIFF10.pdf

## OSCILLOSCOPE

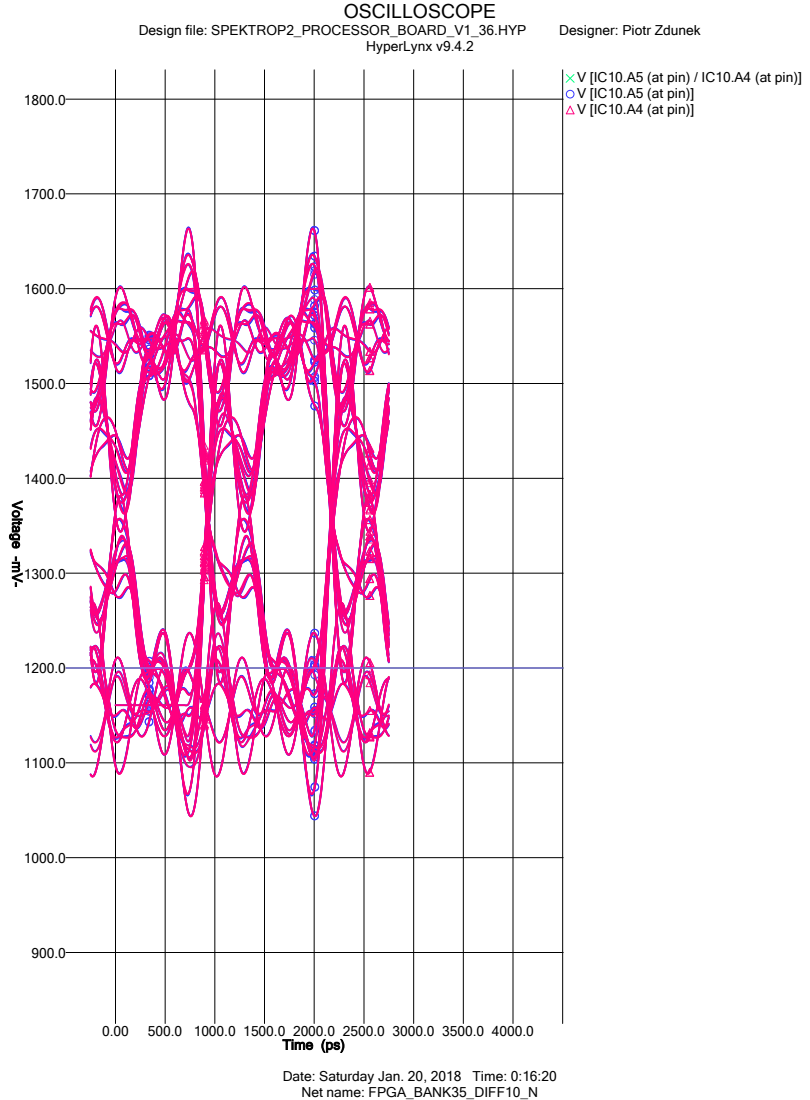
[picture p106: page 1]
Design file: SPEKTROP2_PROCESSOR_BOARD_V1_36.HYP; Designer: Piotr Zdunek; HyperLynx v9.4.2

V [IC10.A5 (at pin) / IC10.A4 (at pin)]
V [IC10.A5 (at pin)]
V [IC10.A4 (at pin)]

Time (ps) Voltage -mV-

Date: Saturday Jan. 20, 2018 Time: 0:16:20
Net name: FPGA_BANK35_DIFF10_N
