elhep/CMOS_Camera/(list of files, drawings)

Other design files:
Spektrop2_Combined_Proc_CMV4000_V1/PCB-Layout/PCB1.PcbDoc
Spektrop2_Combined_Proc_CMV4000_V1/Schematics/Sheet1.SchDoc
Spektrop2_Combined_Proc_CMV4000_V1/Spektrop2_Combined_Proc_CMV4000_V1.PrjPcb
Spektrop2_Combined_Proc_CMV4000_V1/TOP.SchDoc
Spektrop2_Combined_Proc_CMV4000_V1/TOP_COMBINED.SchDoc
Spektrop2_Processor_Board_V1/Schematics/CoaXPress.SchDoc
Spektrop2_Processor_Board_V1/Schematics/MGT_Clock_Generation.SchDoc
Spektrop2_Processor_Board_V1/Schematics/Power.SchDoc
Spektrop2_Processor_Board_V1/Schematics/RS485.SchDoc
Spektrop2_Processor_Board_V1/Schematics/SATA.SchDoc
Spektrop2_Processor_Board_V1/Schematics/Sensor_Board_Connectors_80_pin.SchDoc
Spektrop2_Processor_Board_V1/Schematics/Spektrop2.SchLib
Spektrop2_Processor_Board_V1/Schematics/TOP.SchDoc
Spektrop2_Processor_Board_V1/Schematics/TOP_PROC_BRD.SchDoc
Spektrop2_Processor_Board_V1/Schematics/UHD_SDI.SchDoc
Spektrop2_Processor_Board_V1/Schematics/Zynq_Config.SchDoc
Spektrop2_Processor_Board_V1/Schematics/Zynq_FPGA_Bank13.SchDoc
Spektrop2_Processor_Board_V1/Schematics/Zynq_FPGA_Bank34.SchDoc
Spektrop2_Processor_Board_V1/Schematics/Zynq_FPGA_Bank35.SchDoc
Spektrop2_Processor_Board_V1/Schematics/Zynq_FPGA_Unused.SchDoc
Spektrop2_Processor_Board_V1/Schematics/Zynq_MGT.SchDoc
Spektrop2_Processor_Board_V1/Schematics/Zynq_Power.SchDoc
Spektrop2_Processor_Board_V1/Schematics/Zynq_PS.SchDoc
Spektrop2_Processor_Board_V1/Schematics/Zynq_Top.SchDoc
Spektrop2_Processor_Board_V1/Spektrop2_Processor_Board_V1.PrjPcb
Spektrop2_Sensor_Board_CMV4000_V1/PCB-Layout/Spektrop2_Sensor_Board_CMV4000_V1.PcbDoc
Spektrop2_Sensor_Board_CMV4000_V1/Schematics/CMV4000.SchDoc
Spektrop2_Sensor_Board_CMV4000_V1/Schematics/Power.SchDoc
Spektrop2_Sensor_Board_CMV4000_V1/Schematics/Power_Supply.SchDoc
Spektrop2_Sensor_Board_CMV4000_V1/Schematics/Processor_Board_Connectors.SchDoc
Spektrop2_Sensor_Board_CMV4000_V1/Schematics/TOP.SchDoc
Spektrop2_Sensor_Board_CMV4000_V1/Spektrop2_Sensor_Board_CMV4000_V1.PrjPcb
Spektrop2_Sensor_Board_V1/PCB-Layout/Spektrop2_Sensor_Board_V1.PcbDoc
Spektrop2_Sensor_Board_V1/Schematics/Power.SchDoc
Spektrop2_Sensor_Board_V1/Schematics/Processing_Board_Connectors.SchDoc
Spektrop2_Sensor_Board_V1/Schematics/Sensor_CIS1910F.SchDoc
Spektrop2_Sensor_Board_V1/Schematics/Sensor_CIS1910F_Power.SchDoc
Spektrop2_Sensor_Board_V1/Schematics/TOP.SchDoc
Spektrop2_Sensor_Board_V1/Spektrop2_Sensor_Board_V1.PrjPcb
