elhep/CMOS_Camera/Vivado/Spektrop2_CMV4000_V3/Spektrop2_CMV4000_V2.srcs/sources_1/bd/sensor_readout/ip/sensor_readout_axis_combiner_0_0/synth/sensor_readout_axis_combiner_0_0.v

// (c) Copyright 1995-2018 Xilinx, Inc. All rights reserved.
// 
// This file contains confidential and proprietary information
// of Xilinx, Inc. and is protected under U.S. and
// international copyright and other intellectual property
// laws.
// 
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
// CRITICAL APPLICATIONS
// Xilinx products are not designed or intended to be fail-
// safe, or for use in any application requiring fail-safe
// performance, such as life-support or safety devices or
// systems, Class III medical devices, nuclear facilities,
// applications related to the deployment of airbags, or any
// other applications that could lead to death, personal
// injury, or severe property or environmental damage
// (individually and collectively, "Critical
// Applications"). Customer assumes the sole risk and
// liability of any use of Xilinx products in Critical
// Applications, subject only to applicable laws and
// regulations governing limitations on product liability.
// 
// THIS COPYRIGHT NOTICE AND DISCLAIMER MUST BE RETAINED AS
// PART OF THIS FILE AT ALL TIMES.
// 
// DO NOT MODIFY THIS FILE.


// IP VLNV: xilinx.com:ip:axis_combiner:1.1
// IP Revision: 14

(* X_CORE_INFO = "axis_combiner_v1_1_14_top,Vivado 2017.4" *)
(* CHECK_LICENSE_TYPE = "sensor_readout_axis_combiner_0_0,axis_combiner_v1_1_14_top,{}" *)
(* CORE_GENERATION_INFO = "sensor_readout_axis_combiner_0_0,axis_combiner_v1_1_14_top,{x_ipProduct=Vivado 2017.4,x_ipVendor=xilinx.com,x_ipLibrary=ip,x_ipName=axis_combiner,x_ipVersion=1.1,x_ipCoreRevision=14,x_ipLanguage=VHDL,x_ipSimLanguage=MIXED,C_FAMILY=zynq,C_AXIS_TDATA_WIDTH=64,C_AXIS_TID_WIDTH=1,C_AXIS_TDEST_WIDTH=1,C_AXIS_TUSER_WIDTH=1,C_AXIS_SIGNAL_SET=0b00000000000000000000000010010011,C_MASTER_PORT_NUM=0,C_NUM_SI_SLOTS=2}" *)
(* DowngradeIPIdentifiedWarnings = "yes" *)
module sensor_readout_axis_combiner_0_0 (
  aclk,
  aresetn,
  s_axis_tvalid,
  s_axis_tready,
  s_axis_tdata,
  s_axis_tlast,
  s_axis_tuser,
  m_axis_tvalid,
  m_axis_tready,
  m_axis_tdata,
  m_axis_tlast,
  m_axis_tuser
);

(* X_INTERFACE_PARAMETER = "XIL_INTERFACENAME CLKIF, FREQ_HZ 10000000, PHASE 0.000, CLK_DOMAIN sensor_readout_aclk_0, ASSOCIATED_BUSIF S00_AXIS:S01_AXIS:S02_AXIS:S03_AXIS:S04_AXIS:S05_AXIS:S06_AXIS:S07_AXIS:S08_AXIS:S09_AXIS:S10_AXIS:S11_AXIS:S12_AXIS:S13_AXIS:S14_AXIS:S15_AXIS:M_AXIS, ASSOCIATED_RESET aresetn, ASSOCIATED_CLKEN aclken" *)
(* X_INTERFACE_INFO = "xilinx.com:signal:clock:1.0 CLKIF CLK" *)
input wire aclk;
(* X_INTERFACE_PARAMETER = "XIL_INTERFACENAME RSTIF, POLARITY ACTIVE_LOW, TYPE INTERCONNECT" *)
(* X_INTERFACE_INFO = "xilinx.com:signal:reset:1.0 RSTIF RST" *)
input wire aresetn;
(* X_INTERFACE_INFO = "xilinx.com:interface:axis:1.0 S00_AXIS TVALID [0:0] [0:0], xilinx.com:interface:axis:1.0 S01_AXIS TVALID [0:0] [1:1]" *)
input wire [1 : 0] s_axis_tvalid;
(* X_INTERFACE_INFO = "xilinx.com:interface:axis:1.0 S00_AXIS TREADY [0:0] [0:0], xilinx.com:interface:axis:1.0 S01_AXIS TREADY [0:0] [1:1]" *)
output wire [1 : 0] s_axis_tready;
(* X_INTERFACE_INFO = "xilinx.com:interface:axis:1.0 S00_AXIS TDATA [63:0] [63:0], xilinx.com:interface:axis:1.0 S01_AXIS TDATA [63:0] [127:64]" *)
input wire [127 : 0] s_axis_tdata;
(* X_INTERFACE_INFO = "xilinx.com:interface:axis:1.0 S00_AXIS TLAST [0:0] [0:0], xilinx.com:interface:axis:1.0 S01_AXIS TLAST [0:0] [1:1]" *)
input wire [1 : 0] s_axis_tlast;
(* X_INTERFACE_PARAMETER = "XIL_INTERFACENAME S00_AXIS, TDATA_NUM_BYTES 8, TDEST_WIDTH 0, TID_WIDTH 0, TUSER_WIDTH 1, HAS_TREADY 1, HAS_TSTRB 0, HAS_TKEEP 0, HAS_TLAST 1, FREQ_HZ 10000000, PHASE 0.000, CLK_DOMAIN sensor_readout_aclk_0, LAYERED_METADATA xilinx.com:interface:datatypes:1.0 {TDATA {data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
(* X_INTERFACE_INFO = "xilinx.com:interface:axis:1.0 S00_AXIS TUSER [0:0] [0:0], xilinx.com:interface:axis:1.0 S01_AXIS TUSER [0:0] [1:1]" *)
input wire [1 : 0] s_axis_tuser;
(* X_INTERFACE_INFO = "xilinx.com:interface:axis:1.0 M_AXIS TVALID" *)
output wire m_axis_tvalid;
(* X_INTERFACE_INFO = "xilinx.com:interface:axis:1.0 M_AXIS TREADY" *)
input wire m_axis_tready;
(* X_INTERFACE_INFO = "xilinx.com:interface:axis:1.0 M_AXIS TDATA" *)
output wire [127 : 0] m_axis_tdata;
(* X_INTERFACE_INFO = "xilinx.com:interface:axis:1.0 M_AXIS TLAST" *)
output wire m_axis_tlast;
(* X_INTERFACE_PARAMETER = "XIL_INTERFACENAME M_AXIS, TDATA_NUM_BYTES 16, TDEST_WIDTH 0, TID_WIDTH 0, TUSER_WIDTH 2, HAS_TREADY 1, HAS_TSTRB 0, HAS_TKEEP 0, HAS_TLAST 1, FREQ_HZ 10000000, PHASE 0.000, CLK_DOMAIN sensor_readout_aclk_0, LAYERED_METADATA undef" *)
(* X_INTERFACE_INFO = "xilinx.com:interface:axis:1.0 M_AXIS TUSER" *)
output wire [1 : 0] m_axis_tuser;

  axis_combiner_v1_1_14_top #(
    .C_FAMILY("zynq"),
    .C_AXIS_TDATA_WIDTH(64),
    .C_AXIS_TID_WIDTH(1),
    .C_AXIS_TDEST_WIDTH(1),
    .C_AXIS_TUSER_WIDTH(1),
    .C_AXIS_SIGNAL_SET(32'B00000000000000000000000010010011),
    .C_MASTER_PORT_NUM(0),
    .C_NUM_SI_SLOTS(2)
  ) inst (
    .aclk(aclk),
    .aresetn(aresetn),
    .aclken(1'H1),
    .s_axis_tvalid(s_axis_tvalid),
    .s_axis_tready(s_axis_tready),
    .s_axis_tdata(s_axis_tdata),
    .s_axis_tstrb(16'HFFFF),
    .s_axis_tkeep(16'HFFFF),
    .s_axis_tlast(s_axis_tlast),
    .s_axis_tid(2'H0),
    .s_axis_tdest(2'H0),
    .s_axis_tuser(s_axis_tuser),
    .m_axis_tvalid(m_axis_tvalid),
    .m_axis_tready(m_axis_tready),
    .m_axis_tdata(m_axis_tdata),
    .m_axis_tstrb(),
    .m_axis_tkeep(),
    .m_axis_tlast(m_axis_tlast),
    .m_axis_tid(),
    .m_axis_tdest(),
    .m_axis_tuser(m_axis_tuser),
    .s_cmd_err()
  );
endmodule
