elhep/CMOS_Camera/Vivado/Spektrop2_CMV4000_V3/Spektrop2_CMV4000_V2.srcs/sources_1/bd/system/synth/system.vhd

--Copyright 1986-2017 Xilinx, Inc. All Rights Reserved.
----------------------------------------------------------------------------------
--Tool Version: Vivado v.2017.4 (win64) Build 2086221 Fri Dec 15 20:55:39 MST 2017
--Date        : Tue Mar 13 02:20:09 2018
--Host        : DESKTOP-C5LKN8N running 64-bit major release  (build 9200)
--Command     : generate_target system.bd
--Design      : system
--Purpose     : IP block netlist
----------------------------------------------------------------------------------
library IEEE;
use IEEE.STD_LOGIC_1164.ALL;
library UNISIM;
use UNISIM.VCOMPONENTS.ALL;
entity m00_couplers_imp_1H7AUOX is
  port (
    M_ACLK : in STD_LOGIC;
    M_ARESETN : in STD_LOGIC;
    M_AXI_araddr : out STD_LOGIC_VECTOR ( 31 downto 0 );
    M_AXI_arprot : out STD_LOGIC_VECTOR ( 2 downto 0 );
    M_AXI_arready : in STD_LOGIC_VECTOR ( 0 to 0 );
    M_AXI_arvalid : out STD_LOGIC_VECTOR ( 0 to 0 );
    M_AXI_awaddr : out STD_LOGIC_VECTOR ( 31 downto 0 );
    M_AXI_awprot : out STD_LOGIC_VECTOR ( 2 downto 0 );
    M_AXI_awready : in STD_LOGIC_VECTOR ( 0 to 0 );
    M_AXI_awvalid : out STD_LOGIC_VECTOR ( 0 to 0 );
    M_AXI_bready : out STD_LOGIC_VECTOR ( 0 to 0 );
    M_AXI_bresp : in STD_LOGIC_VECTOR ( 1 downto 0 );
    M_AXI_bvalid : in STD_LOGIC_VECTOR ( 0 to 0 );
    M_AXI_rdata : in STD_LOGIC_VECTOR ( 31 downto 0 );
    M_AXI_rready : out STD_LOGIC_VECTOR ( 0 to 0 );
    M_AXI_rresp : in STD_LOGIC_VECTOR ( 1 downto 0 );
    M_AXI_rvalid : in STD_LOGIC_VECTOR ( 0 to 0 );
    M_AXI_wdata : out STD_LOGIC_VECTOR ( 31 downto 0 );
    M_AXI_wready : in STD_LOGIC_VECTOR ( 0 to 0 );
    M_AXI_wstrb : out STD_LOGIC_VECTOR ( 3 downto 0 );
    M_AXI_wvalid : out STD_LOGIC_VECTOR ( 0 to 0 );
    S_ACLK : in STD_LOGIC;
    S_ARESETN : in STD_LOGIC;
    S_AXI_araddr : in STD_LOGIC_VECTOR ( 31 downto 0 );
    S_AXI_arprot : in STD_LOGIC_VECTOR ( 2 downto 0 );
    S_AXI_arready : out STD_LOGIC_VECTOR ( 0 to 0 );
    S_AXI_arvalid : in STD_LOGIC_VECTOR ( 0 to 0 );
    S_AXI_awaddr : in STD_LOGIC_VECTOR ( 31 downto 0 );
    S_AXI_awprot : in STD_LOGIC_VECTOR ( 2 downto 0 );
    S_AXI_awready : out STD_LOGIC_VECTOR ( 0 to 0 );
    S_AXI_awvalid : in STD_LOGIC_VECTOR ( 0 to 0 );
    S_AXI_bready : in STD_LOGIC_VECTOR ( 0 to 0 );
    S_AXI_bresp : out STD_LOGIC_VECTOR ( 1 downto 0 );
    S_AXI_bvalid : out STD_LOGIC_VECTOR ( 0 to 0 );
    S_AXI_rdata : out STD_LOGIC_VECTOR ( 31 downto 0 );
    S_AXI_rready : in STD_LOGIC_VECTOR ( 0 to 0 );
    S_AXI_rresp : out STD_LOGIC_VECTOR ( 1 downto 0 );
    S_AXI_rvalid : out STD_LOGIC_VECTOR ( 0 to 0 );
    S_AXI_wdata : in STD_LOGIC_VECTOR ( 31 downto 0 );
    S_AXI_wready : out STD_LOGIC_VECTOR ( 0 to 0 );
    S_AXI_wstrb : in STD_LOGIC_VECTOR ( 3 downto 0 );
    S_AXI_wvalid : in STD_LOGIC_VECTOR ( 0 to 0 )
  );
end m00_couplers_imp_1H7AUOX;

architecture STRUCTURE of m00_couplers_imp_1H7AUOX is
  signal m00_couplers_to_m00_couplers_ARADDR : STD_LOGIC_VECTOR ( 31 downto 0 );
  signal m00_couplers_to_m00_couplers_ARPROT : STD_LOGIC_VECTOR ( 2 downto 0 );
  signal m00_couplers_to_m00_couplers_ARREADY : STD_LOGIC_VECTOR ( 0 to 0 );
  signal m00_couplers_to_m00_couplers_ARVALID : STD_LOGIC_VECTOR ( 0 to 0 );
  signal m00_couplers_to_m00_couplers_AWADDR : STD_LOGIC_VECTOR ( 31 downto 0 );
  signal m00_couplers_to_m00_couplers_AWPROT : STD_LOGIC_VECTOR ( 2 downto 0 );
  signal m00_couplers_to_m00_couplers_AWREADY : STD_LOGIC_VECTOR ( 0 to 0 );
  signal m00_couplers_to_m00_couplers_AWVALID : STD_LOGIC_VECTOR ( 0 to 0 );
  signal m00_couplers_to_m00_couplers_BREADY : STD_LOGIC_VECTOR ( 0 to 0 );
  signal m00_couplers_to_m00_couplers_BRESP : STD_LOGIC_VECTOR ( 1 downto 0 );
  signal m00_couplers_to_m00_couplers_BVALID : STD_LOGIC_VECTOR ( 0 to 0 );
  signal m00_couplers_to_m00_couplers_RDATA : STD_LOGIC_VECTOR ( 31 downto 0 );
  signal m00_couplers_to_m00_couplers_RREADY : STD_LOGIC_VECTOR ( 0 to 0 );
  signal m00_couplers_to_m00_couplers_RRESP : STD_LOGIC_VECTOR ( 1 downto 0 );
  signal m00_couplers_to_m00_couplers_RVALID : STD_LOGIC_VECTOR ( 0 to 0 );
  signal m00_couplers_to_m00_couplers_WDATA : STD_LOGIC_VECTOR ( 31 downto 0 );
  signal m00_couplers_to_m00_couplers_WREADY : STD_LOGIC_VECTOR ( 0 to 0 );
  signal m00_couplers_to_m00_couplers_WSTRB : STD_LOGIC_VECTOR ( 3 downto 0 );
  signal m00_couplers_to_m00_couplers_WVALID : STD_LOGIC_VECTOR ( 0 to 0 );
begin
  M_AXI_araddr(31 downto 0) <= m00_couplers_to_m00_couplers_ARADDR(31 downto 0);
  M_AXI_arprot(2 downto 0) <= m00_couplers_to_m00_couplers_ARPROT(2 downto 0);
  M_AXI_arvalid(0) <= m00_couplers_to_m00_couplers_ARVALID(0);
  M_AXI_awaddr(31 downto 0) <= m00_couplers_to_m00_couplers_AWADDR(31 downto 0);
  M_AXI_awprot(2 downto 0) <= m00_couplers_to_m00_couplers_AWPROT(2 downto 0);
  M_AXI_awvalid(0) <= m00_couplers_to_m00_couplers_AWVALID(0);
  M_AXI_bready(0) <= m00_couplers_to_m00_couplers_BREADY(0);
  M_AXI_rready(0) <= m00_couplers_to_m00_couplers_RREADY(0);
  M_AXI_wdata(31 downto 0) <= m00_couplers_to_m00_couplers_WDATA(31 downto 0);
  M_AXI_wstrb(3 downto 0) <= m00_couplers_to_m00_couplers_WSTRB(3 downto 0);
  M_AXI_wvalid(0) <= m00_couplers_to_m00_couplers_WVALID(0);
  S_AXI_arready(0) <= m00_couplers_to_m00_couplers_ARREADY(0);
  S_AXI_awready(0) <= m00_couplers_to_m00_couplers_AWREADY(0);
  S_AXI_bresp(1 downto 0) <= m00_couplers_to_m00_couplers_BRESP(1 downto 0);
  S_AXI_bvalid(0) <= m00_couplers_to_m00_couplers_BVALID(0);
  S_AXI_rdata(31 downto 0) <= m00_couplers_to_m00_couplers_RDATA(31 downto 0);
  S_AXI_rresp(1 downto 0) <= m00_couplers_to_m00_couplers_RRESP(1 downto 0);
  S_AXI_rvalid(0) <= m00_couplers_to_m00_couplers_RVALID(0);
  S_AXI_wready(0) <= m00_couplers_to_m00_couplers_WREADY(0);
  m00_couplers_to_m00_couplers_ARADDR(31 downto 0) <= S_AXI_araddr(31 downto 0);
  m00_couplers_to_m00_couplers_ARPROT(2 downto 0) <= S_AXI_arprot(2 downto 0);
  m00_couplers_to_m00_couplers_ARREADY(0) <= M_AXI_arready(0);
  m00_couplers_to_m00_couplers_ARVALID(0) <= S_AXI_arvalid(0);
  m00_couplers_to_m00_couplers_AWADDR(31 downto 0) <= S_AXI_awaddr(31 downto 0);
  m00_couplers_to_m00_couplers_AWPROT(2 downto 0) <= S_AXI_awprot(2 downto 0);
  m00_couplers_to_m00_couplers_AWREADY(0) <= M_AXI_awready(0);
  m00_couplers_to_m00_couplers_AWVALID(0) <= S_AXI_awvalid(0);
  m00_couplers_to_m00_couplers_BREADY(0) <= S_AXI_bready(0);
  m00_couplers_to_m00_couplers_BRESP(1 downto 0) <= M_AXI_bresp(1 downto 0);
  m00_couplers_to_m00_couplers_BVALID(0) <= M_AXI_bvalid(0);
  m00_couplers_to_m00_couplers_RDATA(31 downto 0) <= M_AXI_rdata(31 downto 0);
  m00_couplers_to_m00_couplers_RREADY(0) <= S_AXI_rready(0);
  m00_couplers_to_m00_couplers_RRESP(1 downto 0) <= M_AXI_rresp(1 downto 0);
  m00_couplers_to_m00_couplers_RVALID(0) <= M_AXI_rvalid(0);
  m00_couplers_to_m00_couplers_WDATA(31 downto 0) <= S_AXI_wdata(31 downto 0);
  m00_couplers_to_m00_couplers_WREADY(0) <= M_AXI_wready(0);
  m00_couplers_to_m00_couplers_WSTRB(3 downto 0) <= S_AXI_wstrb(3 downto 0);
  m00_couplers_to_m00_couplers_WVALID(0) <= S_AXI_wvalid(0);
end STRUCTURE;
library IEEE;
use IEEE.STD_LOGIC_1164.ALL;
library UNISIM;
use UNISIM.VCOMPONENTS.ALL;
entity m01_couplers_imp_4Y7TYO is
  port (
    M_ACLK : in STD_LOGIC;
    M_ARESETN : in STD_LOGIC;
    M_AXI_araddr : out STD_LOGIC_VECTOR ( 31 downto 0 );
    M_AXI_arready : in STD_LOGIC;
    M_AXI_arvalid : out STD_LOGIC;
    M_AXI_awaddr : out STD_LOGIC_VECTOR ( 31 downto 0 );
    M_AXI_awready : in STD_LOGIC;
    M_AXI_awvalid : out STD_LOGIC;
    M_AXI_bready : out STD_LOGIC;
    M_AXI_bresp : in STD_LOGIC_VECTOR ( 1 downto 0 );
    M_AXI_bvalid : in STD_LOGIC;
    M_AXI_rdata : in STD_LOGIC_VECTOR ( 31 downto 0 );
    M_AXI_rready : out STD_LOGIC;
    M_AXI_rresp : in STD_LOGIC_VECTOR ( 1 downto 0 );
    M_AXI_rvalid : in STD_LOGIC;
    M_AXI_wdata : out STD_LOGIC_VECTOR ( 31 downto 0 );
    M_AXI_wready : in STD_LOGIC;
    M_AXI_wstrb : out STD_LOGIC_VECTOR ( 3 downto 0 );
    M_AXI_wvalid : out STD_LOGIC;
    S_ACLK : in STD_LOGIC;
    S_ARESETN : in STD_LOGIC;
    S_AXI_araddr : in STD_LOGIC_VECTOR ( 31 downto 0 );
    S_AXI_arready : out STD_LOGIC;
    S_AXI_arvalid : in STD_LOGIC;
    S_AXI_awaddr : in STD_LOGIC_VECTOR ( 31 downto 0 );
    S_AXI_awready : out STD_LOGIC;
    S_AXI_awvalid : in STD_LOGIC;
    S_AXI_bready : in STD_LOGIC;
    S_AXI_bresp : out STD_LOGIC_VECTOR ( 1 downto 0 );
    S_AXI_bvalid : out STD_LOGIC;
    S_AXI_rdata : out STD_LOGIC_VECTOR ( 31 downto 0 );
    S_AXI_rready : in STD_LOGIC;
    S_AXI_rresp : out STD_LOGIC_VECTOR ( 1 downto 0 );
    S_AXI_rvalid : out STD_LOGIC;
    S_AXI_wdata : in STD_LOGIC_VECTOR ( 31 downto 0 );
    S_AXI_wready : out STD_LOGIC;
    S_AXI_wstrb : in STD_LOGIC_VECTOR ( 3 downto 0 );
    S_AXI_wvalid : in STD_LOGIC
  );
end m01_couplers_imp_4Y7TYO;

architecture STRUCTURE of m01_couplers_imp_4Y7TYO is
  signal m01_couplers_to_m01_couplers_ARADDR : STD_LOGIC_VECTOR ( 31 downto 0 );
  signal m01_couplers_to_m01_couplers_ARREADY : STD_LOGIC;
  signal m01_couplers_to_m01_couplers_ARVALID : STD_LOGIC;
  signal m01_couplers_to_m01_couplers_AWADDR : STD_LOGIC_VECTOR ( 31 downto 0 );
  signal m01_couplers_to_m01_couplers_AWREADY : STD_LOGIC;
  signal m01_couplers_to_m01_couplers_AWVALID : STD_LOGIC;
  signal m01_couplers_to_m01_couplers_BREADY : STD_LOGIC;
  signal m01_couplers_to_m01_couplers_BRESP : STD_LOGIC_VECTOR ( 1 downto 0 );
  signal m01_couplers_to_m01_couplers_BVALID : STD_LOGIC;
  signal m01_couplers_to_m01_couplers_RDATA : STD_LOGIC_VECTOR ( 31 downto 0 );
  signal m01_couplers_to_m01_couplers_RREADY : STD_LOGIC;
  signal m01_couplers_to_m01_couplers_RRESP : STD_LOGIC_VECTOR ( 1 downto 0 );
  signal m01_couplers_to_m01_couplers_RVALID : STD_LOGIC;
  signal m01_couplers_to_m01_couplers_WDATA : STD_LOGIC_VECTOR ( 31 downto 0 );
  signal m01_couplers_to_m01_couplers_WREADY : STD_LOGIC;
  signal m01_couplers_to_m01_couplers_WSTRB : STD_LOGIC_VECTOR ( 3 downto 0 );
  signal m01_couplers_to_m01_couplers_WVALID : STD_LOGIC;
begin
  M_AXI_araddr(31 downto 0) <= m01_couplers_to_m01_couplers_ARADDR(31 downto 0);
  M_AXI_arvalid <= m01_couplers_to_m01_couplers_ARVALID;
  M_AXI_awaddr(31 downto 0) <= m01_couplers_to_m01_couplers_AWADDR(31 downto 0);
  M_AXI_awvalid <= m01_couplers_to_m01_couplers_AWVALID;
  M_AXI_bready <= m01_couplers_to_m01_couplers_BREADY;
  M_AXI_rready <= m01_couplers_to_m01_couplers_RREADY;
  M_AXI_wdata(31 downto 0) <= m01_couplers_to_m01_couplers_WDATA(31 downto 0);
  M_AXI_wstrb(3 downto 0) <= m01_couplers_to_m01_couplers_WSTRB(3 downto 0);
  M_AXI_wvalid <= m01_couplers_to_m01_couplers_WVALID;
  S_AXI_arready <= m01_couplers_to_m01_couplers_ARREADY;
  S_AXI_awready <= m01_couplers_to_m01_couplers_AWREADY;
  S_AXI_bresp(1 downto 0) <= m01_couplers_to_m01_couplers_BRESP(1 downto 0);
  S_AXI_bvalid <= m01_couplers_to_m01_couplers_BVALID;
  S_AXI_rdata(31 downto 0) <= m01_couplers_to_m01_couplers_RDATA(31 downto 0);
  S_AXI_rresp(1 downto 0) <= m01_couplers_to_m01_couplers_RRESP(1 downto 0);
  S_AXI_rvalid <= m01_couplers_to_m01_couplers_RVALID;
  S_AXI_wready <= m01_couplers_to_m01_couplers_WREADY;
  m01_couplers_to_m01_couplers_ARADDR(31 downto 0) <= S_AXI_araddr(31 downto 0);
  m01_couplers_to_m01_couplers_ARREADY <= M_AXI_arready;
  m01_couplers_to_m01_couplers_ARVALID <= S_AXI_arvalid;
  m01_couplers_to_m01_couplers_AWADDR(31 downto 0) <= S_AXI_awaddr(31 downto 0);
  m01_couplers_to_m01_couplers_AWREADY <= M_AXI_awready;
  m01_couplers_to_m01_couplers_AWVALID <= S_AXI_awvalid;
  m01_couplers_to_m01_couplers_BREADY <= S_AXI_bready;
  m01_couplers_to_m01_couplers_BRESP(1 downto 0) <= M_AXI_bresp(1 downto 0);
  m01_couplers_to_m01_couplers_BVALID <= M_AXI_bvalid;
  m01_couplers_to_m01_couplers_RDATA(31 downto 0) <= M_AXI_rdata(31 downto 0);
  m01_couplers_to_m01_couplers_RREADY <= S_AXI_rready;
  m01_couplers_to_m01_couplers_RRESP(1 downto 0) <= M_AXI_rresp(1 downto 0);
  m01_couplers_to_m01_couplers_RVALID <= M_AXI_rvalid;
  m01_couplers_to_m01_couplers_WDATA(31 downto 0) <= S_AXI_wdata(31 downto 0);
  m01_couplers_to_m01_couplers_WREADY <= M_AXI_wready;
  m01_couplers_to_m01_couplers_WSTRB(3 downto 0) <= S_AXI_wstrb(3 downto 0);
  m01_couplers_to_m01_couplers_WVALID <= S_AXI_wvalid;
end STRUCTURE;
library IEEE;
use IEEE.STD_LOGIC_1164.ALL;
library UNISIM;
use UNISIM.VCOMPONENTS.ALL;
entity m02_couplers_imp_FKL2TE is
  port (
    M_ACLK : in STD_LOGIC;
    M_ARESETN : in STD_LOGIC;
    M_AXI_araddr : out STD_LOGIC_VECTOR ( 31 downto 0 );
    M_AXI_arready : in STD_LOGIC;
    M_AXI_arvalid : out STD_LOGIC;
    M_AXI_awaddr : out STD_LOGIC_VECTOR ( 31 downto 0 );
    M_AXI_awready : in STD_LOGIC;
    M_AXI_awvalid : out STD_LOGIC;
    M_AXI_bready : out STD_LOGIC;
    M_AXI_bresp : in STD_LOGIC_VECTOR ( 1 downto 0 );
    M_AXI_bvalid : in STD_LOGIC;
    M_AXI_rdata : in STD_LOGIC_VECTOR ( 31 downto 0 );
    M_AXI_rready : out STD_LOGIC;
    M_AXI_rresp : in STD_LOGIC_VECTOR ( 1 downto 0 );
    M_AXI_rvalid : in STD_LOGIC;
    M_AXI_wdata : out STD_LOGIC_VECTOR ( 31 downto 0 );
    M_AXI_wready : in STD_LOGIC;
    M_AXI_wstrb : out STD_LOGIC_VECTOR ( 3 downto 0 );
    M_AXI_wvalid : out STD_LOGIC;
    S_ACLK : in STD_LOGIC;
    S_ARESETN : in STD_LOGIC;
    S_AXI_araddr : in STD_LOGIC_VECTOR ( 31 downto 0 );
    S_AXI_arready : out STD_LOGIC;
    S_AXI_arvalid : in STD_LOGIC;
    S_AXI_awaddr : in STD_LOGIC_VECTOR ( 31 downto 0 );
    S_AXI_awready : out STD_LOGIC;
    S_AXI_awvalid : in STD_LOGIC;
    S_AXI_bready : in STD_LOGIC;
    S_AXI_bresp : out STD_LOGIC_VECTOR ( 1 downto 0 );
    S_AXI_bvalid : out STD_LOGIC;
    S_AXI_rdata : out STD_LOGIC_VECTOR ( 31 downto 0 );
    S_AXI_rready : in STD_LOGIC;
    S_AXI_rresp : out STD_LOGIC_VECTOR ( 1 downto 0 );
    S_AXI_rvalid : out STD_LOGIC;
    S_AXI_wdata : in STD_LOGIC_VECTOR ( 31 downto 0 );
    S_AXI_wready : out STD_LOGIC;
    S_AXI_wstrb : in STD_LOGIC_VECTOR ( 3 downto 0 );
    S_AXI_wvalid : in STD_LOGIC
  );
end m02_couplers_imp_FKL2TE;

architecture STRUCTURE of m02_couplers_imp_FKL2TE is
  signal m02_couplers_to_m02_couplers_ARADDR : STD_LOGIC_VECTOR ( 31 downto 0 );
  signal m02_couplers_to_m02_couplers_ARREADY : STD_LOGIC;
  signal m02_couplers_to_m02_couplers_ARVALID : STD_LOGIC;
  signal m02_couplers_to_m02_couplers_AWADDR : STD_LOGIC_VECTOR ( 31 downto 0 );
  signal m02_couplers_to_m02_couplers_AWREADY : STD_LOGIC;
  signal m02_couplers_to_m02_couplers_AWVALID : STD_LOGIC;
  signal m02_couplers_to_m02_couplers_BREADY : STD_LOGIC;
  signal m02_couplers_to_m02_couplers_BRESP : STD_LOGIC_VECTOR ( 1 downto 0 );
  signal m02_couplers_to_m02_couplers_BVALID : STD_LOGIC;
  signal m02_couplers_to_m02_couplers_RDATA : STD_LOGIC_VECTOR ( 31 downto 0 );
  signal m02_couplers_to_m02_couplers_RREADY : STD_LOGIC;
  signal m02_couplers_to_m02_couplers_RRESP : STD_LOGIC_VECTOR ( 1 downto 0 );
  signal m02_couplers_to_m02_couplers_RVALID : STD_LOGIC;
  signal m02_couplers_to_m02_couplers_WDATA : STD_LOGIC_VECTOR ( 31 downto 0 );
  signal m02_couplers_to_m02_couplers_WREADY : STD_LOGIC;
  signal m02_couplers_to_m02_couplers_WSTRB : STD_LOGIC_VECTOR ( 3 downto 0 );
  signal m02_couplers_to_m02_couplers_WVALID : STD_LOGIC;
begin
  M_AXI_araddr(31 downto 0) <= m02_couplers_to_m02_couplers_ARADDR(31 downto 0);
  M_AXI_arvalid <= m02_couplers_to_m02_couplers_ARVALID;
  M_AXI_awaddr(31 downto 0) <= m02_couplers_to_m02_couplers_AWADDR(31 downto 0);
  M_AXI_awvalid <= m02_couplers_to_m02_couplers_AWVALID;
  M_AXI_bready <= m02_couplers_to_m02_couplers_BREADY;
  M_AXI_rready <= m02_couplers_to_m02_couplers_RREADY;
  M_AXI_wdata(31 downto 0) <= m02_couplers_to_m02_couplers_WDATA(31 downto 0);
  M_AXI_wstrb(3 downto 0) <= m02_couplers_to_m02_couplers_WSTRB(3 downto 0);
  M_AXI_wvalid <= m02_couplers_to_m02_couplers_WVALID;
  S_AXI_arready <= m02_couplers_to_m02_couplers_ARREADY;
  S_AXI_awready <= m02_couplers_to_m02_couplers_AWREADY;
  S_AXI_bresp(1 downto 0) <= m02_couplers_to_m02_couplers_BRESP(1 downto 0);
  S_AXI_bvalid <= m02_couplers_to_m02_couplers_BVALID;
  S_AXI_rdata(31 downto 0) <= m02_couplers_to_m02_couplers_RDATA(31 downto 0);
  S_AXI_rresp(1 downto 0) <= m02_couplers_to_m02_couplers_RRESP(1 downto 0);
  S_AXI_rvalid <= m02_couplers_to_m02_couplers_RVALID;
  S_AXI_wready <= m02_couplers_to_m02_couplers_WREADY;
  m02_couplers_to_m02_couplers_ARADDR(31 downto 0) <= S_AXI_araddr(31 downto 0);
  m02_couplers_to_m02_couplers_ARREADY <= M_AXI_arready;
  m02_couplers_to_m02_couplers_ARVALID <= S_AXI_arvalid;
  m02_couplers_to_m02_couplers_AWADDR(31 downto 0) <= S_AXI_awaddr(31 downto 0);
  m02_couplers_to_m02_couplers_AWREADY <= M_AXI_awready;
  m02_couplers_to_m02_couplers_AWVALID <= S_AXI_awvalid;
  m02_couplers_to_m02_couplers_BREADY <= S_AXI_bready;
  m02_couplers_to_m02_couplers_BRESP(1 downto 0) <= M_AXI_bresp(1 downto 0);
  m02_couplers_to_m02_couplers_BVALID <= M_AXI_bvalid;
  m02_couplers_to_m02_couplers_RDATA(31 downto 0) <= M_AXI_rdata(31 downto 0);
  m02_couplers_to_m02_couplers_RREADY <= S_AXI_rready;
  m02_couplers_to_m02_couplers_RRESP(1 downto 0) <= M_AXI_rresp(1 downto 0);
  m02_couplers_to_m02_couplers_RVALID <= M_AXI_rvalid;
  m02_couplers_to_m02_couplers_WDATA(31 downto 0) <= S_AXI_wdata(31 downto 0);
  m02_couplers_to_m02_couplers_WREADY <= M_AXI_wready;
  m02_couplers_to_m02_couplers_WSTRB(3 downto 0) <= S_AXI_wstrb(3 downto 0);
  m02_couplers_to_m02_couplers_WVALID <= S_AXI_wvalid;
end STRUCTURE;
library IEEE;
use IEEE.STD_LOGIC_1164.ALL;
library UNISIM;
use UNISIM.VCOMPONENTS.ALL;
entity s00_couplers_imp_11SE3QO is
  port (
    M_ACLK : in STD_LOGIC;
    M_ARESETN : in STD_LOGIC;
    M_AXI_araddr : out STD_LOGIC_VECTOR ( 31 downto 0 );
    M_AXI_arprot : out STD_LOGIC_VECTOR ( 2 downto 0 );
    M_AXI_arready : in STD_LOGIC;
    M_AXI_arvalid : out STD_LOGIC;
    M_AXI_awaddr : out STD_LOGIC_VECTOR ( 31 downto 0 );
    M_AXI_awprot : out STD_LOGIC_VECTOR ( 2 downto 0 );
    M_AXI_awready : in STD_LOGIC;
    M_AXI_awvalid : out STD_LOGIC;
    M_AXI_bready : out STD_LOGIC;
    M_AXI_bresp : in STD_LOGIC_VECTOR ( 1 downto 0 );
    M_AXI_bvalid : in STD_LOGIC;
    M_AXI_rdata : in STD_LOGIC_VECTOR ( 31 downto 0 );
    M_AXI_rready : out STD_LOGIC;
    M_AXI_rresp : in STD_LOGIC_VECTOR ( 1 downto 0 );
    M_AXI_rvalid : in STD_LOGIC;
    M_AXI_wdata : out STD_LOGIC_VECTOR ( 31 downto 0 );
    M_AXI_wready : in STD_LOGIC;
    M_AXI_wstrb : out STD_LOGIC_VECTOR ( 3 downto 0 );
    M_AXI_wvalid : out STD_LOGIC;
    S_ACLK : in STD_LOGIC;
    S_ARESETN : in STD_LOGIC;
    S_AXI_araddr : in STD_LOGIC_VECTOR ( 31 downto 0 );
    S_AXI_arburst : in STD_LOGIC_VECTOR ( 1 downto 0 );
    S_AXI_arcache : in STD_LOGIC_VECTOR ( 3 downto 0 );
    S_AXI_arid : in STD_LOGIC_VECTOR ( 11 downto 0 );
    S_AXI_arlen : in STD_LOGIC_VECTOR ( 3 downto 0 );
    S_AXI_arlock : in STD_LOGIC_VECTOR ( 1 downto 0 );
    S_AXI_arprot : in STD_LOGIC_VECTOR ( 2 downto 0 );
    S_AXI_arqos : in STD_LOGIC_VECTOR ( 3 downto 0 );
    S_AXI_arready : out STD_LOGIC;
    S_AXI_arsize : in STD_LOGIC_VECTOR ( 2 downto 0 );
    S_AXI_arvalid : in STD_LOGIC;
    S_AXI_awaddr : in STD_LOGIC_VECTOR ( 31 downto 0 );
    S_AXI_awburst : in STD_LOGIC_VECTOR ( 1 downto 0 );
    S_AXI_awcache : in STD_LOGIC_VECTOR ( 3 downto 0 );
    S_AXI_awid : in STD_LOGIC_VECTOR ( 11 downto 0 );
    S_AXI_awlen : in STD_LOGIC_VECTOR ( 3 downto 0 );
    S_AXI_awlock : in STD_LOGIC_VECTOR ( 1 downto 0 );
    S_AXI_awprot : in STD_LOGIC_VECTOR ( 2 downto 0 );
    S_AXI_awqos : in STD_LOGIC_VECTOR ( 3 downto 0 );
    S_AXI_awready : out STD_LOGIC;
    S_AXI_awsize : in STD_LOGIC_VECTOR ( 2 downto 0 );
    S_AXI_awvalid : in STD_LOGIC;
    S_AXI_bid : out STD_LOGIC_VECTOR ( 11 downto 0 );
    S_AXI_bready : in STD_LOGIC;
    S_AXI_bresp : out STD_LOGIC_VECTOR ( 1 downto 0 );
    S_AXI_bvalid : out STD_LOGIC;
    S_AXI_rdata : out STD_LOGIC_VECTOR ( 31 downto 0 );
    S_AXI_rid : out STD_LOGIC_VECTOR ( 11 downto 0 );
    S_AXI_rlast : out STD_LOGIC;
    S_AXI_rready : in STD_LOGIC;
    S_AXI_rresp : out STD_LOGIC_VECTOR ( 1 downto 0 );
    S_AXI_rvalid : out STD_LOGIC;
    S_AXI_wdata : in STD_LOGIC_VECTOR ( 31 downto 0 );
    S_AXI_wid : in STD_LOGIC_VECTOR ( 11 downto 0 );
    S_AXI_wlast : in STD_LOGIC;
    S_AXI_wready : out STD_LOGIC;
    S_AXI_wstrb : in STD_LOGIC_VECTOR ( 3 downto 0 );
    S_AXI_wvalid : in STD_LOGIC
  );
end s00_couplers_imp_11SE3QO;

architecture STRUCTURE of s00_couplers_imp_11SE3QO is
  component system_auto_pc_0 is
  port (
    aclk : in STD_LOGIC;
    aresetn : in STD_LOGIC;
    s_axi_awid : in STD_LOGIC_VECTOR ( 11 downto 0 );
    s_axi_awaddr : in STD_LOGIC_VECTOR ( 31 downto 0 );
    s_axi_awlen : in STD_LOGIC_VECTOR ( 3 downto 0 );
    s_axi_awsize : in STD_LOGIC_VECTOR ( 2 downto 0 );
    s_axi_awburst : in STD_LOGIC_VECTOR ( 1 downto 0 );
    s_axi_awlock : in STD_LOGIC_VECTOR ( 1 downto 0 );
    s_axi_awcache : in STD_LOGIC_VECTOR ( 3 downto 0 );
    s_axi_awprot : in STD_LOGIC_VECTOR ( 2 downto 0 );
    s_axi_awqos : in STD_LOGIC_VECTOR ( 3 downto 0 );
    s_axi_awvalid : in STD_LOGIC;
    s_axi_awready : out STD_LOGIC;
    s_axi_wid : in STD_LOGIC_VECTOR ( 11 downto 0 );
    s_axi_wdata : in STD_LOGIC_VECTOR ( 31 downto 0 );
    s_axi_wstrb : in STD_LOGIC_VECTOR ( 3 downto 0 );
    s_axi_wlast : in STD_LOGIC;
    s_axi_wvalid : in STD_LOGIC;
    s_axi_wready : out STD_LOGIC;
    s_axi_bid : out STD_LOGIC_VECTOR ( 11 downto 0 );
    s_axi_bresp : out STD_LOGIC_VECTOR ( 1 downto 0 );
    s_axi_bvalid : out STD_LOGIC;
    s_axi_bready : in STD_LOGIC;
    s_axi_arid : in STD_LOGIC_VECTOR ( 11 downto 0 );
    s_axi_araddr : in STD_LOGIC_VECTOR ( 31 downto 0 );
    s_axi_arlen : in STD_LOGIC_VECTOR ( 3 downto 0 );
    s_axi_arsize : in STD_LOGIC_VECTOR ( 2 downto 0 );
    s_axi_arburst : in STD_LOGIC_VECTOR ( 1 downto 0 );
    s_axi_arlock : in STD_LOGIC_VECTOR ( 1 downto 0 );
    s_axi_arcache : in STD_LOGIC_VECTOR ( 3 downto 0 );
    s_axi_arprot : in STD_LOGIC_VECTOR ( 2 downto 0 );
    s_axi_arqos : in STD_LOGIC_VECTOR ( 3 downto 0 );
    s_axi_arvalid : in STD_LOGIC;
    s_axi_arready : out STD_LOGIC;
    s_axi_rid : out STD_LOGIC_VECTOR ( 11 downto 0 );
    s_axi_rdata : out STD_LOGIC_VECTOR ( 31 downto 0 );
    s_axi_rresp : out STD_LOGIC_VECTOR ( 1 downto 0 );
    s_axi_rlast : out STD_LOGIC;
    s_axi_rvalid : out STD_LOGIC;
    s_axi_rready : in STD_LOGIC;
    m_axi_awaddr : out STD_LOGIC_VECTOR ( 31 downto 0 );
    m_axi_awprot : out STD_LOGIC_VECTOR ( 2 downto 0 );
    m_axi_awvalid : out STD_LOGIC;
    m_axi_awready : in STD_LOGIC;
    m_axi_wdata : out STD_LOGIC_VECTOR ( 31 downto 0 );
    m_axi_wstrb : out STD_LOGIC_VECTOR ( 3 downto 0 );
    m_axi_wvalid : out STD_LOGIC;
    m_axi_wready : in STD_LOGIC;
    m_axi_bresp : in STD_LOGIC_VECTOR ( 1 downto 0 );
    m_axi_bvalid : in STD_LOGIC;
    m_axi_bready : out STD_LOGIC;
    m_axi_araddr : out STD_LOGIC_VECTOR ( 31 downto 0 );
    m_axi_arprot : out STD_LOGIC_VECTOR ( 2 downto 0 );
    m_axi_arvalid : out STD_LOGIC;
    m_axi_arready : in STD_LOGIC;
    m_axi_rdata : in STD_LOGIC_VECTOR ( 31 downto 0 );
    m_axi_rresp : in STD_LOGIC_VECTOR ( 1 downto 0 );
    m_axi_rvalid : in STD_LOGIC;
    m_axi_rready : out STD_LOGIC
  );
  end component system_auto_pc_0;
  signal S_ACLK_1 : STD_LOGIC;
  signal S_ARESETN_1 : STD_LOGIC;
  signal auto_pc_to_s00_couplers_ARADDR : STD_LOGIC_VECTOR ( 31 downto 0 );
  signal auto_pc_to_s00_couplers_ARPROT : STD_LOGIC_VECTOR ( 2 downto 0 );
  signal auto_pc_to_s00_couplers_ARREADY : STD_LOGIC;
  signal auto_pc_to_s00_couplers_ARVALID : STD_LOGIC;
  signal auto_pc_to_s00_couplers_AWADDR : STD_LOGIC_VECTOR ( 31 downto 0 );
  signal auto_pc_to_s00_couplers_AWPROT : STD_LOGIC_VECTOR ( 2 downto 0 );
  signal auto_pc_to_s00_couplers_AWREADY : STD_LOGIC;
  signal auto_pc_to_s00_couplers_AWVALID : STD_LOGIC;
  signal auto_pc_to_s00_couplers_BREADY : STD_LOGIC;
  signal auto_pc_to_s00_couplers_BRESP : STD_LOGIC_VECTOR ( 1 downto 0 );
  signal auto_pc_to_s00_couplers_BVALID : STD_LOGIC;
  signal auto_pc_to_s00_couplers_RDATA : STD_LOGIC_VECTOR ( 31 downto 0 );
  signal auto_pc_to_s00_couplers_RREADY : STD_LOGIC;
  signal auto_pc_to_s00_couplers_RRESP : STD_LOGIC_VECTOR ( 1 downto 0 );
  signal auto_pc_to_s00_couplers_RVALID : STD_LOGIC;
  signal auto_pc_to_s00_couplers_WDATA : STD_LOGIC_VECTOR ( 31 downto 0 );
  signal auto_pc_to_s00_couplers_WREADY : STD_LOGIC;
  signal auto_pc_to_s00_couplers_WSTRB : STD_LOGIC_VECTOR ( 3 downto 0 );
  signal auto_pc_to_s00_couplers_WVALID : STD_LOGIC;
  signal s00_couplers_to_auto_pc_ARADDR : STD_LOGIC_VECTOR ( 31 downto 0 );
  signal s00_couplers_to_auto_pc_ARBURST : STD_LOGIC_VECTOR ( 1 downto 0 );
  signal s00_couplers_to_auto_pc_ARCACHE : STD_LOGIC_VECTOR ( 3 downto 0 );
  signal s00_couplers_to_auto_pc_ARID : STD_LOGIC_VECTOR ( 11 downto 0 );
  signal s00_couplers_to_auto_pc_ARLEN : STD_LOGIC_VECTOR ( 3 downto 0 );
  signal s00_couplers_to_auto_pc_ARLOCK : STD_LOGIC_VECTOR ( 1 downto 0 );
  signal s00_couplers_to_auto_pc_ARPROT : STD_LOGIC_VECTOR ( 2 downto 0 );
  signal s00_couplers_to_auto_pc_ARQOS : STD_LOGIC_VECTOR ( 3 downto 0 );
  signal s00_couplers_to_auto_pc_ARREADY : STD_LOGIC;
  signal s00_couplers_to_auto_pc_ARSIZE : STD_LOGIC_VECTOR ( 2 downto 0 );
  signal s00_couplers_to_auto_pc_ARVALID : STD_LOGIC;
  signal s00_couplers_to_auto_pc_AWADDR : STD_LOGIC_VECTOR ( 31 downto 0 );
  signal s00_couplers_to_auto_pc_AWBURST : STD_LOGIC_VECTOR ( 1 downto 0 );
  signal s00_couplers_to_auto_pc_AWCACHE : STD_LOGIC_VECTOR ( 3 downto 0 );
  signal s00_couplers_to_auto_pc_AWID : STD_LOGIC_VECTOR ( 11 downto 0 );
  signal s00_couplers_to_auto_pc_AWLEN : STD_LOGIC_VECTOR ( 3 downto 0 );
  signal s00_couplers_to_auto_pc_AWLOCK : STD_LOGIC_VECTOR ( 1 downto 0 );
  signal s00_couplers_to_auto_pc_AWPROT : STD_LOGIC_VECTOR ( 2 downto 0 );
  signal s00_couplers_to_auto_pc_AWQOS : STD_LOGIC_VECTOR ( 3 downto 0 );
  signal s00_couplers_to_auto_pc_AWREADY : STD_LOGIC;
  signal s00_couplers_to_auto_pc_AWSIZE : STD_LOGIC_VECTOR ( 2 downto 0 );
  signal s00_couplers_to_auto_pc_AWVALID : STD_LOGIC;
  signal s00_couplers_to_auto_pc_BID : STD_LOGIC_VECTOR ( 11 downto 0 );
  signal s00_couplers_to_auto_pc_BREADY : STD_LOGIC;
  signal s00_couplers_to_auto_pc_BRESP : STD_LOGIC_VECTOR ( 1 downto 0 );
  signal s00_couplers_to_auto_pc_BVALID : STD_LOGIC;
  signal s00_couplers_to_auto_pc_RDATA : STD_LOGIC_VECTOR ( 31 downto 0 );
  signal s00_couplers_to_auto_pc_RID : STD_LOGIC_VECTOR ( 11 downto 0 );
  signal s00_couplers_to_auto_pc_RLAST : STD_LOGIC;
  signal s00_couplers_to_auto_pc_RREADY : STD_LOGIC;
  signal s00_couplers_to_auto_pc_RRESP : STD_LOGIC_VECTOR ( 1 downto 0 );
  signal s00_couplers_to_auto_pc_RVALID : STD_LOGIC;
  signal s00_couplers_to_auto_pc_WDATA : STD_LOGIC_VECTOR ( 31 downto 0 );
  signal s00_couplers_to_auto_pc_WID : STD_LOGIC_VECTOR ( 11 downto 0 );
  signal s00_couplers_to_auto_pc_WLAST : STD_LOGIC;
  signal s00_couplers_to_auto_pc_WREADY : STD_LOGIC;
  signal s00_couplers_to_auto_pc_WSTRB : STD_LOGIC_VECTOR ( 3 downto 0 );
  signal s00_couplers_to_auto_pc_WVALID : STD_LOGIC;
begin
  M_AXI_araddr(31 downto 0) <= auto_pc_to_s00_couplers_ARADDR(31 downto 0);
  M_AXI_arprot(2 downto 0) <= auto_pc_to_s00_couplers_ARPROT(2 downto 0);
  M_AXI_arvalid <= auto_pc_to_s00_couplers_ARVALID;
  M_AXI_awaddr(31 downto 0) <= auto_pc_to_s00_couplers_AWADDR(31 downto 0);
  M_AXI_awprot(2 downto 0) <= auto_pc_to_s00_couplers_AWPROT(2 downto 0);
  M_AXI_awvalid <= auto_pc_to_s00_couplers_AWVALID;
  M_AXI_bready <= auto_pc_to_s00_couplers_BREADY;
  M_AXI_rready <= auto_pc_to_s00_couplers_RREADY;
  M_AXI_wdata(31 downto 0) <= auto_pc_to_s00_couplers_WDATA(31 downto 0);
  M_AXI_wstrb(3 downto 0) <= auto_pc_to_s00_couplers_WSTRB(3 downto 0);
  M_AXI_wvalid <= auto_pc_to_s00_couplers_WVALID;
  S_ACLK_1 <= S_ACLK;
  S_ARESETN_1 <= S_ARESETN;
  S_AXI_arready <= s00_couplers_to_auto_pc_ARREADY;
  S_AXI_awready <= s00_couplers_to_auto_pc_AWREADY;
  S_AXI_bid(11 downto 0) <= s00_couplers_to_auto_pc_BID(11 downto 0);
  S_AXI_bresp(1 downto 0) <= s00_couplers_to_auto_pc_BRESP(1 downto 0);
  S_AXI_bvalid <= s00_couplers_to_auto_pc_BVALID;
  S_AXI_rdata(31 downto 0) <= s00_couplers_to_auto_pc_RDATA(31 downto 0);
  S_AXI_rid(11 downto 0) <= s00_couplers_to_auto_pc_RID(11 downto 0);
  S_AXI_rlast <= s00_couplers_to_auto_pc_RLAST;
  S_AXI_rresp(1 downto 0) <= s00_couplers_to_auto_pc_RRESP(1 downto 0);
  S_AXI_rvalid <= s00_couplers_to_auto_pc_RVALID;
  S_AXI_wready <= s00_couplers_to_auto_pc_WREADY;
  auto_pc_to_s00_couplers_ARREADY <= M_AXI_arready;
  auto_pc_to_s00_couplers_AWREADY <= M_AXI_awready;
  auto_pc_to_s00_couplers_BRESP(1 downto 0) <= M_AXI_bresp(1 downto 0);
  auto_pc_to_s00_couplers_BVALID <= M_AXI_bvalid;
  auto_pc_to_s00_couplers_RDATA(31 downto 0) <= M_AXI_rdata(31 downto 0);
  auto_pc_to_s00_couplers_RRESP(1 downto 0) <= M_AXI_rresp(1 downto 0);
  auto_pc_to_s00_couplers_RVALID <= M_AXI_rvalid;
  auto_pc_to_s00_couplers_WREADY <= M_AXI_wready;
  s00_couplers_to_auto_pc_ARADDR(31 downto 0) <= S_AXI_araddr(31 downto 0);
  s00_couplers_to_auto_pc_ARBURST(1 downto 0) <= S_AXI_arburst(1 downto 0);
  s00_couplers_to_auto_pc_ARCACHE(3 downto 0) <= S_AXI_arcache(3 downto 0);
  s00_couplers_to_auto_pc_ARID(11 downto 0) <= S_AXI_arid(11 downto 0);
  s00_couplers_to_auto_pc_ARLEN(3 downto 0) <= S_AXI_arlen(3 downto 0);
  s00_couplers_to_auto_pc_ARLOCK(1 downto 0) <= S_AXI_arlock(1 downto 0);
  s00_couplers_to_auto_pc_ARPROT(2 downto 0) <= S_AXI_arprot(2 downto 0);
  s00_couplers_to_auto_pc_ARQOS(3 downto 0) <= S_AXI_arqos(3 downto 0);
  s00_couplers_to_auto_pc_ARSIZE(2 downto 0) <= S_AXI_arsize(2 downto 0);
  s00_couplers_to_auto_pc_ARVALID <= S_AXI_arvalid;
  s00_couplers_to_auto_pc_AWADDR(31 downto 0) <= S_AXI_awaddr(31 downto 0);
  s00_couplers_to_auto_pc_AWBURST(1 downto 0) <= S_AXI_awburst(1 downto 0);
  s00_couplers_to_auto_pc_AWCACHE(3 downto 0) <= S_AXI_awcache(3 downto 0);
  s00_couplers_to_auto_pc_AWID(11 downto 0) <= S_AXI_awid(11 downto 0);
  s00_couplers_to_auto_pc_AWLEN(3 downto 0) <= S_AXI_awlen(3 downto 0);
  s00_couplers_to_auto_pc_AWLOCK(1 downto 0) <= S_AXI_awlock(1 downto 0);
  s00_couplers_to_auto_pc_AWPROT(2 downto 0) <= S_AXI_awprot(2 downto 0);
  s00_couplers_to_auto_pc_AWQOS(3 downto 0) <= S_AXI_awqos(3 downto 0);
  s00_couplers_to_auto_pc_AWSIZE(2 downto 0) <= S_AXI_awsize(2 downto 0);
  s00_couplers_to_auto_pc_AWVALID <= S_AXI_awvalid;
  s00_couplers_to_auto_pc_BREADY <= S_AXI_bready;
  s00_couplers_to_auto_pc_RREADY <= S_AXI_rready;
  s00_couplers_to_auto_pc_WDATA(31 downto 0) <= S_AXI_wdata(31 downto 0);
  s00_couplers_to_auto_pc_WID(11 downto 0) <= S_AXI_wid(11 downto 0);
  s00_couplers_to_auto_pc_WLAST <= S_AXI_wlast;
  s00_couplers_to_auto_pc_WSTRB(3 downto 0) <= S_AXI_wstrb(3 downto 0);
  s00_couplers_to_auto_pc_WVALID <= S_AXI_wvalid;
auto_pc: component system_auto_pc_0
     port map (
      aclk => S_ACLK_1,
      aresetn => S_ARESETN_1,
      m_axi_araddr(31 downto 0) => auto_pc_to_s00_couplers_ARADDR(31 downto 0),
      m_axi_arprot(2 downto 0) => auto_pc_to_s00_couplers_ARPROT(2 downto 0),
      m_axi_arready => auto_pc_to_s00_couplers_ARREADY,
      m_axi_arvalid => auto_pc_to_s00_couplers_ARVALID,
      m_axi_awaddr(31 downto 0) => auto_pc_to_s00_couplers_AWADDR(31 downto 0),
      m_axi_awprot(2 downto 0) => auto_pc_to_s00_couplers_AWPROT(2 downto 0),
      m_axi_awready => auto_pc_to_s00_couplers_AWREADY,
      m_axi_awvalid => auto_pc_to_s00_couplers_AWVALID,
      m_axi_bready => auto_pc_to_s00_couplers_BREADY,
      m_axi_bresp(1 downto 0) => auto_pc_to_s00_couplers_BRESP(1 downto 0),
      m_axi_bvalid => auto_pc_to_s00_couplers_BVALID,
      m_axi_rdata(31 downto 0) => auto_pc_to_s00_couplers_RDATA(31 downto 0),
      m_axi_rready => auto_pc_to_s00_couplers_RREADY,
      m_axi_rresp(1 downto 0) => auto_pc_to_s00_couplers_RRESP(1 downto 0),
      m_axi_rvalid => auto_pc_to_s00_couplers_RVALID,
      m_axi_wdata(31 downto 0) => auto_pc_to_s00_couplers_WDATA(31 downto 0),
      m_axi_wready => auto_pc_to_s00_couplers_WREADY,
      m_axi_wstrb(3 downto 0) => auto_pc_to_s00_couplers_WSTRB(3 downto 0),
      m_axi_wvalid => auto_pc_to_s00_couplers_WVALID,
      s_axi_araddr(31 downto 0) => s00_couplers_to_auto_pc_ARADDR(31 downto 0),
      s_axi_arburst(1 downto 0) => s00_couplers_to_auto_pc_ARBURST(1 downto 0),
      s_axi_arcache(3 downto 0) => s00_couplers_to_auto_pc_ARCACHE(3 downto 0),
      s_axi_arid(11 downto 0) => s00_couplers_to_auto_pc_ARID(11 downto 0),
      s_axi_arlen(3 downto 0) => s00_couplers_to_auto_pc_ARLEN(3 downto 0),
      s_axi_arlock(1 downto 0) => s00_couplers_to_auto_pc_ARLOCK(1 downto 0),
      s_axi_arprot(2 downto 0) => s00_couplers_to_auto_pc_ARPROT(2 downto 0),
      s_axi_arqos(3 downto 0) => s00_couplers_to_auto_pc_ARQOS(3 downto 0),
      s_axi_arready => s00_couplers_to_auto_pc_ARREADY,
      s_axi_arsize(2 downto 0) => s00_couplers_to_auto_pc_ARSIZE(2 downto 0),
      s_axi_arvalid => s00_couplers_to_auto_pc_ARVALID,
      s_axi_awaddr(31 downto 0) => s00_couplers_to_auto_pc_AWADDR(31 downto 0),
      s_axi_awburst(1 downto 0) => s00_couplers_to_auto_pc_AWBURST(1 downto 0),
      s_axi_awcache(3 downto 0) => s00_couplers_to_auto_pc_AWCACHE(3 downto 0),
      s_axi_awid(11 downto 0) => s00_couplers_to_auto_pc_AWID(11 downto 0),
      s_axi_awlen(3 downto 0) => s00_couplers_to_auto_pc_AWLEN(3 downto 0),
      s_axi_awlock(1 downto 0) => s00_couplers_to_auto_pc_AWLOCK(1 downto 0),
      s_axi_awprot(2 downto 0) => s00_couplers_to_auto_pc_AWPROT(2 downto 0),
      s_axi_awqos(3 downto 0) => s00_couplers_to_auto_pc_AWQOS(3 downto 0),
      s_axi_awready => s00_couplers_to_auto_pc_AWREADY,
      s_axi_awsize(2 downto 0) => s00_couplers_to_auto_pc_AWSIZE(2 downto 0),
      s_axi_awvalid => s00_couplers_to_auto_pc_AWVALID,
      s_axi_bid(11 downto 0) => s00_couplers_to_auto_pc_BID(11 downto 0),
      s_axi_bready => s00_couplers_to_auto_pc_BREADY,
      s_axi_bresp(1 downto 0) => s00_couplers_to_auto_pc_BRESP(1 downto 0),
      s_axi_bvalid => s00_couplers_to_auto_pc_BVALID,
      s_axi_rdata(31 downto 0) => s00_couplers_to_auto_pc_RDATA(31 downto 0),
      s_axi_rid(11 downto 0) => s00_couplers_to_auto_pc_RID(11 downto 0),
      s_axi_rlast => s00_couplers_to_auto_pc_RLAST,
      s_axi_rready => s00_couplers_to_auto_pc_RREADY,
      s_axi_rresp(1 downto 0) => s00_couplers_to_auto_pc_RRESP(1 downto 0),
      s_axi_rvalid => s00_couplers_to_auto_pc_RVALID,
      s_axi_wdata(31 downto 0) => s00_couplers_to_auto_pc_WDATA(31 downto 0),
      s_axi_wid(11 downto 0) => s00_couplers_to_auto_pc_WID(11 downto 0),
      s_axi_wlast => s00_couplers_to_auto_pc_WLAST,
      s_axi_wready => s00_couplers_to_auto_pc_WREADY,
      s_axi_wstrb(3 downto 0) => s00_couplers_to_auto_pc_WSTRB(3 downto 0),
      s_axi_wvalid => s00_couplers_to_auto_pc_WVALID
    );
end STRUCTURE;
library IEEE;
use IEEE.STD_LOGIC_1164.ALL;
library UNISIM;
use UNISIM.VCOMPONENTS.ALL;
entity system_ps7_0_axi_periph_1 is
  port (
    ACLK : in STD_LOGIC;
    ARESETN : in STD_LOGIC;
    M00_ACLK : in STD_LOGIC;
    M00_ARESETN : in STD_LOGIC;
    M00_AXI_araddr : out STD_LOGIC_VECTOR ( 31 downto 0 );
    M00_AXI_arprot : out STD_LOGIC_VECTOR ( 2 downto 0 );
    M00_AXI_arready : in STD_LOGIC_VECTOR ( 0 to 0 );
    M00_AXI_arvalid : out STD_LOGIC_VECTOR ( 0 to 0 );
    M00_AXI_awaddr : out STD_LOGIC_VECTOR ( 31 downto 0 );
    M00_AXI_awprot : out STD_LOGIC_VECTOR ( 2 downto 0 );
    M00_AXI_awready : in STD_LOGIC_VECTOR ( 0 to 0 );
    M00_AXI_awvalid : out STD_LOGIC_VECTOR ( 0 to 0 );
    M00_AXI_bready : out STD_LOGIC_VECTOR ( 0 to 0 );
    M00_AXI_bresp : in STD_LOGIC_VECTOR ( 1 downto 0 );
    M00_AXI_bvalid : in STD_LOGIC_VECTOR ( 0 to 0 );
    M00_AXI_rdata : in STD_LOGIC_VECTOR ( 31 downto 0 );
    M00_AXI_rready : out STD_LOGIC_VECTOR ( 0 to 0 );
    M00_AXI_rresp : in STD_LOGIC_VECTOR ( 1 downto 0 );
    M00_AXI_rvalid : in STD_LOGIC_VECTOR ( 0 to 0 );
    M00_AXI_wdata : out STD_LOGIC_VECTOR ( 31 downto 0 );
    M00_AXI_wready : in STD_LOGIC_VECTOR ( 0 to 0 );
    M00_AXI_wstrb : out STD_LOGIC_VECTOR ( 3 downto 0 );
    M00_AXI_wvalid : out STD_LOGIC_VECTOR ( 0 to 0 );
    M01_ACLK : in STD_LOGIC;
    M01_ARESETN : in STD_LOGIC;
    M01_AXI_araddr : out STD_LOGIC_VECTOR ( 31 downto 0 );
    M01_AXI_arready : in STD_LOGIC;
    M01_AXI_arvalid : out STD_LOGIC;
    M01_AXI_awaddr : out STD_LOGIC_VECTOR ( 31 downto 0 );
    M01_AXI_awready : in STD_LOGIC;
    M01_AXI_awvalid : out STD_LOGIC;
    M01_AXI_bready : out STD_LOGIC;
    M01_AXI_bresp : in STD_LOGIC_VECTOR ( 1 downto 0 );
    M01_AXI_bvalid : in STD_LOGIC;
    M01_AXI_rdata : in STD_LOGIC_VECTOR ( 31 downto 0 );
    M01_AXI_rready : out STD_LOGIC;
    M01_AXI_rresp : in STD_LOGIC_VECTOR ( 1 downto 0 );
    M01_AXI_rvalid : in STD_LOGIC;
    M01_AXI_wdata : out STD_LOGIC_VECTOR ( 31 downto 0 );
    M01_AXI_wready : in STD_LOGIC;
    M01_AXI_wstrb : out STD_LOGIC_VECTOR ( 3 downto 0 );
    M01_AXI_wvalid : out STD_LOGIC;
    M02_ACLK : in STD_LOGIC;
    M02_ARESETN : in STD_LOGIC;
    M02_AXI_araddr : out STD_LOGIC_VECTOR ( 31 downto 0 );
    M02_AXI_arready : in STD_LOGIC;
    M02_AXI_arvalid : out STD_LOGIC;
    M02_AXI_awaddr : out STD_LOGIC_VECTOR ( 31 downto 0 );
    M02_AXI_awready : in STD_LOGIC;
    M02_AXI_awvalid : out STD_LOGIC;
    M02_AXI_bready : out STD_LOGIC;
    M02_AXI_bresp : in STD_LOGIC_VECTOR ( 1 downto 0 );
    M02_AXI_bvalid : in STD_LOGIC;
    M02_AXI_rdata : in STD_LOGIC_VECTOR ( 31 downto 0 );
    M02_AXI_rready : out STD_LOGIC;
    M02_AXI_rresp : in STD_LOGIC_VECTOR ( 1 downto 0 );
    M02_AXI_rvalid : in STD_LOGIC;
    M02_AXI_wdata : out STD_LOGIC_VECTOR ( 31 downto 0 );
    M02_AXI_wready : in STD_LOGIC;
    M02_AXI_wstrb : out STD_LOGIC_VECTOR ( 3 downto 0 );
    M02_AXI_wvalid : out STD_LOGIC;
    S00_ACLK : in STD_LOGIC;
    S00_ARESETN : in STD_LOGIC;
    S00_AXI_araddr : in STD_LOGIC_VECTOR ( 31 downto 0 );
    S00_AXI_arburst : in STD_LOGIC_VECTOR ( 1 downto 0 );
    S00_AXI_arcache : in STD_LOGIC_VECTOR ( 3 downto 0 );
    S00_AXI_arid : in STD_LOGIC_VECTOR ( 11 downto 0 );
    S00_AXI_arlen : in STD_LOGIC_VECTOR ( 3 downto 0 );
    S00_AXI_arlock : in STD_LOGIC_VECTOR ( 1 downto 0 );
    S00_AXI_arprot : in STD_LOGIC_VECTOR ( 2 downto 0 );
    S00_AXI_arqos : in STD_LOGIC_VECTOR ( 3 downto 0 );
    S00_AXI_arready : out STD_LOGIC;
    S00_AXI_arsize : in STD_LOGIC_VECTOR ( 2 downto 0 );
    S00_AXI_arvalid : in STD_LOGIC;
    S00_AXI_awaddr : in STD_LOGIC_VECTOR ( 31 downto 0 );
    S00_AXI_awburst : in STD_LOGIC_VECTOR ( 1 downto 0 );
    S00_AXI_awcache : in STD_LOGIC_VECTOR ( 3 downto 0 );
    S00_AXI_awid : in STD_LOGIC_VECTOR ( 11 downto 0 );
    S00_AXI_awlen : in STD_LOGIC_VECTOR ( 3 downto 0 );
    S00_AXI_awlock : in STD_LOGIC_VECTOR ( 1 downto 0 );
    S00_AXI_awprot : in STD_LOGIC_VECTOR ( 2 downto 0 );
    S00_AXI_awqos : in STD_LOGIC_VECTOR ( 3 downto 0 );
    S00_AXI_awready : out STD_LOGIC;
    S00_AXI_awsize : in STD_LOGIC_VECTOR ( 2 downto 0 );
    S00_AXI_awvalid : in STD_LOGIC;
    S00_AXI_bid : out STD_LOGIC_VECTOR ( 11 downto 0 );
    S00_AXI_bready : in STD_LOGIC;
    S00_AXI_bresp : out STD_LOGIC_VECTOR ( 1 downto 0 );
    S00_AXI_bvalid : out STD_LOGIC;
    S00_AXI_rdata : out STD_LOGIC_VECTOR ( 31 downto 0 );
    S00_AXI_rid : out STD_LOGIC_VECTOR ( 11 downto 0 );
    S00_AXI_rlast : out STD_LOGIC;
    S00_AXI_rready : in STD_LOGIC;
    S00_AXI_rresp : out STD_LOGIC_VECTOR ( 1 downto 0 );
    S00_AXI_rvalid : out STD_LOGIC;
    S00_AXI_wdata : in STD_LOGIC_VECTOR ( 31 downto 0 );
    S00_AXI_wid : in STD_LOGIC_VECTOR ( 11 downto 0 );
    S00_AXI_wlast : in STD_LOGIC;
    S00_AXI_wready : out STD_LOGIC;
    S00_AXI_wstrb : in STD_LOGIC_VECTOR ( 3 downto 0 );
    S00_AXI_wvalid : in STD_LOGIC
  );
end system_ps7_0_axi_periph_1;

architecture STRUCTURE of system_ps7_0_axi_periph_1 is
  component system_xbar_0 is
  port (
    aclk : in STD_LOGIC;
    aresetn : in STD_LOGIC;
    s_axi_awaddr : in STD_LOGIC_VECTOR ( 31 downto 0 );
    s_axi_awprot : in STD_LOGIC_VECTOR ( 2 downto 0 );
    s_axi_awvalid : in STD_LOGIC_VECTOR ( 0 to 0 );
    s_axi_awready : out STD_LOGIC_VECTOR ( 0 to 0 );
    s_axi_wdata : in STD_LOGIC_VECTOR ( 31 downto 0 );
    s_axi_wstrb : in STD_LOGIC_VECTOR ( 3 downto 0 );
    s_axi_wvalid : in STD_LOGIC_VECTOR ( 0 to 0 );
    s_axi_wready : out STD_LOGIC_VECTOR ( 0 to 0 );
    s_axi_bresp : out STD_LOGIC_VECTOR ( 1 downto 0 );
    s_axi_bvalid : out STD_LOGIC_VECTOR ( 0 to 0 );
    s_axi_bready : in STD_LOGIC_VECTOR ( 0 to 0 );
    s_axi_araddr : in STD_LOGIC_VECTOR ( 31 downto 0 );
    s_axi_arprot : in STD_LOGIC_VECTOR ( 2 downto 0 );
    s_axi_arvalid : in STD_LOGIC_VECTOR ( 0 to 0 );
    s_axi_arready : out STD_LOGIC_VECTOR ( 0 to 0 );
    s_axi_rdata : out STD_LOGIC_VECTOR ( 31 downto 0 );
    s_axi_rresp : out STD_LOGIC_VECTOR ( 1 downto 0 );
    s_axi_rvalid : out STD_LOGIC_VECTOR ( 0 to 0 );
    s_axi_rready : in STD_LOGIC_VECTOR ( 0 to 0 );
    m_axi_awaddr : out STD_LOGIC_VECTOR ( 95 downto 0 );
    m_axi_awprot : out STD_LOGIC_VECTOR ( 8 downto 0 );
    m_axi_awvalid : out STD_LOGIC_VECTOR ( 2 downto 0 );
    m_axi_awready : in STD_LOGIC_VECTOR ( 2 downto 0 );
    m_axi_wdata : out STD_LOGIC_VECTOR ( 95 downto 0 );
    m_axi_wstrb : out STD_LOGIC_VECTOR ( 11 downto 0 );
    m_axi_wvalid : out STD_LOGIC_VECTOR ( 2 downto 0 );
    m_axi_wready : in STD_LOGIC_VECTOR ( 2 downto 0 );
    m_axi_bresp : in STD_LOGIC_VECTOR ( 5 downto 0 );
    m_axi_bvalid : in STD_LOGIC_VECTOR ( 2 downto 0 );
    m_axi_bready : out STD_LOGIC_VECTOR ( 2 downto 0 );
    m_axi_araddr : out STD_LOGIC_VECTOR ( 95 downto 0 );
    m_axi_arprot : out STD_LOGIC_VECTOR ( 8 downto 0 );
    m_axi_arvalid : out STD_LOGIC_VECTOR ( 2 downto 0 );
    m_axi_arready : in STD_LOGIC_VECTOR ( 2 downto 0 );
    m_axi_rdata : in STD_LOGIC_VECTOR ( 95 downto 0 );
    m_axi_rresp : in STD_LOGIC_VECTOR ( 5 downto 0 );
    m_axi_rvalid : in STD_LOGIC_VECTOR ( 2 downto 0 );
    m_axi_rready : out STD_LOGIC_VECTOR ( 2 downto 0 )
  );
  end component system_xbar_0;
  signal M00_ACLK_1 : STD_LOGIC;
  signal M00_ARESETN_1 : STD_LOGIC;
  signal M01_ACLK_1 : STD_LOGIC;
  signal M01_ARESETN_1 : STD_LOGIC;
  signal M02_ACLK_1 : STD_LOGIC;
  signal M02_ARESETN_1 : STD_LOGIC;
  signal S00_ACLK_1 : STD_LOGIC;
  signal S00_ARESETN_1 : STD_LOGIC;
  signal m00_couplers_to_ps7_0_axi_periph_ARADDR : STD_LOGIC_VECTOR ( 31 downto 0 );
  signal m00_couplers_to_ps7_0_axi_periph_ARPROT : STD_LOGIC_VECTOR ( 2 downto 0 );
  signal m00_couplers_to_ps7_0_axi_periph_ARREADY : STD_LOGIC_VECTOR ( 0 to 0 );
  signal m00_couplers_to_ps7_0_axi_periph_ARVALID : STD_LOGIC_VECTOR ( 0 to 0 );
  signal m00_couplers_to_ps7_0_axi_periph_AWADDR : STD_LOGIC_VECTOR ( 31 downto 0 );
  signal m00_couplers_to_ps7_0_axi_periph_AWPROT : STD_LOGIC_VECTOR ( 2 downto 0 );
  signal m00_couplers_to_ps7_0_axi_periph_AWREADY : STD_LOGIC_VECTOR ( 0 to 0 );
  signal m00_couplers_to_ps7_0_axi_periph_AWVALID : STD_LOGIC_VECTOR ( 0 to 0 );
  signal m00_couplers_to_ps7_0_axi_periph_BREADY : STD_LOGIC_VECTOR ( 0 to 0 );
  signal m00_couplers_to_ps7_0_axi_periph_BRESP : STD_LOGIC_VECTOR ( 1 downto 0 );
  signal m00_couplers_to_ps7_0_axi_periph_BVALID : STD_LOGIC_VECTOR ( 0 to 0 );
  signal m00_couplers_to_ps7_0_axi_periph_RDATA : STD_LOGIC_VECTOR ( 31 downto 0 );
  signal m00_couplers_to_ps7_0_axi_periph_RREADY : STD_LOGIC_VECTOR ( 0 to 0 );
  signal m00_couplers_to_ps7_0_axi_periph_RRESP : STD_LOGIC_VECTOR ( 1 downto 0 );
  signal m00_couplers_to_ps7_0_axi_periph_RVALID : STD_LOGIC_VECTOR ( 0 to 0 );
  signal m00_couplers_to_ps7_0_axi_periph_WDATA : STD_LOGIC_VECTOR ( 31 downto 0 );
  signal m00_couplers_to_ps7_0_axi_periph_WREADY : STD_LOGIC_VECTOR ( 0 to 0 );
  signal m00_couplers_to_ps7_0_axi_periph_WSTRB : STD_LOGIC_VECTOR ( 3 downto 0 );
  signal m00_couplers_to_ps7_0_axi_periph_WVALID : STD_LOGIC_VECTOR ( 0 to 0 );
  signal m01_couplers_to_ps7_0_axi_periph_ARADDR : STD_LOGIC_VECTOR ( 31 downto 0 );
  signal m01_couplers_to_ps7_0_axi_periph_ARREADY : STD_LOGIC;
  signal m01_couplers_to_ps7_0_axi_periph_ARVALID : STD_LOGIC;
  signal m01_couplers_to_ps7_0_axi_periph_AWADDR : STD_LOGIC_VECTOR ( 31 downto 0 );
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
  signal xbar_to_m00_couplers_RDATA : STD_LOGIC_VECTOR ( 31 downto 0 );
  signal xbar_to_m00_couplers_RREADY : STD_LOGIC_VECTOR ( 0 to 0 );
  signal xbar_to_m00_couplers_RRESP : STD_LOGIC_VECTOR ( 1 downto 0 );
  signal xbar_to_m00_couplers_RVALID : STD_LOGIC_VECTOR ( 0 to 0 );
  signal xbar_to_m00_couplers_WDATA : STD_LOGIC_VECTOR ( 31 downto 0 );
  signal xbar_to_m00_couplers_WREADY : STD_LOGIC_VECTOR ( 0 to 0 );
  signal xbar_to_m00_couplers_WSTRB : STD_LOGIC_VECTOR ( 3 downto 0 );
  signal xbar_to_m00_couplers_WVALID : STD_LOGIC_VECTOR ( 0 to 0 );
  signal xbar_to_m01_couplers_ARADDR : STD_LOGIC_VECTOR ( 63 downto 32 );
  signal xbar_to_m01_couplers_ARREADY : STD_LOGIC;
  signal xbar_to_m01_couplers_ARVALID : STD_LOGIC_VECTOR ( 1 to 1 );
  signal xbar_to_m01_couplers_AWADDR : STD_LOGIC_VECTOR ( 63 downto 32 );
  signal xbar_to_m01_couplers_AWREADY : STD_LOGIC;
  signal xbar_to_m01_couplers_AWVALID : STD_LOGIC_VECTOR ( 1 to 1 );
  signal xbar_to_m01_couplers_BREADY : STD_LOGIC_VECTOR ( 1 to 1 );
  signal xbar_to_m01_couplers_BRESP : STD_LOGIC_VECTOR ( 1 downto 0 );
  signal xbar_to_m01_couplers_BVALID : STD_LOGIC;
  signal xbar_to_m01_couplers_RDATA : STD_LOGIC_VECTOR ( 31 downto 0 );
  signal xbar_to_m01_couplers_RREADY : STD_LOGIC_VECTOR ( 1 to 1 );
  signal xbar_to_m01_couplers_RRESP : STD_LOGIC_VECTOR ( 1 downto 0 );
  signal xbar_to_m01_couplers_RVALID : STD_LOGIC;
  signal xbar_to_m01_couplers_WDATA : STD_LOGIC_VECTOR ( 63 downto 32 );
  signal xbar_to_m01_couplers_WREADY : STD_LOGIC;
  signal xbar_to_m01_couplers_WSTRB : STD_LOGIC_VECTOR ( 7 downto 4 );
  signal xbar_to_m01_couplers_WVALID : STD_LOGIC_VECTOR ( 1 to 1 );
  signal xbar_to_m02_couplers_ARADDR : STD_LOGIC_VECTOR ( 95 downto 64 );
  signal xbar_to_m02_couplers_ARREADY : STD_LOGIC;
  signal xbar_to_m02_couplers_ARVALID : STD_LOGIC_VECTOR ( 2 to 2 );
  signal xbar_to_m02_couplers_AWADDR : STD_LOGIC_VECTOR ( 95 downto 64 );
  signal xbar_to_m02_couplers_AWREADY : STD_LOGIC;
  signal xbar_to_m02_couplers_AWVALID : STD_LOGIC_VECTOR ( 2 to 2 );
  signal xbar_to_m02_couplers_BREADY : STD_LOGIC_VECTOR ( 2 to 2 );
  signal xbar_to_m02_couplers_BRESP : STD_LOGIC_VECTOR ( 1 downto 0 );
  signal xbar_to_m02_couplers_BVALID : STD_LOGIC;
  signal xbar_to_m02_couplers_RDATA : STD_LOGIC_VECTOR ( 31 downto 0 );
  signal xbar_to_m02_couplers_RREADY : STD_LOGIC_VECTOR ( 2 to 2 );
  signal xbar_to_m02_couplers_RRESP : STD_LOGIC_VECTOR ( 1 downto 0 );
  signal xbar_to_m02_couplers_RVALID : STD_LOGIC;
  signal xbar_to_m02_couplers_WDATA : STD_LOGIC_VECTOR ( 95 downto 64 );
  signal xbar_to_m02_couplers_WREADY : STD_LOGIC;
  signal xbar_to_m02_couplers_WSTRB : STD_LOGIC_VECTOR ( 11 downto 8 );
  signal xbar_to_m02_couplers_WVALID : STD_LOGIC_VECTOR ( 2 to 2 );
  signal NLW_xbar_m_axi_arprot_UNCONNECTED : STD_LOGIC_VECTOR ( 8 downto 3 );
  signal NLW_xbar_m_axi_awprot_UNCONNECTED : STD_LOGIC_VECTOR ( 8 downto 3 );
begin
  M00_ACLK_1 <= M00_ACLK;
  M00_ARESETN_1 <= M00_ARESETN;
  M00_AXI_araddr(31 downto 0) <= m00_couplers_to_ps7_0_axi_periph_ARADDR(31 downto 0);
  M00_AXI_arprot(2 downto 0) <= m00_couplers_to_ps7_0_axi_periph_ARPROT(2 downto 0);
  M00_AXI_arvalid(0) <= m00_couplers_to_ps7_0_axi_periph_ARVALID(0);
  M00_AXI_awaddr(31 downto 0) <= m00_couplers_to_ps7_0_axi_periph_AWADDR(31 downto 0);
  M00_AXI_awprot(2 downto 0) <= m00_couplers_to_ps7_0_axi_periph_AWPROT(2 downto 0);
  M00_AXI_awvalid(0) <= m00_couplers_to_ps7_0_axi_periph_AWVALID(0);
  M00_AXI_bready(0) <= m00_couplers_to_ps7_0_axi_periph_BREADY(0);
  M00_AXI_rready(0) <= m00_couplers_to_ps7_0_axi_periph_RREADY(0);
  M00_AXI_wdata(31 downto 0) <= m00_couplers_to_ps7_0_axi_periph_WDATA(31 downto 0);
  M00_AXI_wstrb(3 downto 0) <= m00_couplers_to_ps7_0_axi_periph_WSTRB(3 downto 0);
  M00_AXI_wvalid(0) <= m00_couplers_to_ps7_0_axi_periph_WVALID(0);
  M01_ACLK_1 <= M01_ACLK;
  M01_ARESETN_1 <= M01_ARESETN;
  M01_AXI_araddr(31 downto 0) <= m01_couplers_to_ps7_0_axi_periph_ARADDR(31 downto 0);
  M01_AXI_arvalid <= m01_couplers_to_ps7_0_axi_periph_ARVALID;
  M01_AXI_awaddr(31 downto 0) <= m01_couplers_to_ps7_0_axi_periph_AWADDR(31 downto 0);
  M01_AXI_awvalid <= m01_couplers_to_ps7_0_axi_periph_AWVALID;
  M01_AXI_bready <= m01_couplers_to_ps7_0_axi_periph_BREADY;
  M01_AXI_rready <= m01_couplers_to_ps7_0_axi_periph_RREADY;
  M01_AXI_wdata(31 downto 0) <= m01_couplers_to_ps7_0_axi_periph_WDATA(31 downto 0);
  M01_AXI_wstrb(3 downto 0) <= m01_couplers_to_ps7_0_axi_periph_WSTRB(3 downto 0);
  M01_AXI_wvalid <= m01_couplers_to_ps7_0_axi_periph_WVALID;
  M02_ACLK_1 <= M02_ACLK;
  M02_ARESETN_1 <= M02_ARESETN;
  M02_AXI_araddr(31 downto 0) <= m02_couplers_to_ps7_0_axi_periph_ARADDR(31 downto 0);
  M02_AXI_arvalid <= m02_couplers_to_ps7_0_axi_periph_ARVALID;
  M02_AXI_awaddr(31 downto 0) <= m02_couplers_to_ps7_0_axi_periph_AWADDR(31 downto 0);
  M02_AXI_awvalid <= m02_couplers_to_ps7_0_axi_periph_AWVALID;
  M02_AXI_bready <= m02_couplers_to_ps7_0_axi_periph_BREADY;
  M02_AXI_rready <= m02_couplers_to_ps7_0_axi_periph_RREADY;
  M02_AXI_wdata(31 downto 0) <= m02_couplers_to_ps7_0_axi_periph_WDATA(31 downto 0);
  M02_AXI_wstrb(3 downto 0) <= m02_couplers_to_ps7_0_axi_periph_WSTRB(3 downto 0);
  M02_AXI_wvalid <= m02_couplers_to_ps7_0_axi_periph_WVALID;
  S00_ACLK_1 <= S00_ACLK;
  S00_ARESETN_1 <= S00_ARESETN;
  S00_AXI_arready <= ps7_0_axi_periph_to_s00_couplers_ARREADY;
  S00_AXI_awready <= ps7_0_axi_periph_to_s00_couplers_AWREADY;
  S00_AXI_bid(11 downto 0) <= ps7_0_axi_periph_to_s00_couplers_BID(11 downto 0);
  S00_AXI_bresp(1 downto 0) <= ps7_0_axi_periph_to_s00_couplers_BRESP(1 downto 0);
  S00_AXI_bvalid <= ps7_0_axi_periph_to_s00_couplers_BVALID;
  S00_AXI_rdata(31 downto 0) <= ps7_0_axi_periph_to_s00_couplers_RDATA(31 downto 0);
  S00_AXI_rid(11 downto 0) <= ps7_0_axi_periph_to_s00_couplers_RID(11 downto 0);
  S00_AXI_rlast <= ps7_0_axi_periph_to_s00_couplers_RLAST;
  S00_AXI_rresp(1 downto 0) <= ps7_0_axi_periph_to_s00_couplers_RRESP(1 downto 0);
  S00_AXI_rvalid <= ps7_0_axi_periph_to_s00_couplers_RVALID;
  S00_AXI_wready <= ps7_0_axi_periph_to_s00_couplers_WREADY;
  m00_couplers_to_ps7_0_axi_periph_ARREADY(0) <= M00_AXI_arready(0);
  m00_couplers_to_ps7_0_axi_periph_AWREADY(0) <= M00_AXI_awready(0);
  m00_couplers_to_ps7_0_axi_periph_BRESP(1 downto 0) <= M00_AXI_bresp(1 downto 0);
  m00_couplers_to_ps7_0_axi_periph_BVALID(0) <= M00_AXI_bvalid(0);
  m00_couplers_to_ps7_0_axi_periph_RDATA(31 downto 0) <= M00_AXI_rdata(31 downto 0);
  m00_couplers_to_ps7_0_axi_periph_RRESP(1 downto 0) <= M00_AXI_rresp(1 downto 0);
  m00_couplers_to_ps7_0_axi_periph_RVALID(0) <= M00_AXI_rvalid(0);
  m00_couplers_to_ps7_0_axi_periph_WREADY(0) <= M00_AXI_wready(0);
  m01_couplers_to_ps7_0_axi_periph_ARREADY <= M01_AXI_arready;
  m01_couplers_to_ps7_0_axi_periph_AWREADY <= M01_AXI_awready;
  m01_couplers_to_ps7_0_axi_periph_BRESP(1 downto 0) <= M01_AXI_bresp(1 downto 0);
  m01_couplers_to_ps7_0_axi_periph_BVALID <= M01_AXI_bvalid;
  m01_couplers_to_ps7_0_axi_periph_RDATA(31 downto 0) <= M01_AXI_rdata(31 downto 0);
  m01_couplers_to_ps7_0_axi_periph_RRESP(1 downto 0) <= M01_AXI_rresp(1 downto 0);
  m01_couplers_to_ps7_0_axi_periph_RVALID <= M01_AXI_rvalid;
  m01_couplers_to_ps7_0_axi_periph_WREADY <= M01_AXI_wready;
  m02_couplers_to_ps7_0_axi_periph_ARREADY <= M02_AXI_arready;
  m02_couplers_to_ps7_0_axi_periph_AWREADY <= M02_AXI_awready;
  m02_couplers_to_ps7_0_axi_periph_BRESP(1 downto 0) <= M02_AXI_bresp(1 downto 0);
  m02_couplers_to_ps7_0_axi_periph_BVALID <= M02_AXI_bvalid;
  m02_couplers_to_ps7_0_axi_periph_RDATA(31 downto 0) <= M02_AXI_rdata(31 downto 0);
  m02_couplers_to_ps7_0_axi_periph_RRESP(1 downto 0) <= M02_AXI_rresp(1 downto 0);
  m02_couplers_to_ps7_0_axi_periph_RVALID <= M02_AXI_rvalid;
  m02_couplers_to_ps7_0_axi_periph_WREADY <= M02_AXI_wready;
  ps7_0_axi_periph_ACLK_net <= ACLK;
  ps7_0_axi_periph_ARESETN_net <= ARESETN;
  ps7_0_axi_periph_to_s00_couplers_ARADDR(31 downto 0) <= S00_AXI_araddr(31 downto 0);
  ps7_0_axi_periph_to_s00_couplers_ARBURST(1 downto 0) <= S00_AXI_arburst(1 downto 0);
  ps7_0_axi_periph_to_s00_couplers_ARCACHE(3 downto 0) <= S00_AXI_arcache(3 downto 0);
  ps7_0_axi_periph_to_s00_couplers_ARID(11 downto 0) <= S00_AXI_arid(11 downto 0);
  ps7_0_axi_periph_to_s00_couplers_ARLEN(3 downto 0) <= S00_AXI_arlen(3 downto 0);
  ps7_0_axi_periph_to_s00_couplers_ARLOCK(1 downto 0) <= S00_AXI_arlock(1 downto 0);
  ps7_0_axi_periph_to_s00_couplers_ARPROT(2 downto 0) <= S00_AXI_arprot(2 downto 0);
  ps7_0_axi_periph_to_s00_couplers_ARQOS(3 downto 0) <= S00_AXI_arqos(3 downto 0);
  ps7_0_axi_periph_to_s00_couplers_ARSIZE(2 downto 0) <= S00_AXI_arsize(2 downto 0);
  ps7_0_axi_periph_to_s00_couplers_ARVALID <= S00_AXI_arvalid;
  ps7_0_axi_periph_to_s00_couplers_AWADDR(31 downto 0) <= S00_AXI_awaddr(31 downto 0);
  ps7_0_axi_periph_to_s00_couplers_AWBURST(1 downto 0) <= S00_AXI_awburst(1 downto 0);
  ps7_0_axi_periph_to_s00_couplers_AWCACHE(3 downto 0) <= S00_AXI_awcache(3 downto 0);
  ps7_0_axi_periph_to_s00_couplers_AWID(11 downto 0) <= S00_AXI_awid(11 downto 0);
  ps7_0_axi_periph_to_s00_couplers_AWLEN(3 downto 0) <= S00_AXI_awlen(3 downto 0);
  ps7_0_axi_periph_to_s00_couplers_AWLOCK(1 downto 0) <= S00_AXI_awlock(1 downto 0);
  ps7_0_axi_periph_to_s00_couplers_AWPROT(2 downto 0) <= S00_AXI_awprot(2 downto 0);
  ps7_0_axi_periph_to_s00_couplers_AWQOS(3 downto 0) <= S00_AXI_awqos(3 downto 0);
  ps7_0_axi_periph_to_s00_couplers_AWSIZE(2 downto 0) <= S00_AXI_awsize(2 downto 0);
  ps7_0_axi_periph_to_s00_couplers_AWVALID <= S00_AXI_awvalid;
  ps7_0_axi_periph_to_s00_couplers_BREADY <= S00_AXI_bready;
  ps7_0_axi_periph_to_s00_couplers_RREADY <= S00_AXI_rready;
  ps7_0_axi_periph_to_s00_couplers_WDATA(31 downto 0) <= S00_AXI_wdata(31 downto 0);
  ps7_0_axi_periph_to_s00_couplers_WID(11 downto 0) <= S00_AXI_wid(11 downto 0);
  ps7_0_axi_periph_to_s00_couplers_WLAST <= S00_AXI_wlast;
  ps7_0_axi_periph_to_s00_couplers_WSTRB(3 downto 0) <= S00_AXI_wstrb(3 downto 0);
  ps7_0_axi_periph_to_s00_couplers_WVALID <= S00_AXI_wvalid;
m00_couplers: entity work.m00_couplers_imp_1H7AUOX
     port map (
      M_ACLK => M00_ACLK_1,
      M_ARESETN => M00_ARESETN_1,
      M_AXI_araddr(31 downto 0) => m00_couplers_to_ps7_0_axi_periph_ARADDR(31 downto 0),
      M_AXI_arprot(2 downto 0) => m00_couplers_to_ps7_0_axi_periph_ARPROT(2 downto 0),
      M_AXI_arready(0) => m00_couplers_to_ps7_0_axi_periph_ARREADY(0),
      M_AXI_arvalid(0) => m00_couplers_to_ps7_0_axi_periph_ARVALID(0),
      M_AXI_awaddr(31 downto 0) => m00_couplers_to_ps7_0_axi_periph_AWADDR(31 downto 0),
      M_AXI_awprot(2 downto 0) => m00_couplers_to_ps7_0_axi_periph_AWPROT(2 downto 0),
      M_AXI_awready(0) => m00_couplers_to_ps7_0_axi_periph_AWREADY(0),
      M_AXI_awvalid(0) => m00_couplers_to_ps7_0_axi_periph_AWVALID(0),
      M_AXI_bready(0) => m00_couplers_to_ps7_0_axi_periph_BREADY(0),
      M_AXI_bresp(1 downto 0) => m00_couplers_to_ps7_0_axi_periph_BRESP(1 downto 0),
      M_AXI_bvalid(0) => m00_couplers_to_ps7_0_axi_periph_BVALID(0),
      M_AXI_rdata(31 downto 0) => m00_couplers_to_ps7_0_axi_periph_RDATA(31 downto 0),
      M_AXI_rready(0) => m00_couplers_to_ps7_0_axi_periph_RREADY(0),
      M_AXI_rresp(1 downto 0) => m00_couplers_to_ps7_0_axi_periph_RRESP(1 downto 0),
      M_AXI_rvalid(0) => m00_couplers_to_ps7_0_axi_periph_RVALID(0),
      M_AXI_wdata(31 downto 0) => m00_couplers_to_ps7_0_axi_periph_WDATA(31 downto 0),
      M_AXI_wready(0) => m00_couplers_to_ps7_0_axi_periph_WREADY(0),
      M_AXI_wstrb(3 downto 0) => m00_couplers_to_ps7_0_axi_periph_WSTRB(3 downto 0),
      M_AXI_wvalid(0) => m00_couplers_to_ps7_0_axi_periph_WVALID(0),
      S_ACLK => ps7_0_axi_periph_ACLK_net,
      S_ARESETN => ps7_0_axi_periph_ARESETN_net,
      S_AXI_araddr(31 downto 0) => xbar_to_m00_couplers_ARADDR(31 downto 0),
      S_AXI_arprot(2 downto 0) => xbar_to_m00_couplers_ARPROT(2 downto 0),
      S_AXI_arready(0) => xbar_to_m00_couplers_ARREADY(0),
      S_AXI_arvalid(0) => xbar_to_m00_couplers_ARVALID(0),
      S_AXI_awaddr(31 downto 0) => xbar_to_m00_couplers_AWADDR(31 downto 0),
      S_AXI_awprot(2 downto 0) => xbar_to_m00_couplers_AWPROT(2 downto 0),
      S_AXI_awready(0) => xbar_to_m00_couplers_AWREADY(0),
      S_AXI_awvalid(0) => xbar_to_m00_couplers_AWVALID(0),
      S_AXI_bready(0) => xbar_to_m00_couplers_BREADY(0),
      S_AXI_bresp(1 downto 0) => xbar_to_m00_couplers_BRESP(1 downto 0),
      S_AXI_bvalid(0) => xbar_to_m00_couplers_BVALID(0),
      S_AXI_rdata(31 downto 0) => xbar_to_m00_couplers_RDATA(31 downto 0),
      S_AXI_rready(0) => xbar_to_m00_couplers_RREADY(0),
      S_AXI_rresp(1 downto 0) => xbar_to_m00_couplers_RRESP(1 downto 0),
      S_AXI_rvalid(0) => xbar_to_m00_couplers_RVALID(0),
      S_AXI_wdata(31 downto 0) => xbar_to_m00_couplers_WDATA(31 downto 0),
      S_AXI_wready(0) => xbar_to_m00_couplers_WREADY(0),
      S_AXI_wstrb(3 downto 0) => xbar_to_m00_couplers_WSTRB(3 downto 0),
      S_AXI_wvalid(0) => xbar_to_m00_couplers_WVALID(0)
    );
m01_couplers: entity work.m01_couplers_imp_4Y7TYO
     port map (
      M_ACLK => M01_ACLK_1,
      M_ARESETN => M01_ARESETN_1,
      M_AXI_araddr(31 downto 0) => m01_couplers_to_ps7_0_axi_periph_ARADDR(31 downto 0),
      M_AXI_arready => m01_couplers_to_ps7_0_axi_periph_ARREADY,
      M_AXI_arvalid => m01_couplers_to_ps7_0_axi_periph_ARVALID,
      M_AXI_awaddr(31 downto 0) => m01_couplers_to_ps7_0_axi_periph_AWADDR(31 downto 0),
      M_AXI_awready => m01_couplers_to_ps7_0_axi_periph_AWREADY,
      M_AXI_awvalid => m01_couplers_to_ps7_0_axi_periph_AWVALID,
      M_AXI_bready => m01_couplers_to_ps7_0_axi_periph_BREADY,
      M_AXI_bresp(1 downto 0) => m01_couplers_to_ps7_0_axi_periph_BRESP(1 downto 0),
      M_AXI_bvalid => m01_couplers_to_ps7_0_axi_periph_BVALID,
      M_AXI_rdata(31 downto 0) => m01_couplers_to_ps7_0_axi_periph_RDATA(31 downto 0),
      M_AXI_rready => m01_couplers_to_ps7_0_axi_periph_RREADY,
      M_AXI_rresp(1 downto 0) => m01_couplers_to_ps7_0_axi_periph_RRESP(1 downto 0),
      M_AXI_rvalid => m01_couplers_to_ps7_0_axi_periph_RVALID,
      M_AXI_wdata(31 downto 0) => m01_couplers_to_ps7_0_axi_periph_WDATA(31 downto 0),
      M_AXI_wready => m01_couplers_to_ps7_0_axi_periph_WREADY,
      M_AXI_wstrb(3 downto 0) => m01_couplers_to_ps7_0_axi_periph_WSTRB(3 downto 0),
      M_AXI_wvalid => m01_couplers_to_ps7_0_axi_periph_WVALID,
      S_ACLK => ps7_0_axi_periph_ACLK_net,
      S_ARESETN => ps7_0_axi_periph_ARESETN_net,
      S_AXI_araddr(31 downto 0) => xbar_to_m01_couplers_ARADDR(63 downto 32),
      S_AXI_arready => xbar_to_m01_couplers_ARREADY,
      S_AXI_arvalid => xbar_to_m01_couplers_ARVALID(1),
      S_AXI_awaddr(31 downto 0) => xbar_to_m01_couplers_AWADDR(63 downto 32),
      S_AXI_awready => xbar_to_m01_couplers_AWREADY,
      S_AXI_awvalid => xbar_to_m01_couplers_AWVALID(1),
      S_AXI_bready => xbar_to_m01_couplers_BREADY(1),
      S_AXI_bresp(1 downto 0) => xbar_to_m01_couplers_BRESP(1 downto 0),
      S_AXI_bvalid => xbar_to_m01_couplers_BVALID,
      S_AXI_rdata(31 downto 0) => xbar_to_m01_couplers_RDATA(31 downto 0),
      S_AXI_rready => xbar_to_m01_couplers_RREADY(1),
      S_AXI_rresp(1 downto 0) => xbar_to_m01_couplers_RRESP(1 downto 0),
      S_AXI_rvalid => xbar_to_m01_couplers_RVALID,
      S_AXI_wdata(31 downto 0) => xbar_to_m01_couplers_WDATA(63 downto 32),
      S_AXI_wready => xbar_to_m01_couplers_WREADY,
      S_AXI_wstrb(3 downto 0) => xbar_to_m01_couplers_WSTRB(7 downto 4),
      S_AXI_wvalid => xbar_to_m01_couplers_WVALID(1)
    );
m02_couplers: entity work.m02_couplers_imp_FKL2TE
     port map (
      M_ACLK => M02_ACLK_1,
      M_ARESETN => M02_ARESETN_1,
      M_AXI_araddr(31 downto 0) => m02_couplers_to_ps7_0_axi_periph_ARADDR(31 downto 0),
      M_AXI_arready => m02_couplers_to_ps7_0_axi_periph_ARREADY,
      M_AXI_arvalid => m02_couplers_to_ps7_0_axi_periph_ARVALID,
      M_AXI_awaddr(31 downto 0) => m02_couplers_to_ps7_0_axi_periph_AWADDR(31 downto 0),
      M_AXI_awready => m02_couplers_to_ps7_0_axi_periph_AWREADY,
      M_AXI_awvalid => m02_couplers_to_ps7_0_axi_periph_AWVALID,
      M_AXI_bready => m02_couplers_to_ps7_0_axi_periph_BREADY,
      M_AXI_bresp(1 downto 0) => m02_couplers_to_ps7_0_axi_periph_BRESP(1 downto 0),
      M_AXI_bvalid => m02_couplers_to_ps7_0_axi_periph_BVALID,
      M_AXI_rdata(31 downto 0) => m02_couplers_to_ps7_0_axi_periph_RDATA(31 downto 0),
      M_AXI_rready => m02_couplers_to_ps7_0_axi_periph_RREADY,
      M_AXI_rresp(1 downto 0) => m02_couplers_to_ps7_0_axi_periph_RRESP(1 downto 0),
      M_AXI_rvalid => m02_couplers_to_ps7_0_axi_periph_RVALID,
      M_AXI_wdata(31 downto 0) => m02_couplers_to_ps7_0_axi_periph_WDATA(31 downto 0),
      M_AXI_wready => m02_couplers_to_ps7_0_axi_periph_WREADY,
      M_AXI_wstrb(3 downto 0) => m02_couplers_to_ps7_0_axi_periph_WSTRB(3 downto 0),
      M_AXI_wvalid => m02_couplers_to_ps7_0_axi_periph_WVALID,
      S_ACLK => ps7_0_axi_periph_ACLK_net,
      S_ARESETN => ps7_0_axi_periph_ARESETN_net,
      S_AXI_araddr(31 downto 0) => xbar_to_m02_couplers_ARADDR(95 downto 64),
      S_AXI_arready => xbar_to_m02_couplers_ARREADY,
      S_AXI_arvalid => xbar_to_m02_couplers_ARVALID(2),
      S_AXI_awaddr(31 downto 0) => xbar_to_m02_couplers_AWADDR(95 downto 64),
      S_AXI_awready => xbar_to_m02_couplers_AWREADY,
      S_AXI_awvalid => xbar_to_m02_couplers_AWVALID(2),
      S_AXI_bready => xbar_to_m02_couplers_BREADY(2),
      S_AXI_bresp(1 downto 0) => xbar_to_m02_couplers_BRESP(1 downto 0),
      S_AXI_bvalid => xbar_to_m02_couplers_BVALID,
      S_AXI_rdata(31 downto 0) => xbar_to_m02_couplers_RDATA(31 downto 0),
      S_AXI_rready => xbar_to_m02_couplers_RREADY(2),
      S_AXI_rresp(1 downto 0) => xbar_to_m02_couplers_RRESP(1 downto 0),
      S_AXI_rvalid => xbar_to_m02_couplers_RVALID,
      S_AXI_wdata(31 downto 0) => xbar_to_m02_couplers_WDATA(95 downto 64),
      S_AXI_wready => xbar_to_m02_couplers_WREADY,
      S_AXI_wstrb(3 downto 0) => xbar_to_m02_couplers_WSTRB(11 downto 8),
      S_AXI_wvalid => xbar_to_m02_couplers_WVALID(2)
    );
s00_couplers: entity work.s00_couplers_imp_11SE3QO
     port map (
      M_ACLK => ps7_0_axi_periph_ACLK_net,
      M_ARESETN => ps7_0_axi_periph_ARESETN_net,
      M_AXI_araddr(31 downto 0) => s00_couplers_to_xbar_ARADDR(31 downto 0),
      M_AXI_arprot(2 downto 0) => s00_couplers_to_xbar_ARPROT(2 downto 0),
      M_AXI_arready => s00_couplers_to_xbar_ARREADY(0),
      M_AXI_arvalid => s00_couplers_to_xbar_ARVALID,
      M_AXI_awaddr(31 downto 0) => s00_couplers_to_xbar_AWADDR(31 downto 0),
      M_AXI_awprot(2 downto 0) => s00_couplers_to_xbar_AWPROT(2 downto 0),
      M_AXI_awready => s00_couplers_to_xbar_AWREADY(0),
      M_AXI_awvalid => s00_couplers_to_xbar_AWVALID,
      M_AXI_bready => s00_couplers_to_xbar_BREADY,
      M_AXI_bresp(1 downto 0) => s00_couplers_to_xbar_BRESP(1 downto 0),
      M_AXI_bvalid => s00_couplers_to_xbar_BVALID(0),
      M_AXI_rdata(31 downto 0) => s00_couplers_to_xbar_RDATA(31 downto 0),
      M_AXI_rready => s00_couplers_to_xbar_RREADY,
      M_AXI_rresp(1 downto 0) => s00_couplers_to_xbar_RRESP(1 downto 0),
      M_AXI_rvalid => s00_couplers_to_xbar_RVALID(0),
      M_AXI_wdata(31 downto 0) => s00_couplers_to_xbar_WDATA(31 downto 0),
      M_AXI_wready => s00_couplers_to_xbar_WREADY(0),
      M_AXI_wstrb(3 downto 0) => s00_couplers_to_xbar_WSTRB(3 downto 0),
      M_AXI_wvalid => s00_couplers_to_xbar_WVALID,
      S_ACLK => S00_ACLK_1,
      S_ARESETN => S00_ARESETN_1,
      S_AXI_araddr(31 downto 0) => ps7_0_axi_periph_to_s00_couplers_ARADDR(31 downto 0),
      S_AXI_arburst(1 downto 0) => ps7_0_axi_periph_to_s00_couplers_ARBURST(1 downto 0),
      S_AXI_arcache(3 downto 0) => ps7_0_axi_periph_to_s00_couplers_ARCACHE(3 downto 0),
      S_AXI_arid(11 downto 0) => ps7_0_axi_periph_to_s00_couplers_ARID(11 downto 0),
      S_AXI_arlen(3 downto 0) => ps7_0_axi_periph_to_s00_couplers_ARLEN(3 downto 0),
      S_AXI_arlock(1 downto 0) => ps7_0_axi_periph_to_s00_couplers_ARLOCK(1 downto 0),
      S_AXI_arprot(2 downto 0) => ps7_0_axi_periph_to_s00_couplers_ARPROT(2 downto 0),
      S_AXI_arqos(3 downto 0) => ps7_0_axi_periph_to_s00_couplers_ARQOS(3 downto 0),
      S_AXI_arready => ps7_0_axi_periph_to_s00_couplers_ARREADY,
      S_AXI_arsize(2 downto 0) => ps7_0_axi_periph_to_s00_couplers_ARSIZE(2 downto 0),
      S_AXI_arvalid => ps7_0_axi_periph_to_s00_couplers_ARVALID,
      S_AXI_awaddr(31 downto 0) => ps7_0_axi_periph_to_s00_couplers_AWADDR(31 downto 0),
      S_AXI_awburst(1 downto 0) => ps7_0_axi_periph_to_s00_couplers_AWBURST(1 downto 0),
      S_AXI_awcache(3 downto 0) => ps7_0_axi_periph_to_s00_couplers_AWCACHE(3 downto 0),
      S_AXI_awid(11 downto 0) => ps7_0_axi_periph_to_s00_couplers_AWID(11 downto 0),
      S_AXI_awlen(3 downto 0) => ps7_0_axi_periph_to_s00_couplers_AWLEN(3 downto 0),
      S_AXI_awlock(1 downto 0) => ps7_0_axi_periph_to_s00_couplers_AWLOCK(1 downto 0),
      S_AXI_awprot(2 downto 0) => ps7_0_axi_periph_to_s00_couplers_AWPROT(2 downto 0),
      S_AXI_awqos(3 downto 0) => ps7_0_axi_periph_to_s00_couplers_AWQOS(3 downto 0),
      S_AXI_awready => ps7_0_axi_periph_to_s00_couplers_AWREADY,
      S_AXI_awsize(2 downto 0) => ps7_0_axi_periph_to_s00_couplers_AWSIZE(2 downto 0),
      S_AXI_awvalid => ps7_0_axi_periph_to_s00_couplers_AWVALID,
      S_AXI_bid(11 downto 0) => ps7_0_axi_periph_to_s00_couplers_BID(11 downto 0),
      S_AXI_bready => ps7_0_axi_periph_to_s00_couplers_BREADY,
      S_AXI_bresp(1 downto 0) => ps7_0_axi_periph_to_s00_couplers_BRESP(1 downto 0),
      S_AXI_bvalid => ps7_0_axi_periph_to_s00_couplers_BVALID,
      S_AXI_rdata(31 downto 0) => ps7_0_axi_periph_to_s00_couplers_RDATA(31 downto 0),
      S_AXI_rid(11 downto 0) => ps7_0_axi_periph_to_s00_couplers_RID(11 downto 0),
      S_AXI_rlast => ps7_0_axi_periph_to_s00_couplers_RLAST,
      S_AXI_rready => ps7_0_axi_periph_to_s00_couplers_RREADY,
      S_AXI_rresp(1 downto 0) => ps7_0_axi_periph_to_s00_couplers_RRESP(1 downto 0),
      S_AXI_rvalid => ps7_0_axi_periph_to_s00_couplers_RVALID,
      S_AXI_wdata(31 downto 0) => ps7_0_axi_periph_to_s00_couplers_WDATA(31 downto 0),
      S_AXI_wid(11 downto 0) => ps7_0_axi_periph_to_s00_couplers_WID(11 downto 0),
      S_AXI_wlast => ps7_0_axi_periph_to_s00_couplers_WLAST,
      S_AXI_wready => ps7_0_axi_periph_to_s00_couplers_WREADY,
      S_AXI_wstrb(3 downto 0) => ps7_0_axi_periph_to_s00_couplers_WSTRB(3 downto 0),
      S_AXI_wvalid => ps7_0_axi_periph_to_s00_couplers_WVALID
    );
xbar: component system_xbar_0
     port map (
      aclk => ps7_0_axi_periph_ACLK_net,
      aresetn => ps7_0_axi_periph_ARESETN_net,
      m_axi_araddr(95 downto 64) => xbar_to_m02_couplers_ARADDR(95 downto 64),
      m_axi_araddr(63 downto 32) => xbar_to_m01_couplers_ARADDR(63 downto 32),
      m_axi_araddr(31 downto 0) => xbar_to_m00_couplers_ARADDR(31 downto 0),
      m_axi_arprot(8 downto 3) => NLW_xbar_m_axi_arprot_UNCONNECTED(8 downto 3),
      m_axi_arprot(2 downto 0) => xbar_to_m00_couplers_ARPROT(2 downto 0),
      m_axi_arready(2) => xbar_to_m02_couplers_ARREADY,
      m_axi_arready(1) => xbar_to_m01_couplers_ARREADY,
      m_axi_arready(0) => xbar_to_m00_couplers_ARREADY(0),
      m_axi_arvalid(2) => xbar_to_m02_couplers_ARVALID(2),
      m_axi_arvalid(1) => xbar_to_m01_couplers_ARVALID(1),
      m_axi_arvalid(0) => xbar_to_m00_couplers_ARVALID(0),
      m_axi_awaddr(95 downto 64) => xbar_to_m02_couplers_AWADDR(95 downto 64),
      m_axi_awaddr(63 downto 32) => xbar_to_m01_couplers_AWADDR(63 downto 32),
      m_axi_awaddr(31 downto 0) => xbar_to_m00_couplers_AWADDR(31 downto 0),
      m_axi_awprot(8 downto 3) => NLW_xbar_m_axi_awprot_UNCONNECTED(8 downto 3),
      m_axi_awprot(2 downto 0) => xbar_to_m00_couplers_AWPROT(2 downto 0),
      m_axi_awready(2) => xbar_to_m02_couplers_AWREADY,
      m_axi_awready(1) => xbar_to_m01_couplers_AWREADY,
      m_axi_awready(0) => xbar_to_m00_couplers_AWREADY(0),
      m_axi_awvalid(2) => xbar_to_m02_couplers_AWVALID(2),
      m_axi_awvalid(1) => xbar_to_m01_couplers_AWVALID(1),
      m_axi_awvalid(0) => xbar_to_m00_couplers_AWVALID(0),
      m_axi_bready(2) => xbar_to_m02_couplers_BREADY(2),
      m_axi_bready(1) => xbar_to_m01_couplers_BREADY(1),
      m_axi_bready(0) => xbar_to_m00_couplers_BREADY(0),
      m_axi_bresp(5 downto 4) => xbar_to_m02_couplers_BRESP(1 downto 0),
      m_axi_bresp(3 downto 2) => xbar_to_m01_couplers_BRESP(1 downto 0),
      m_axi_bresp(1 downto 0) => xbar_to_m00_couplers_BRESP(1 downto 0),
      m_axi_bvalid(2) => xbar_to_m02_couplers_BVALID,
      m_axi_bvalid(1) => xbar_to_m01_couplers_BVALID,
      m_axi_bvalid(0) => xbar_to_m00_couplers_BVALID(0),
      m_axi_rdata(95 downto 64) => xbar_to_m02_couplers_RDATA(31 downto 0),
      m_axi_rdata(63 downto 32) => xbar_to_m01_couplers_RDATA(31 downto 0),
      m_axi_rdata(31 downto 0) => xbar_to_m00_couplers_RDATA(31 downto 0),
      m_axi_rready(2) => xbar_to_m02_couplers_RREADY(2),
      m_axi_rready(1) => xbar_to_m01_couplers_RREADY(1),
      m_axi_rready(0) => xbar_to_m00_couplers_RREADY(0),
      m_axi_rresp(5 downto 4) => xbar_to_m02_couplers_RRESP(1 downto 0),
      m_axi_rresp(3 downto 2) => xbar_to_m01_couplers_RRESP(1 downto 0),
      m_axi_rresp(1 downto 0) => xbar_to_m00_couplers_RRESP(1 downto 0),
      m_axi_rvalid(2) => xbar_to_m02_couplers_RVALID,
      m_axi_rvalid(1) => xbar_to_m01_couplers_RVALID,
      m_axi_rvalid(0) => xbar_to_m00_couplers_RVALID(0),
      m_axi_wdata(95 downto 64) => xbar_to_m02_couplers_WDATA(95 downto 64),
      m_axi_wdata(63 downto 32) => xbar_to_m01_couplers_WDATA(63 downto 32),
      m_axi_wdata(31 downto 0) => xbar_to_m00_couplers_WDATA(31 downto 0),
      m_axi_wready(2) => xbar_to_m02_couplers_WREADY,
      m_axi_wready(1) => xbar_to_m01_couplers_WREADY,
      m_axi_wready(0) => xbar_to_m00_couplers_WREADY(0),
      m_axi_wstrb(11 downto 8) => xbar_to_m02_couplers_WSTRB(11 downto 8),
      m_axi_wstrb(7 downto 4) => xbar_to_m01_couplers_WSTRB(7 downto 4),
      m_axi_wstrb(3 downto 0) => xbar_to_m00_couplers_WSTRB(3 downto 0),
      m_axi_wvalid(2) => xbar_to_m02_couplers_WVALID(2),
      m_axi_wvalid(1) => xbar_to_m01_couplers_WVALID(1),
      m_axi_wvalid(0) => xbar_to_m00_couplers_WVALID(0),
      s_axi_araddr(31 downto 0) => s00_couplers_to_xbar_ARADDR(31 downto 0),
      s_axi_arprot(2 downto 0) => s00_couplers_to_xbar_ARPROT(2 downto 0),
      s_axi_arready(0) => s00_couplers_to_xbar_ARREADY(0),
      s_axi_arvalid(0) => s00_couplers_to_xbar_ARVALID,
      s_axi_awaddr(31 downto 0) => s00_couplers_to_xbar_AWADDR(31 downto 0),
      s_axi_awprot(2 downto 0) => s00_couplers_to_xbar_AWPROT(2 downto 0),
      s_axi_awready(0) => s00_couplers_to_xbar_AWREADY(0),
      s_axi_awvalid(0) => s00_couplers_to_xbar_AWVALID,
      s_axi_bready(0) => s00_couplers_to_xbar_BREADY,
      s_axi_bresp(1 downto 0) => s00_couplers_to_xbar_BRESP(1 downto 0),
      s_axi_bvalid(0) => s00_couplers_to_xbar_BVALID(0),
      s_axi_rdata(31 downto 0) => s00_couplers_to_xbar_RDATA(31 downto 0),
      s_axi_rready(0) => s00_couplers_to_xbar_RREADY,
      s_axi_rresp(1 downto 0) => s00_couplers_to_xbar_RRESP(1 downto 0),
      s_axi_rvalid(0) => s00_couplers_to_xbar_RVALID(0),
      s_axi_wdata(31 downto 0) => s00_couplers_to_xbar_WDATA(31 downto 0),
      s_axi_wready(0) => s00_couplers_to_xbar_WREADY(0),
      s_axi_wstrb(3 downto 0) => s00_couplers_to_xbar_WSTRB(3 downto 0),
      s_axi_wvalid(0) => s00_couplers_to_xbar_WVALID
    );
end STRUCTURE;
library IEEE;
use IEEE.STD_LOGIC_1164.ALL;
library UNISIM;
use UNISIM.VCOMPONENTS.ALL;
entity system is
  port (
    FCLK_100M_CLK : out STD_LOGIC;
    FCLK_50M_CLK : out STD_LOGIC;
    FIXED_IO_mio : inout STD_LOGIC_VECTOR ( 53 downto 0 );
    FIXED_IO_ps_clk : inout STD_LOGIC;
    FIXED_IO_ps_porb : inout STD_LOGIC;
    FIXED_IO_ps_srstb : inout STD_LOGIC;
    GT_SERIAL_TX_0_txn : out STD_LOGIC_VECTOR ( 0 to 0 );
    GT_SERIAL_TX_0_txp : out STD_LOGIC_VECTOR ( 0 to 0 );
    I2C_scl_i : in STD_LOGIC;
    I2C_scl_o : out STD_LOGIC;
    I2C_scl_t : out STD_LOGIC;
    I2C_sda_i : in STD_LOGIC;
    I2C_sda_o : out STD_LOGIC;
    I2C_sda_t : out STD_LOGIC;
    SPI0_io0_i : in STD_LOGIC;
    SPI0_io0_o : out STD_LOGIC;
    SPI0_io0_t : out STD_LOGIC;
    SPI0_io1_i : in STD_LOGIC;
    SPI0_io1_o : out STD_LOGIC;
    SPI0_io1_t : out STD_LOGIC;
    SPI0_sck_i : in STD_LOGIC;
    SPI0_sck_o : out STD_LOGIC;
    SPI0_sck_t : out STD_LOGIC;
    SPI0_ss_i : in STD_LOGIC_VECTOR ( 0 to 0 );
    SPI0_ss_o : out STD_LOGIC_VECTOR ( 0 to 0 );
    SPI0_ss_t : out STD_LOGIC;
    SPI1_io0_i : in STD_LOGIC;
    SPI1_io0_o : out STD_LOGIC;
    SPI1_io0_t : out STD_LOGIC;
    SPI1_io1_i : in STD_LOGIC;
    SPI1_io1_o : out STD_LOGIC;
    SPI1_io1_t : out STD_LOGIC;
    SPI1_sck_i : in STD_LOGIC;
    SPI1_sck_o : out STD_LOGIC;
    SPI1_sck_t : out STD_LOGIC;
    SPI1_ss_i : in STD_LOGIC_VECTOR ( 0 to 0 );
    SPI1_ss_o : out STD_LOGIC_VECTOR ( 0 to 0 );
    SPI1_ss_t : out STD_LOGIC;
    UART_rxd : in STD_LOGIC;
    UART_txd : out STD_LOGIC;
    aclken : in STD_LOGIC;
    aresetn : in STD_LOGIC;
    axis_enable : in STD_LOGIC;
    control_reg0_o : out STD_LOGIC_VECTOR ( 31 downto 0 );
    gt_refclk1_0 : in STD_LOGIC;
    gt_reset_0 : in STD_LOGIC;
    resetn_rtl : in STD_LOGIC;
    vid_io_in_0_active_video : in STD_LOGIC;
    vid_io_in_0_data : in STD_LOGIC_VECTOR ( 95 downto 0 );
    vid_io_in_0_field : in STD_LOGIC;
    vid_io_in_0_hblank : in STD_LOGIC;
    vid_io_in_0_hsync : in STD_LOGIC;
    vid_io_in_0_vblank : in STD_LOGIC;
    vid_io_in_0_vsync : in STD_LOGIC;
    vid_io_in_1_active_video : in STD_LOGIC;
    vid_io_in_1_data : in STD_LOGIC_VECTOR ( 95 downto 0 );
    vid_io_in_1_field : in STD_LOGIC;
    vid_io_in_1_hblank : in STD_LOGIC;
    vid_io_in_1_hsync : in STD_LOGIC;
    vid_io_in_1_vblank : in STD_LOGIC;
    vid_io_in_1_vsync : in STD_LOGIC;
    vid_io_in_ce : in STD_LOGIC;
    vid_io_in_clk : in STD_LOGIC;
    vid_io_in_reset : in STD_LOGIC
  );
  attribute CORE_GENERATION_INFO : string;
  attribute CORE_GENERATION_INFO of system : entity is "system,IP_Integrator,{x_ipVendor=xilinx.com,x_ipLibrary=BlockDiagram,x_ipName=system,x_ipVersion=1.00.a,x_ipLanguage=VHDL,numBlks=20,numReposBlks=15,numNonXlnxBlks=0,numHierBlks=5,maxHierDepth=0,numSysgenBlks=0,numHlsBlks=0,numHdlrefBlks=0,numPkgbdBlks=0,bdsource=USER,da_axi4_cnt=4,da_board_cnt=1,da_clkrst_cnt=8,da_ps7_cnt=1,synth_mode=Global}";
  attribute HW_HANDOFF : string;
  attribute HW_HANDOFF of system : entity is "system.hwdef";
end system;
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
