elhep/CMOS_Camera/(commit log)

2017-11-08 Adding initial
    [Interface_Connectors.SchDoc, PCB1.PcbDoc, Power.SchDoc, Sensor_Connectors.SchDoc, Sheet1.SchDoc, Spektrop2_Processor_Board_V1.PrjPcb, TOP.SchDoc, Zynq.SchDoc]
2017-11-14 Update of power schematics.
    [Power_Ver1.SchDoc]
2017-11-17 Zynq configuration pins are set.
    [CoaXPress.SchDoc, PCB1.PcbDoc, PCIe.SchDoc, SDI.SchDoc, Sensor_Connectors.SchDoc, Spektrop2_Processor_Board_V1.PrjPcb, TOP.SchDoc, Zynq_Config.SchDoc]
2017-11-17 Added a schematic template for A4.
    [CoaXPress.SchDoc, PCIe.SchDoc, Sensor_Connectors.SchDoc, Spektrop2_Processor_Board_V1.PrjPcb, TOP.SchDoc]
2017-11-17 Connected signals to the sensor board connectors.
    [CAM-DV-SENS_IMX035.PcbDoc, CoaXPress.SchDoc, PCB1.PcbDoc, PCIe.SchDoc, Power_Ver1.SchDoc, RS422_RS485.SchDoc, SDI.SchDoc, Sensor_Connectors.SchDoc]
2017-11-17 Update added SDI cable driver 6G-SDI GS6080.
    [CoaXPress.SchDoc, PCIe.SchDoc, SDI.SchDoc, Spektrop2.SchLib, Spektrop2_Processor_Board_V1.PrjPcb, Zynq_Config.SchDoc]
2017-11-18 Drawn the SDI interface and the TOP schematics.
    [CoaXPress.SchDoc, PCIe.SchDoc, Power_Ver1.SchDoc, RS422_RS485.SchDoc, SDI.SchDoc, Sensor_Connectors.SchDoc, Spektrop2.SchLib, Spektrop2_Processor_Board_V1.PrjPcb]
2017-11-19 Draft of the schematics done.
    [CAM-DV-SENS_IMX035.PcbDoc, CoaXPress.SchDoc, Interface_Connectors.SchDoc, PCB1.PcbDoc, PCIe.SchDoc, Power.SchDoc, Power_Ver1.SchDoc, Power_Ver2.SchDoc]
2017-11-19 Made the images as embedded on the schematics.
    [CoaXPress.SchDoc, RS485.SchDoc, SDI.SchDoc, TOP.SchDoc, Zynq_Config.SchDoc, Zynq_FPGA_Bank34.SchDoc, Zynq_PS.SchDoc, Zynq_Power.SchDoc]
2017-11-21 Corrected some errors. Added clock generator. Changed the connectors for PCIe and for RS495.
    [MGT_Clock_Generation.SchDoc, PCIe.SchDoc, Power.SchDoc, RS485.SchDoc, Spektrop2.SchLib, Spektrop2_Processor_Board_V1.PrjPcb, TOP.SchDoc, Zynq_Config.SchDoc]
2017-11-22 Update of the schematics for RS485 and clock generation for MGT transceivers.
    [MGT_Clock_Generation.SchDoc, Power.SchDoc, RS485.SchDoc, Sensor_Connectors.SchDoc, Spektrop2.SchLib, Spektrop2_Processor_Board_V1.PrjPcb, TOP.SchDoc, Zynq_FPGA_Bank13.SchDoc]
2017-11-22 Update of the designators. Corrected mode configuration for Zynq boot. Updated the MGT clock generation.
    [CoaXPress.SchDoc, MGT_Clock_Generation.SchDoc, PCIe.SchDoc, Power.SchDoc, RS485.SchDoc, SDI.SchDoc, Sensor_Connectors.SchDoc, Spektrop2_Processor_Board_V1.PrjPcb]
2017-11-23 Updated the schematics. Changed the flash to S25FL smaller footprint version.
    [CoaXPress.SchDoc, MGT_Clock_Generation.SchDoc, PCIe.SchDoc, Power.SchDoc, Power_Ver1.SchDoc, RS422_RS485.SchDoc, RS485.SchDoc, SDI.SchDoc]
2017-11-25 Updated the layout. Reannotated the schematics. Added boot mode switch for Zynq.
    [CoaXPress.SchDoc, MGT_Clock_Generation.SchDoc, PCIe.SchDoc, Power.SchDoc, RS485.SchDoc, SDI.SchDoc, Sensor_Connectors.SchDoc, TOP.SchDoc]
2017-11-25 Adding sensor board project.
    [Power.SchDoc, Processing_Board_Connectors.SchDoc, Sensor_CIS1910F.SchDoc, Sensor_CIS1910F_Power.SchDoc, Spektrop2_Sensor_Board_V1.PcbDoc, Spektrop2_Sensor_Board_V1.PrjPcb, TOP.SchDoc]
2017-11-25 Adding PCB file of processor board.
2017-11-25 Adding out job file for processor board.
2017-11-25 Moved files within the sensor folder.
    [Power.SchDoc, Processing_Board_Connectors.SchDoc, Sensor_CIS1910F.SchDoc, Sensor_CIS1910F_Power.SchDoc, Spektrop2_Sensor_Board_V1.PcbDoc, Spektrop2_Sensor_Board_V1.PrjPcb, TOP.SchDoc]
2017-11-27 Updated the power section of Sensor board.
    [CoaXPress.SchDoc, PCIe.SchDoc, Power.SchDoc, Spektrop2_Sensor_Board_V1.PrjPcb]
2017-11-28 Enabled the ADC on the Zynq processor board. Finished the power section of the CIS1910F sensor board.
    [Power.SchDoc, Sensor_CIS1910F.SchDoc, Sensor_CIS1910F_Power.SchDoc, Sensor_Connectors.SchDoc, Zynq_Config.SchDoc, Zynq_FPGA_Bank35.SchDoc, Zynq_Power.SchDoc]
2017-11-29 Adding project for Sensor board with CMV4000. Copied part of the schematics from an older project. Modified the connector signaling to support both sensors.
    [CMV4000.SchDoc, Power.SchDoc, Sensor_CIS1910F.SchDoc, Sensor_Connectors.SchDoc, Spektrop2_Processor_Board_V1.PrjPcb, Spektrop2_Sensor_Board_CMV4000_V1.PcbDoc, Spektrop2_Sensor_Board_CMV4000_V1.PrjPcb, Spektrop2_Sensor_Board_V1.PcbDoc]
2017-11-30 Updated the connector on the processing board. Signals have to be renamed.
    [Sensor_Connectors.SchDoc, Spektrop2_Sensor_Board_CMV4000_V1.PcbDoc, Spektrop2_Sensor_Board_V1.PcbDoc]
2017-12-01 Modified the signals on the banks. All banks are HR for Z7015 so additional termination has to be added for HSTL inputs.
    [PCIe.SchDoc, Power.SchDoc, Sensor_Connectors.SchDoc, Spektrop2_Processor_Board_V1.PrjPcb, TOP.SchDoc, Zynq_Config.SchDoc, Zynq_FPGA_Bank13.SchDoc, Zynq_FPGA_Bank34.SchDoc]
2017-12-01 Updated the signals for the connectors. Currently they are with the names of the signals to the sensors so that there are no mistakes. They will be changed to general ones.
    [CMV4000.SchDoc, Power.SchDoc, Sensor_CIS1910F.SchDoc, Sensor_Connectors.SchDoc, Spektrop2_Processor_Board_V1.PrjPcb, TOP.SchDoc, Zynq_Config.SchDoc, Zynq_FPGA_Bank13.SchDoc]
2017-12-02 Renamed the netnames to the connectors for the processor board. Updated the schematics for sensor board with CMV4000.
    [CMV4000.SchDoc, Power.SchDoc, Spektrop2_Processor_Board_V1.PrjPcb, Spektrop2_Sensor_Board_CMV4000_V1.PrjPcb, TOP.SchDoc, Zynq_FPGA_Bank13.SchDoc, Zynq_FPGA_Bank34.SchDoc, Zynq_FPGA_Bank35.SchDoc]
2017-12-03 Corrected mistakes pointed out by GK. Changed the connectors to 80 pin, so that there are more ground pins for better SI. Modified the power supply design so that it allows to power the CMV4000 senso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
    [CoaXPress.SchDoc, MGT_Clock_Generation.SchDoc, Power.SchDoc, RS485.SchDoc, SATA.SchDoc, SDI.SchDoc, Sensor_Board_Connectors_80_pin.SchDoc, Spektrop2_Processor_Board_V1.PrjPcb]
2017-12-04 Added UHD SDI Cable driver IC.
    [CoaXPress.SchDoc, Power.SchDoc, SATA.SchDoc, SDI.SchDoc, Sensor_Board_Connectors_80_pin.SchDoc, Spektrop2_Processor_Board_V1.PrjPcb, TOP.SchDoc, UHD_SDI.SchDoc]
2017-12-04 Corrected minor errors with netnames.
    [CoaXPress.SchDoc, MGT_Clock_Generation.SchDoc, Power.SchDoc, RS485.SchDoc, SATA.SchDoc, Sensor_Board_Connectors_80_pin.SchDoc, Spektrop2_Processor_Board_V1.PrjPcb, TOP.SchDoc]
2017-12-04 Corrected power section and reannotated the schematics. Corrected minor warnings.
    [CoaXPress.SchDoc, Power.SchDoc, RS485.SchDoc, SATA.SchDoc, Spektrop2_Processor_Board_V1.PrjPcb, TOP.SchDoc, UHD_SDI.SchDoc, Zynq_FPGA_Bank34.SchDoc]
2017-12-04 Preparing for layout, corrected some errors in the schematics. Two VCCO13 nets, added decoupling capacitors.
    [MGT_Clock_Generation.SchDoc, Processing_Board_Connectors.SchDoc, Sensor_Board_Connectors_80_pin.SchDoc, Spektrop2_Sensor_Board_V1.PcbDoc, TOP.SchDoc, UHD_SDI.SchDoc, Zynq_Power.SchDoc]
2017-12-05 Update of the layout.
    [MGT_Clock_Generation.SchDoc, Power.SchDoc, Zynq_MGT.SchDoc]
2017-12-05 Progressed layout.
    [Zynq_FPGA_Bank35.SchDoc]
2017-12-05 Update of layout.
    [Zynq_PS.SchDoc]
2017-12-07 Added different power supply with LTM4622.
    [Power.SchDoc, Power2.SchDoc, Spektrop2_Processor_Board_V1.PrjPcb, Zynq_Power.SchDoc]
2017-12-07 Update of the power supply. Corrected ERC errors. Expored to PCB.
    [Power.SchDoc, Power2.SchDoc, Spektrop2_Processor_Board_V1.PrjPcb, Zynq_PS.SchDoc]
2017-12-12 Layout update.
    [Spektrop2_Processor_Board_V1.PrjPcb]
2017-12-14 Testing whether the posistion of the FPGA can be opitmised to ease routing.
    [RS485.SchDoc, TOP.SchDoc, Zynq_FPGA_Bank35.SchDoc, Zynq_MGT.SchDoc, Zynq_PS.SchDoc, Zynq_Top.SchDoc]
2017-12-14 Adding draft of the layout with rotated FPGA. Changed schematics to take that into account. It should be much easier to router.
    [Sensor_Board_Connectors_80_pin.SchDoc, Zynq_FPGA_Bank34.SchDoc, Zynq_FPGA_Bank35.SchDoc, Zynq_FPGA_Unused.SchDoc]
2017-12-15 Updated power section removed IC10. No ECO, there was a problem with a library on my PC.
    [Power.SchDoc, Spektrop2_Processor_Board_V1.PrjPcb, TOP.SchDoc, Zynq_FPGA_Bank34.SchDoc, Zynq_FPGA_Bank35.SchDoc, Zynq_FPGA_Unused.SchDoc]
2017-12-16 Progressed layout. Had to change some nets from one board to board connector to another so that the reference voltage for those nets is also on the same connector.
    [Power.SchDoc, Sensor_Board_Connectors_80_pin.SchDoc, Spektrop2_Processor_Board_V1.PrjPcb, Zynq_Config.SchDoc, Zynq_FPGA_Bank34.SchDoc, Zynq_FPGA_Bank35.SchDoc, Zynq_MGT.SchDoc, Zynq_Power.SchDoc]
2017-12-17 Diff pairs routed.
    [Sensor_Board_Connectors_80_pin.SchDoc, Zynq_FPGA_Bank34.SchDoc]
2017-12-17 Progressed layout. Modified schematics accordingly.
    [Power.SchDoc, Sensor_Board_Connectors_80_pin.SchDoc, Zynq_Config.SchDoc, Zynq_FPGA_Bank13.SchDoc, Zynq_FPGA_Bank34.SchDoc, Zynq_FPGA_Bank35.SchDoc, Zynq_FPGA_Unused.SchDoc, Zynq_MGT.SchDoc]
2017-12-18 Performing DRC check.
    [MGT_Clock_Generation.SchDoc, Sensor_Board_Connectors_80_pin.SchDoc, Zynq_Config.SchDoc, Zynq_FPGA_Bank34.SchDoc, Zynq_FPGA_Bank35.SchDoc, Zynq_Top.SchDoc]
2017-12-18 Update of layout. Fixing errors.
    [Spektrop2_Processor_Board_V1.PrjPcb]
2017-12-18 Fixing DRC errors. Especially min solder mask sliver constraint.
    [Sensor_Board_Connectors_80_pin.SchDoc]
2017-12-19 DRC checked. Draft layout done.
    [Power.SchDoc, Spektrop2_Processor_Board_V1.PrjPcb]
2017-12-20 Update of the CMV4000 project. Updated schematics.
    [CMV4000.SchDoc, CMV4000_temp.SchDoc, Power.SchDoc, Processor_Board_Connectors.SchDoc, Processor_Board_Connectors_temp.SchDoc, Sensor_Board_Connectors_80_pin.SchDoc, Spektrop2_Sensor_Board_CMV4000_V1.PrjPcb, TOP.SchDoc]
2017-12-20 Update of the schematics, fixed compilation errors.
    [CMV4000.SchDoc, Power.SchDoc, Processor_Board_Connectors_temp.SchDoc, Spektrop2_Sensor_Board_CMV4000_V1.PrjPcb, TOP.SchDoc]
2017-12-20 Draft layout finished.
    [RS485.SchDoc]
2017-12-20 Corrected schematic errors. Changed Bank34 with 35 on the schematic page level.
    [FMC_CMOS_SENSOR.PcbDoc, MGT_Clock_Generation.SchDoc, Power.SchDoc, Sensor_Board_Connectors_80_pin.SchDoc, Spektrop2_Processor_Board_V1.PrjPcb, TOP.SchDoc, Zynq_Config.SchDoc, Zynq_FPGA_Bank34.SchDoc]
2017-12-21 Update. Changing the routing of the diff pairs for better clearance.
    [FMC_CMOS_SENSOR.PcbDoc, Sensor_Board_Connectors_80_pin.SchDoc]
2017-12-22 Fixing DRC.
    [UHD_SDI.SchDoc]
2017-12-27 Simulating P1V0 power plane.
    [CMV4000.SchDoc, MGT_Clock_Generation.SchDoc, Processor_Board_Connectors_temp.SchDoc, Sensor_Board_Connectors_80_pin.SchDoc]
2017-12-27 Simulating the DC drop on power planes.
2017-12-28 Changed stackup so that internal power plane is thicker for better power integrity. Has to modify the layout of the EQCO62T20.3, because the datasheet gives an example of the layout and I don't want 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
    [CoaXPress.SchDoc, Power.SchDoc]
2017-12-28 Adding Hyperlynx simulation files.
    [Power.SchDoc]
2017-12-31 Corrected some errors in the PCB. Continuing simulations.
    [Power.SchDoc]
2018-01-01 Updated layout in Processor board. Corrected minor errors in the schematics. Updated layout of the sensor CMV4000 board.
    [CMV4000.SchDoc, FMC_CMOS_SENSOR.PcbDoc, Power.SchDoc, Processor_Board_Connectors.SchDoc, Sensor_Board_Connectors_80_pin.SchDoc, Spektrop2_Processor_Board_V1.PrjPcb, Spektrop2_Sensor_Board_CMV4000_V1.PrjPcb, TOP.SchDoc]
2018-01-02 Update of layout of sensor board and the schematics.
    [CMV4000.SchDoc, FMC_CMOS_SENSOR.PcbDoc, Processor_Board_Connectors.SchDoc, TOP.SchDoc]
2018-01-02 Updated layout. DRC checked for sensor board.
    [CMV4000.SchDoc, FMC_CMOS_SENSOR.PcbDoc, Spektrop2_Sensor_Board_CMV4000_V1.PcbDoc, Spektrop2_Sensor_Board_CMV4000_V1.PrjPcb]
2018-01-02 Update of designators for sensor board.
    [CMV4000.SchDoc, Power.SchDoc, Processor_Board_Connectors.SchDoc, Spektrop2_Sensor_Board_CMV4000_V1.PcbDoc, Spektrop2_Sensor_Board_CMV4000_V1.PrjPcb]
2018-01-02 Update of layout. Added testpoints for power and spi.
    [CMV4000.SchDoc, Power.SchDoc, Spektrop2_Sensor_Board_CMV4000_V1.PcbDoc]
2018-01-02 Update of project files. Deleted old files. Started preparing the combined project for production.
    [CMV4000.SchDoc, CMV4000_temp.SchDoc, FMC_CMOS_SENSOR.PcbDoc, PCIe.SchDoc, Power2.SchDoc, Processor_Board_Connectors_temp.SchDoc, SDI.SchDoc, Sensor_Connectors.SchDoc]
2018-01-02 Modiyfing the project so that a combined version of the PCB can be made for production. Reannotating the design so that there are no identical designators on both boards.
    [CMV4000.SchDoc, CoaXPress.SchDoc, MGT_Clock_Generation.SchDoc, PCB1.PcbDoc, Power.SchDoc, Processor_Board_Connectors.SchDoc, RS485.SchDoc, SATA.SchDoc]
2018-01-02 Exported the Sensor board to the combined project for testing purposes.
    [Spektrop2_Sensor_Board_CMV4000_V1.PcbDoc, Zynq_Power.SchDoc]
2018-01-04 Updatech schematics and project files so that BOM is optimised. Moved HL files to a separate folder.
    [Power.SchDoc, RS485.SchDoc, Spektrop2_Processor_Board_V1.PrjPcb, Spektrop2_Sensor_Board_CMV4000_V1.PcbDoc, Spektrop2_Sensor_Board_CMV4000_V1.PrjPcb, UHD_SDI.SchDoc, Zynq_Config.SchDoc, Zynq_FPGA_Bank34.SchDoc]
2018-01-05 Modified the project so that Bank 35 is powered from 2.5V. This is needed in order to receive LVDS data and turn on DIFF_TERM and to transmitt data with LVDS.
    [Power.SchDoc, Zynq_FPGA_Bank34.SchDoc, Zynq_FPGA_Bank35.SchDoc, Zynq_Power.SchDoc]
2018-01-05 Update of schematics to correct the error.
    [Power.SchDoc, Spektrop2_Processor_Board_V1.PrjPcb]
2018-01-06 Update of layout. Changed JTAG connector to a 10 pin male.
    [Zynq_PS.SchDoc]
2018-01-07 Update of layout. Properly synchronised schematics. Some nets might need to be optimised.
    [Zynq_FPGA_Bank34.SchDoc, Zynq_FPGA_Bank35.SchDoc, Zynq_Top.SchDoc]
2018-01-08 Update of layout. Changed JTAG connector to a standard one. right angle.
    [Zynq_PS.SchDoc]
2018-01-09 Update of layout. Changed JTAG connector and added a separate one for UART.
    [Zynq_PS.SchDoc]
2018-01-11 Update of layout. Performing PI simulations.
    [Power.SchDoc, Zynq_PS.SchDoc]
2018-01-20 Adding results and simulation files.
    [FPGA_BANK35_DIFF17.txt, FPGA_BANK35_DIFF3.txt]
2018-01-21 Update of layout. Changed width of HSTL lines to be exactly 50 Ohms - better SI. Changed the differential pairs routing width and clearance on the sensor board.jak oszczędzać na mieszkanijak oszczędz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
2018-01-21 Added parameters to the schematics, fixed DRC for Processor PCB
    [CMV4000.SchDoc, Power.SchDoc, Processor_Board_Connectors.SchDoc, Spektrop2_Sensor_Board_CMV4000_V1.PcbDoc, TOP.SchDoc, TOP_PROC_BRD.SchDoc, UHD_SDI.SchDoc, Zynq_PS.SchDoc]
2018-01-21 Added stiching vias to gnd to sensor board. Updated soldermask for processor board.
    [Spektrop2_Sensor_Board_CMV4000_V1.PcbDoc]
2018-01-21 Added 3D model of the sensor board to proc board.
    [Spektrop2_Sensor_Board_CMV4000_V1.PcbDoc]
2018-01-22 Update of designators for the combined PCB.
    [Power.SchDoc, Spektrop2_Combined_Proc_CMV4000_V1.PrjPcb, Spektrop2_Processor_Board_V1.PrjPcb, Zynq_PS.SchDoc]
2018-01-22 Adding initial Vivado project.
    [pinout.csv]
2018-01-22 Update of combined board.
    [Spektrop2_Processor_Board_V1.PrjPcb]
2018-01-23 Adding production files for V1 of Spektrop board, combined proc and CMV4000.
    [Bill of Materials-Spektrop2_Combined_Proc_CMV4000_V1(Default).csv, Spektrop2_Combined_Proc_CMV4000_V1.PrjPcb, Spektrop2_Sensor_Board_CMV4000_V1.PcbDoc, Zynq_FPGA_Bank34.SchDoc]
2018-01-23 Update of outjob files.
    [Spektrop2_Combined_Proc_CMV4000_V1.PrjPcb]
2018-01-24 Update of boards with fixes.
    [Spektrop2_Sensor_Board_CMV4000_V1.PcbDoc, Zynq_FPGA_Bank34.SchDoc]
2018-01-24 Adding results of thermal simulations.
    [Spektrop2_Processor_Board_V1.PrjPcb]
2018-01-24 Adding Spektrop2 Sensor Board simulation files.
    [Spektrop2_Sensor_Board_CMV4000_V1.step]
2018-01-24 Adding simulation files for processor board.
2018-01-24 Adding board simulation files for multiboard project.
2018-01-25 Adding corrected combined board.
    [Spektrop2_Combined_Proc_CMV4000_V1.PrjPcb, Spektrop2_Sensor_Board_CMV4000_V1.PcbDoc, Zynq_FPGA_Bank34.SchDoc]
2018-01-25 Adding Geber and pick and place and board assembly view files.
    [Bill of Materials-Spektrop2_Combined_Proc_CMV4000_V1(Default).csv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]
2018-01-25 Adding production files in a separate location.
    [Spektrop2_Combined_Proc_CMV4000_V1.PrjPcb]
2018-01-26 Resolved some of the production issues.
    [Bill of Materials-Spektrop2_Combined_Proc_CMV4000_V1(Default).csv]
2018-01-27 Corrected combined board. Added fiducials.
    [Spektrop2_PCB_Combined_CMV4000_V1.GBL, Spektrop2_PCB_Combined_CMV4000_V1.GBO, Spektrop2_PCB_Combined_CMV4000_V1.GBP, Spektrop2_PCB_Combined_CMV4000_V1.GBS, Spektrop2_PCB_Combined_CMV4000_V1.GM1, Spektrop2_PCB_Combined_CMV4000_V1.GTL, Spektrop2_PCB_Combined_CMV4000_V1.GTO, Spektrop2_PCB_Combined_CMV4000_V1.GTP]
2018-01-27 Adding gerbers.
    [Spektrop2_Combined_Proc_CMV4000_V1.PrjPcb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]
2018-01-29 Update of spektrop project.
    [Bill of Materials-Spektrop2_Combined_Proc_CMV4000_V1(Default).csv]
2018-01-29 Updated the production files.
    [Spektrop2_PCB_Combined_CMV4000_V1.DRL, Spektrop2_PCB_Combined_CMV4000_V1.GBL, Spektrop2_PCB_Combined_CMV4000_V1.GBO, Spektrop2_PCB_Combined_CMV4000_V1.GBP, Spektrop2_PCB_Combined_CMV4000_V1.GBS, Spektrop2_PCB_Combined_CMV4000_V1.GM1, Spektrop2_PCB_Combined_CMV4000_V1.GTL, Spektrop2_PCB_Combined_CMV4000_V1.GTO]
2018-02-01 Corrected the layout. Generetd files for production.
    [Spektrop2_PCB_Combined_CMV4000_V1.DRL, Spektrop2_PCB_Combined_CMV4000_V1.GBL, Spektrop2_PCB_Combined_CMV4000_V1.GBO, Spektrop2_PCB_Combined_CMV4000_V1.GBP, Spektrop2_PCB_Combined_CMV4000_V1.GBS, Spektrop2_PCB_Combined_CMV4000_V1.GM1, Spektrop2_PCB_Combined_CMV4000_V1.GTL, Spektrop2_PCB_Combined_CMV4000_V1.GTO]
2018-02-05 Update of layout. Update of Vivado project.
    [Spektrop2_PCB_Combined_CMV4000_V1.DRL, Spektrop2_PCB_Combined_CMV4000_V1.GBL, Spektrop2_PCB_Combined_CMV4000_V1.GBO, Spektrop2_PCB_Combined_CMV4000_V1.GBP, Spektrop2_PCB_Combined_CMV4000_V1.GBS, Spektrop2_PCB_Combined_CMV4000_V1.GM1, Spektrop2_PCB_Combined_CMV4000_V1.GTL, Spektrop2_PCB_Combined_CMV4000_V1.GTO]
2018-02-05 Adding Vivado project, dummy led blink and a new one.
    [pinout.csv]
2018-02-12 Update of digital system. Added thesis template in latex.
    [myconfig.cfg]
2018-03-03 Removed history pcb files.
2018-03-10 Update of the layout, corrected errors in PCB layout.
    [Bill of Materials-Spektrop2_Combined_Proc_CMV4000_V1(Default).csv, Power.SchDoc, Spektrop2_Combined_Proc_CMV4000_V1.PrjPcb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]
